latino-deluxe/SPQR-Team-2019/spqr_portfolio/pics/Cattura.PNG

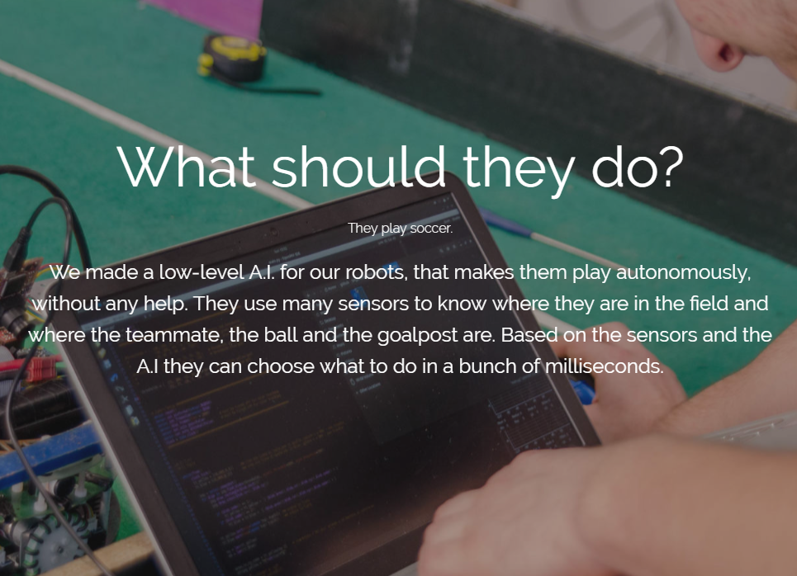
spqr_portfolio/pics/Cattura.PNG
