latino-deluxe/SPQR-Team-2019/spqr_portfolio/pics/DSC_0512_v1 (1).JPG

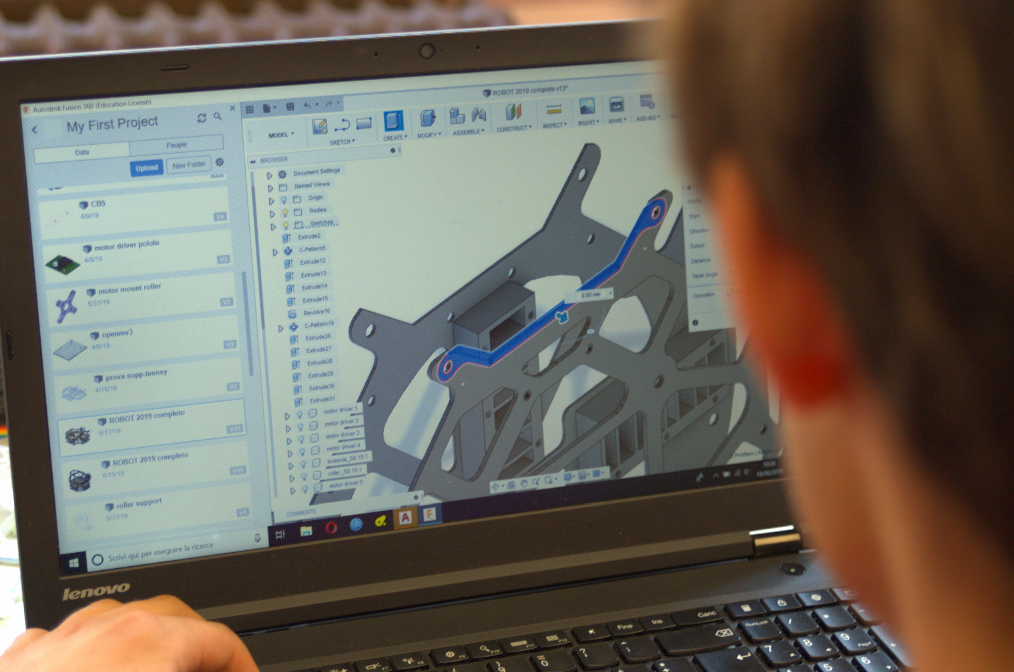
spqr_portfolio/pics/DSC_0512_v1 (1).JPG
