latino-deluxe/SPQR-Team-2019/README.md

# SPQR-Team-2019
Repo privata con il codice aggiornato dell'anno 2018-2019
