latino-deluxe/SPQR-Team-2019/damnpecette/pecette.odt

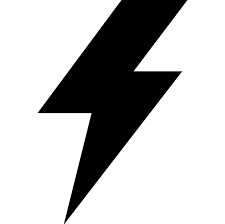
[picture p10: figure]

FURIO

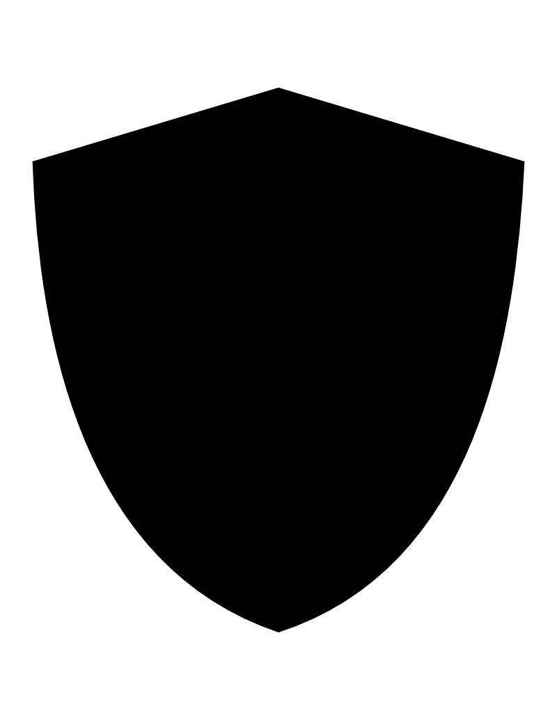
[picture p11: figure]

CORNELIA
