latino-deluxe/SPQR-Team-2019/bible/old_bible/robots.docx

SALVADOR

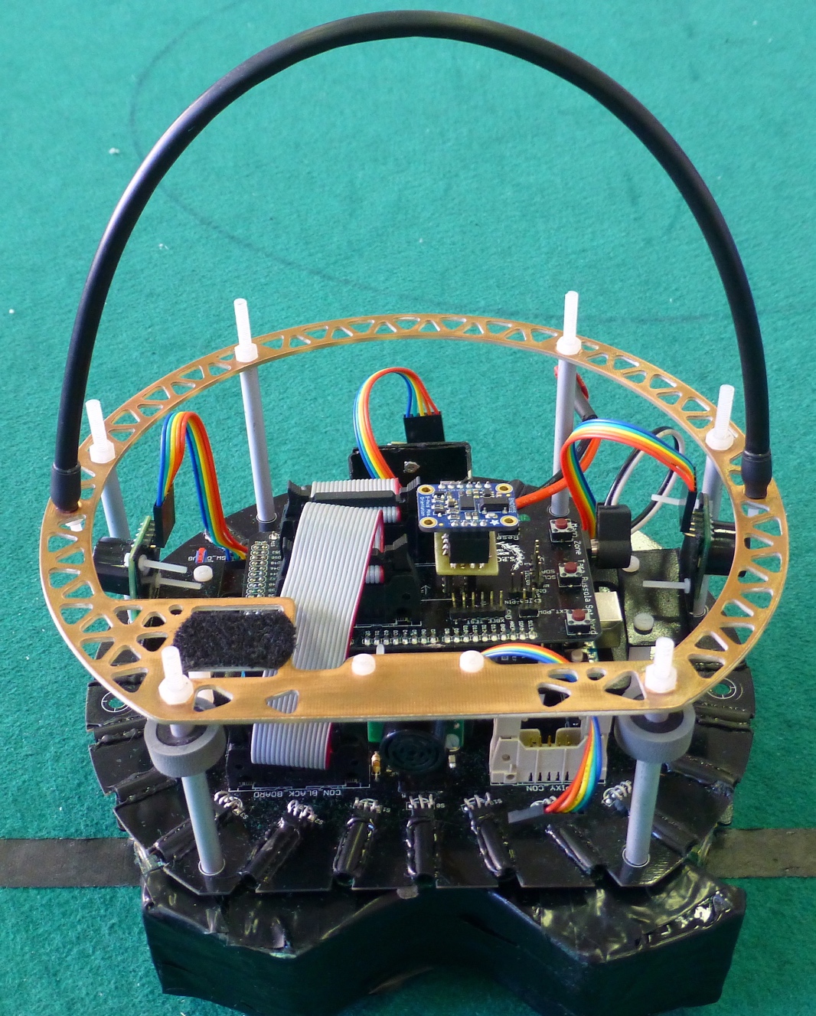
[picture p12: figure]

- Age: just born
- Role: goal keeper
- Electronics: New boards, IMU, line sensors
- Mechanics: New CAD design, handle and columns
- Software: New strategy

MANFREUS

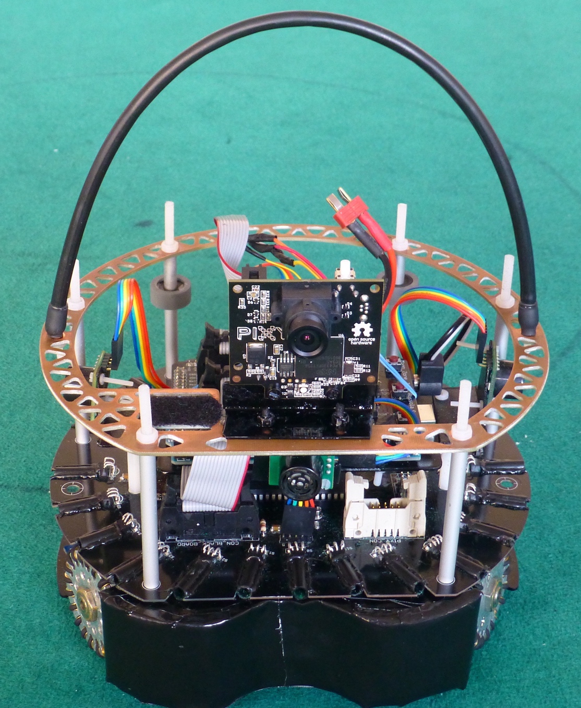
[picture p13: figure]

- Age: just born
- Role: goalie
- Electronics: New boards, IMU, line sensors, Pixy
- Mechanics: New CAD design, handle and columns
- Software: New strategy
