latino-deluxe/SPQR-Team-2019/bible/old_bible/schedaPalla.docx

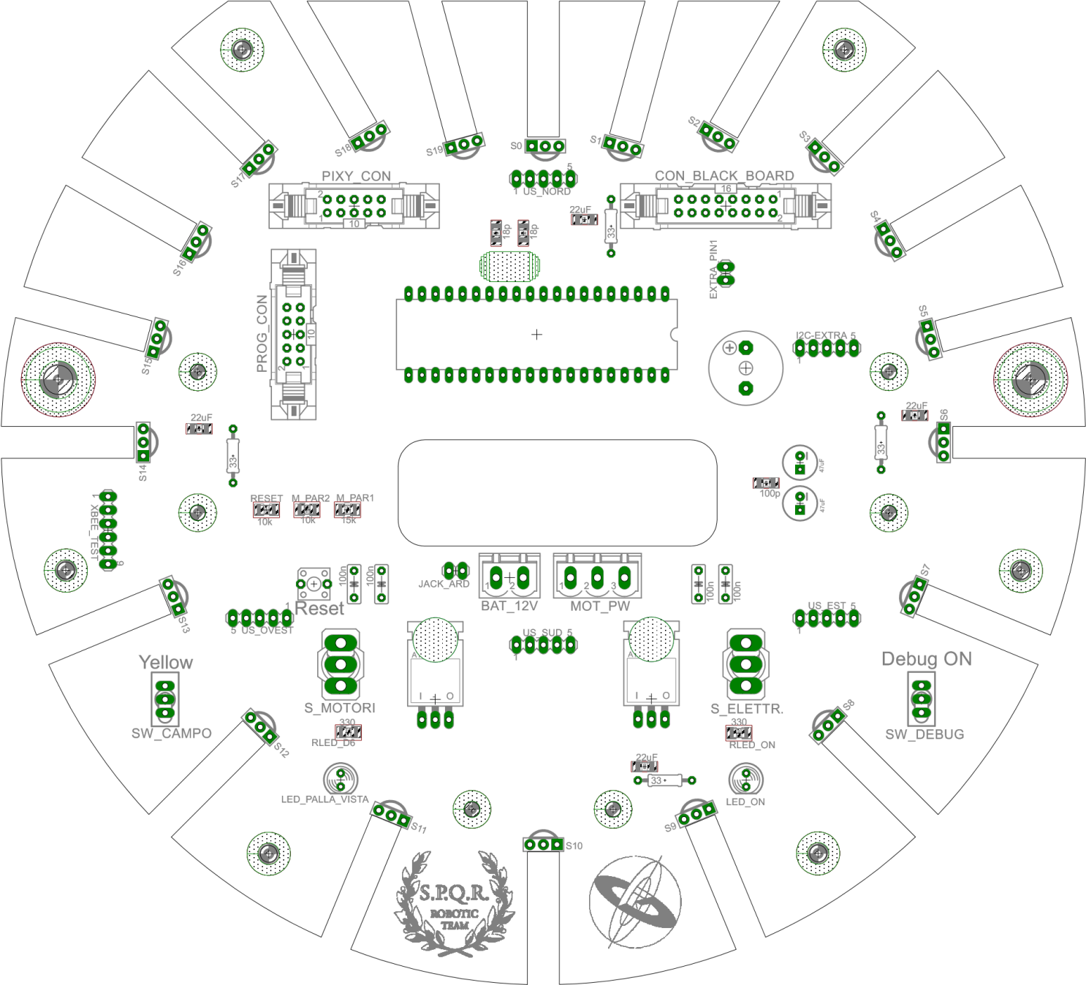
[picture p14: figure]
