latino-deluxe/SPQR-Team-2019/bible/frontpage/frontpage.png

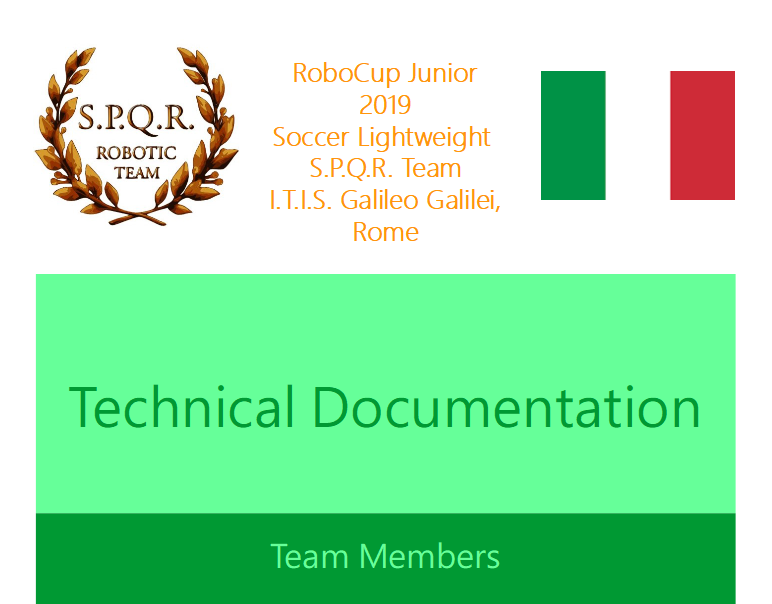
bible/frontpage/frontpage.png
