latino-deluxe/SPQR-Team-2019/bible/hardware/BLOCKDIAGRAMV1.png

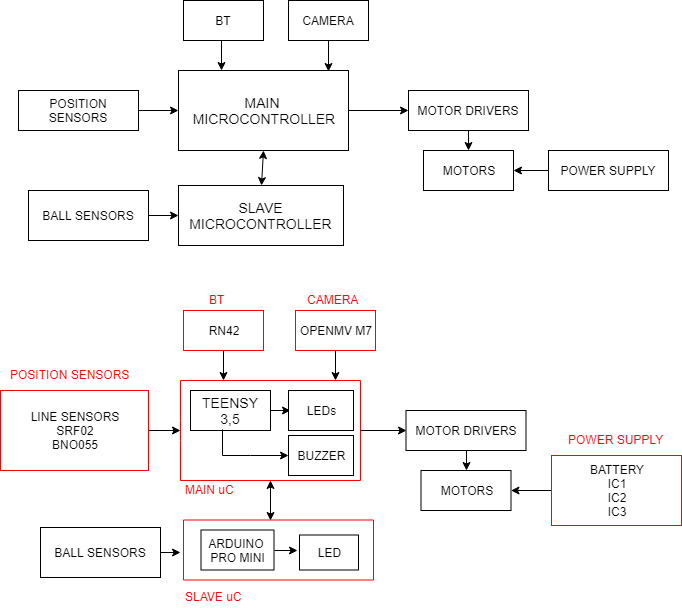
bible/hardware/BLOCKDIAGRAMV1.png
