latino-deluxe/SPQR-Team-2019/bible/hardware/connectors/signcon.png

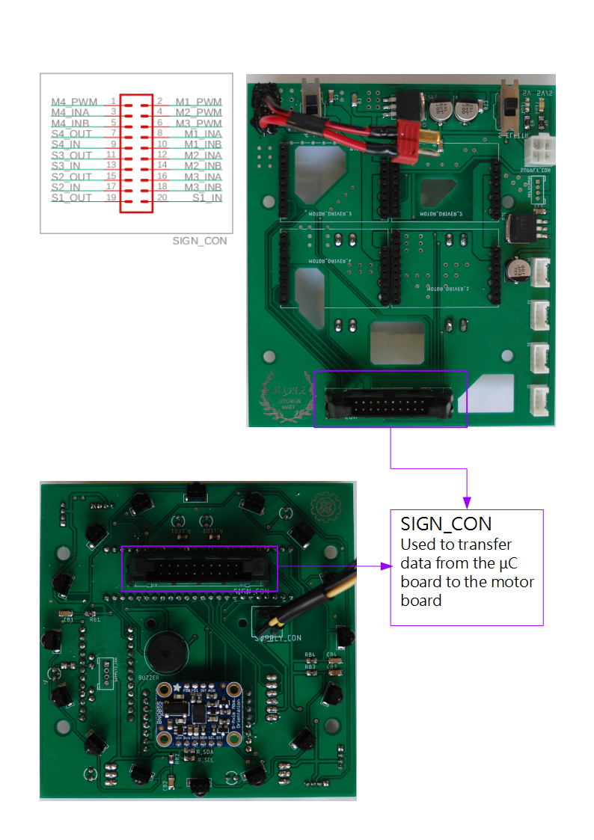
bible/hardware/connectors/signcon.png
