latino-deluxe/SPQR-Team-2019/bible/hardware/connectors/supply2.png

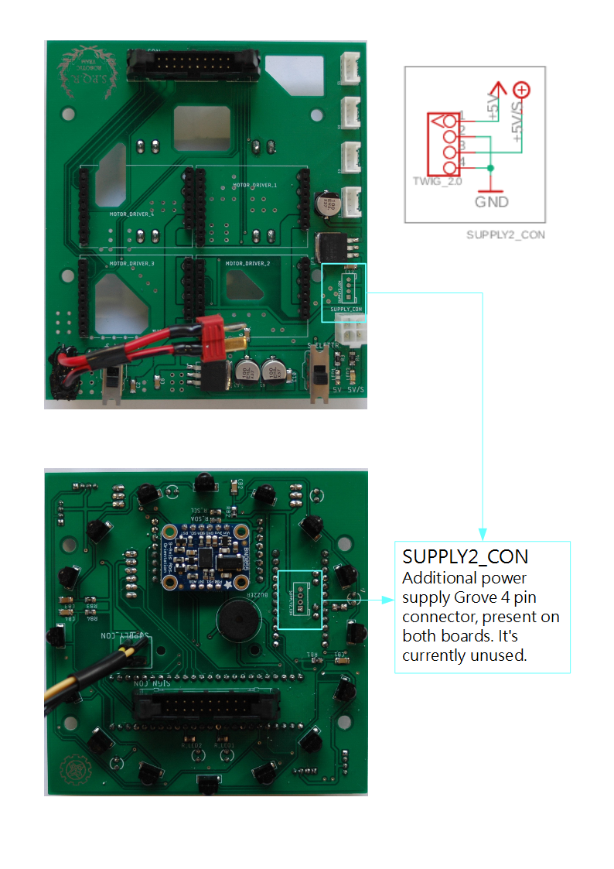
bible/hardware/connectors/supply2.png
