latino-deluxe/SPQR-Team-2019/bible/hardware/connectors/supply.png

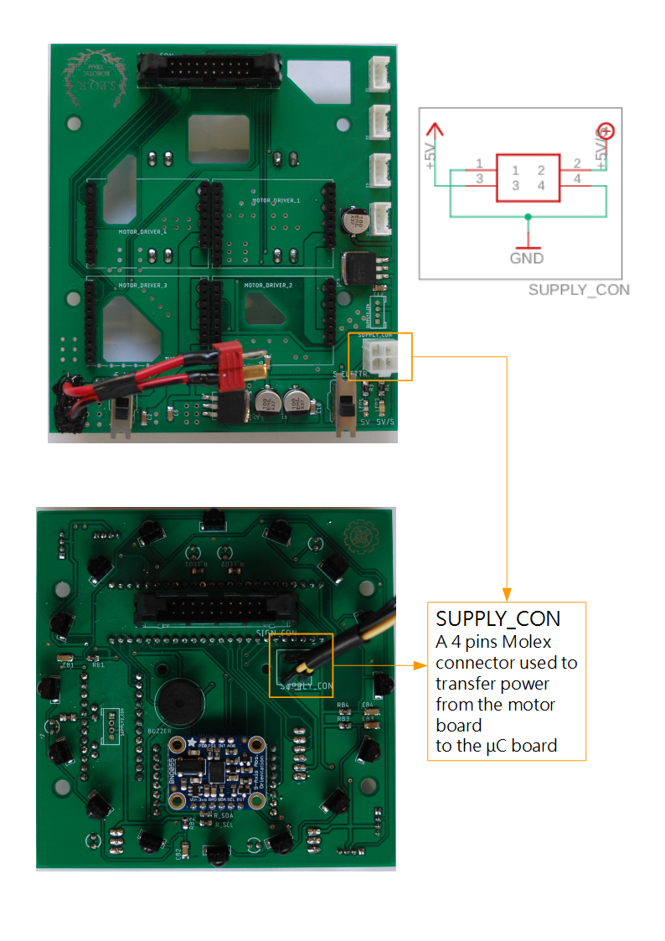
bible/hardware/connectors/supply.png
