latino-deluxe/SPQR-Team-2019/bible/hardware/linesensors/DSC_0531_v1.jpg

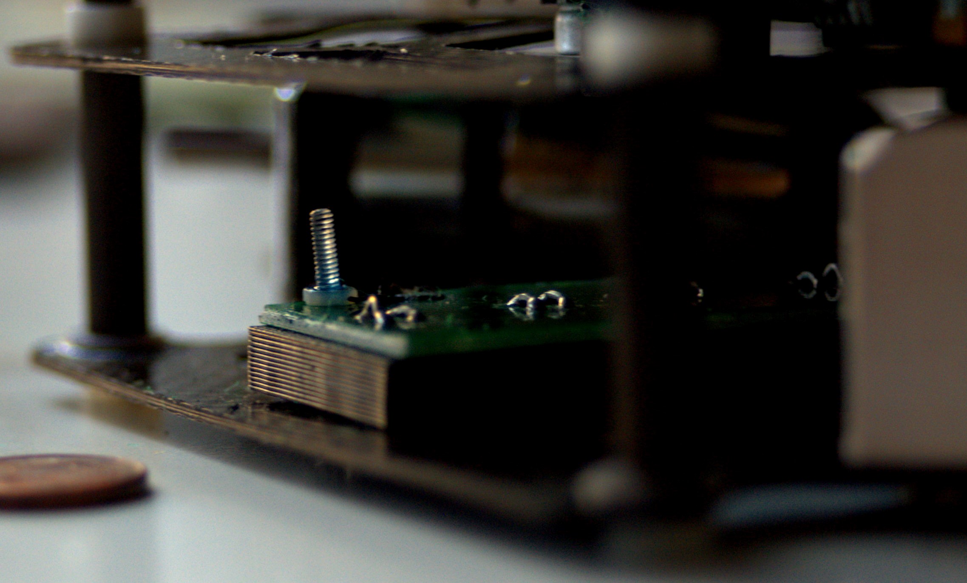
bible/hardware/linesensors/DSC_0531_v1.jpg
