latino-deluxe/SPQR-Team-2019/bible/hardware/linesensors/DSC_0546.JPG

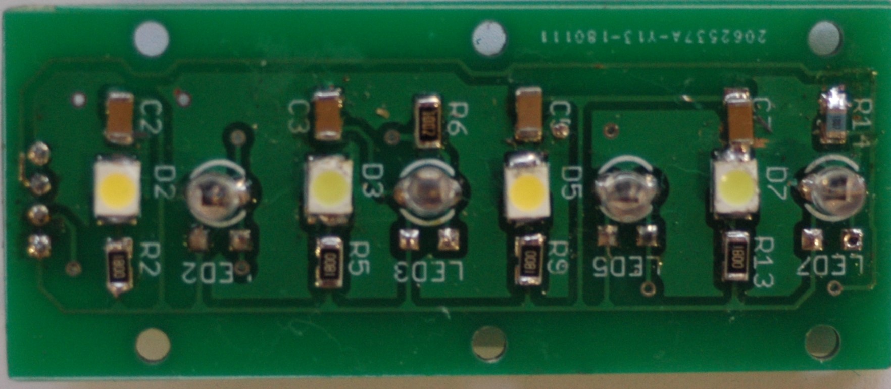
bible/hardware/linesensors/DSC_0546.JPG
