latino-deluxe/SPQR-Team-2019/bible/hardware/linesensors/DSC_0547.JPG

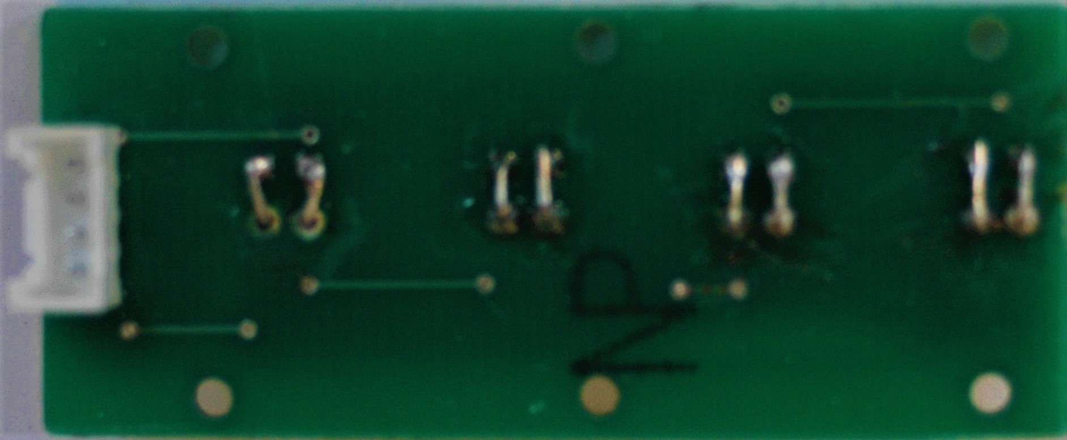
bible/hardware/linesensors/DSC_0547.JPG
