latino-deluxe/SPQR-Team-2019/bible/hardware/linesensors/Line sensors bottom.png

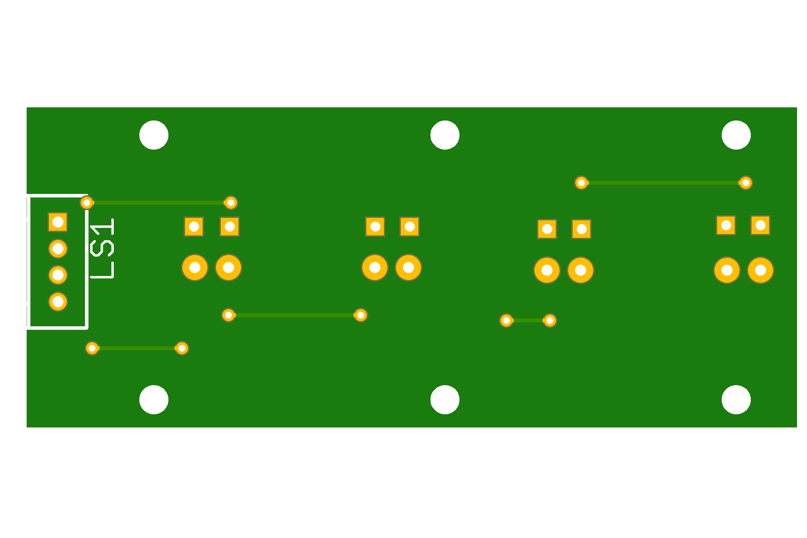
bible/hardware/linesensors/Line sensors bottom.png
