latino-deluxe/SPQR-Team-2019/bible/hardware/linesensors/Line sensors bottomsh.png

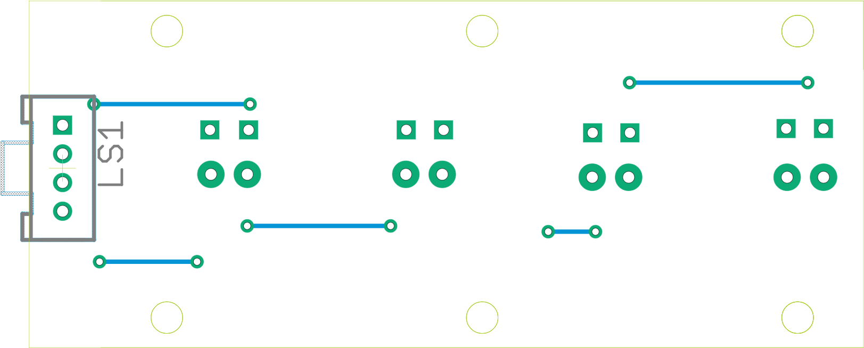
bible/hardware/linesensors/Line sensors bottomsh.png
