latino-deluxe/SPQR-Team-2019/bible/hardware/linesensors/Line sensors top.png

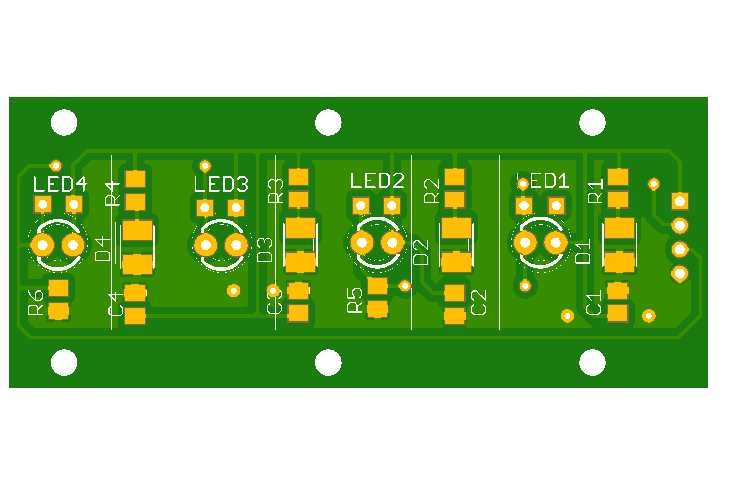
bible/hardware/linesensors/Line sensors top.png
