latino-deluxe/SPQR-Team-2019/bible/hardware/linesensors/Line sensors topsh.png

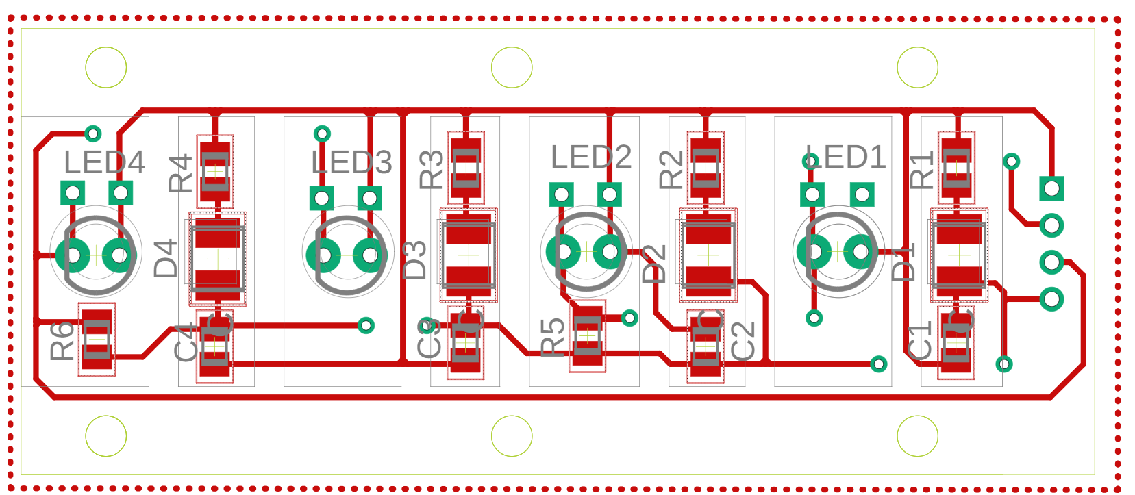
bible/hardware/linesensors/Line sensors topsh.png
