latino-deluxe/SPQR-Team-2019/bible/hardware/linesensors/Line-sensorsbot.png

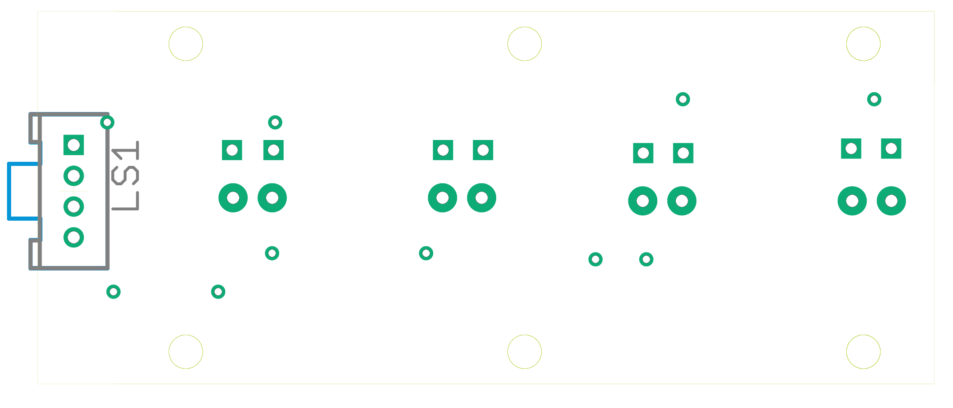
bible/hardware/linesensors/Line-sensorsbot.png
