latino-deluxe/SPQR-Team-2019/bible/hardware/linesensors/Line-sensorstop.png

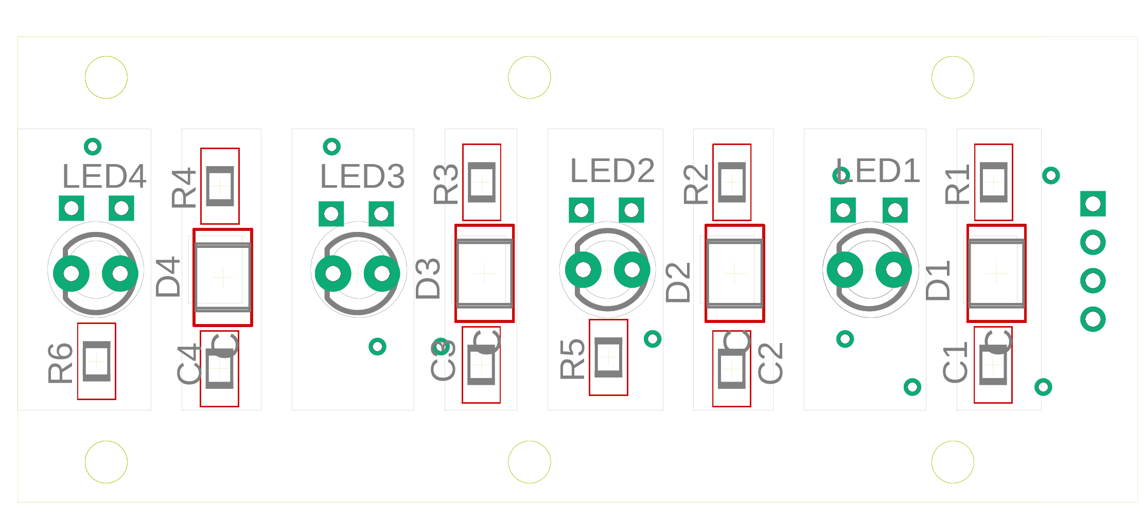
bible/hardware/linesensors/Line-sensorstop.png
