latino-deluxe/SPQR-Team-2019/bible/hardware/linesensors/linesch.png

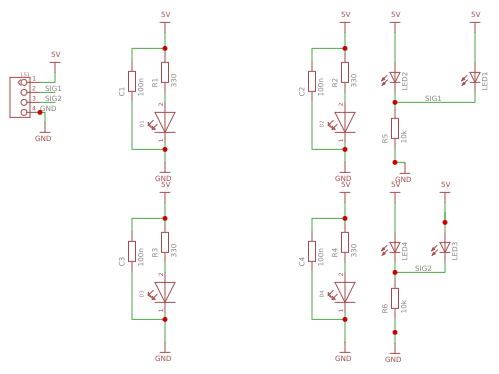
bible/hardware/linesensors/linesch.png
