latino-deluxe/SPQR-Team-2019/bible/hardware/linesensors/uawduwqgqwfe.png

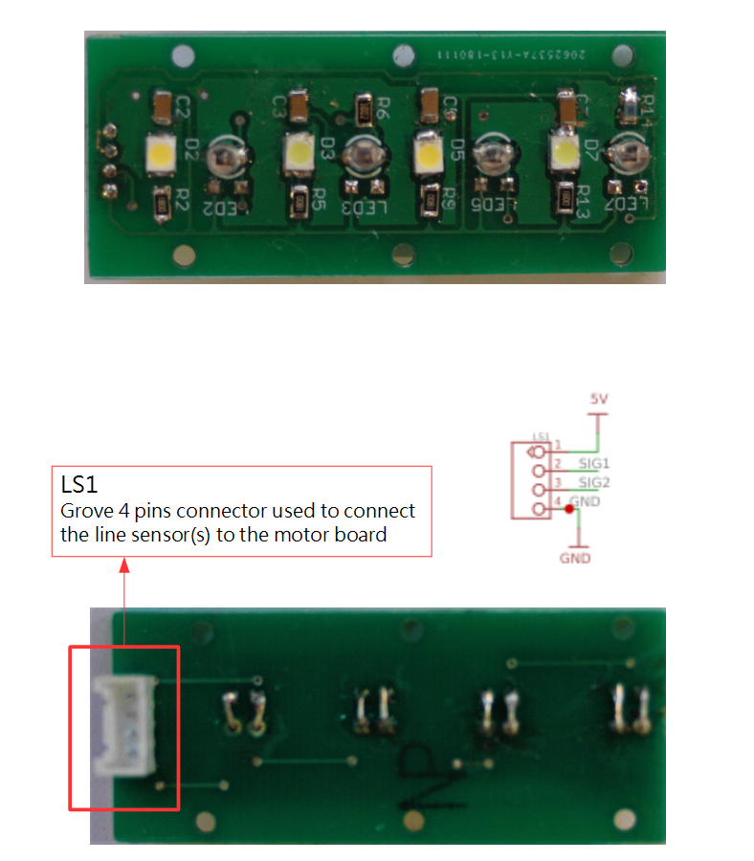
bible/hardware/linesensors/uawduwqgqwfe.png
