latino-deluxe/SPQR-Team-2019/bible/hardware/motor board/DSC_0500.JPG

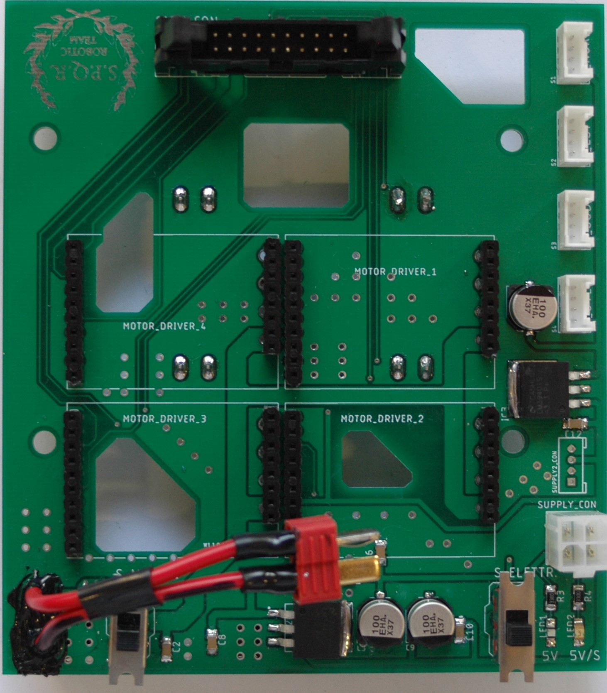
bible/hardware/motor board/DSC_0500.JPG
