latino-deluxe/SPQR-Team-2019/bible/hardware/motor board/DSC_0503.JPG

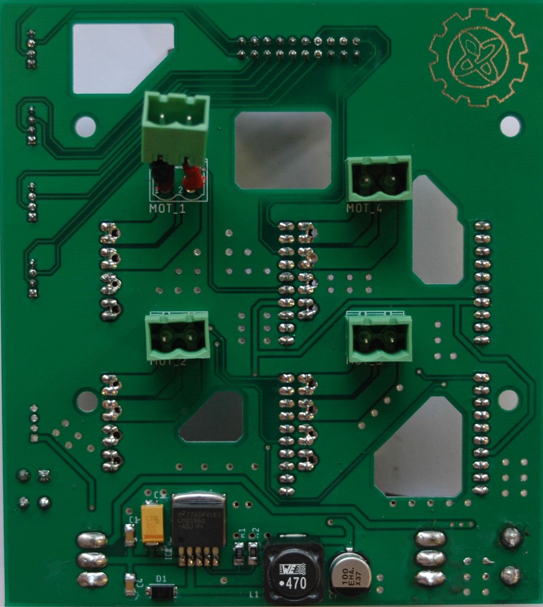
bible/hardware/motor board/DSC_0503.JPG
