latino-deluxe/SPQR-Team-2019/bible/hardware/motor board/ic1.png

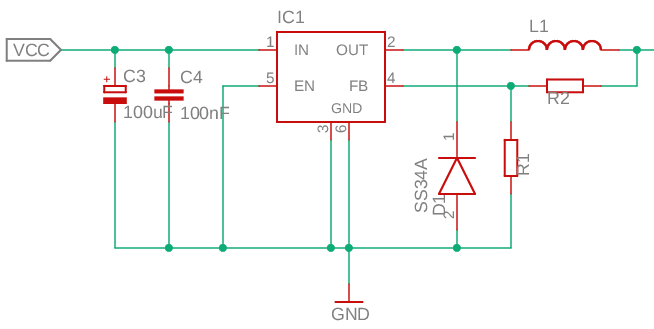
bible/hardware/motor board/ic1.png
