latino-deluxe/SPQR-Team-2019/bible/hardware/motor board/ic2.png

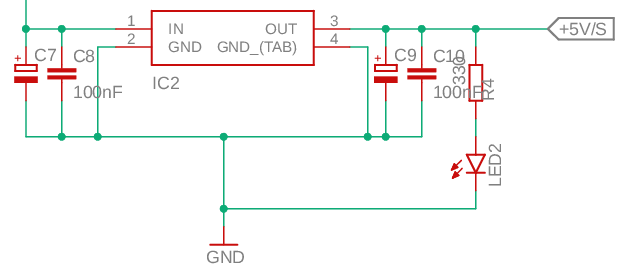
bible/hardware/motor board/ic2.png
