latino-deluxe/SPQR-Team-2019/bible/hardware/motor board/ic3sch.png

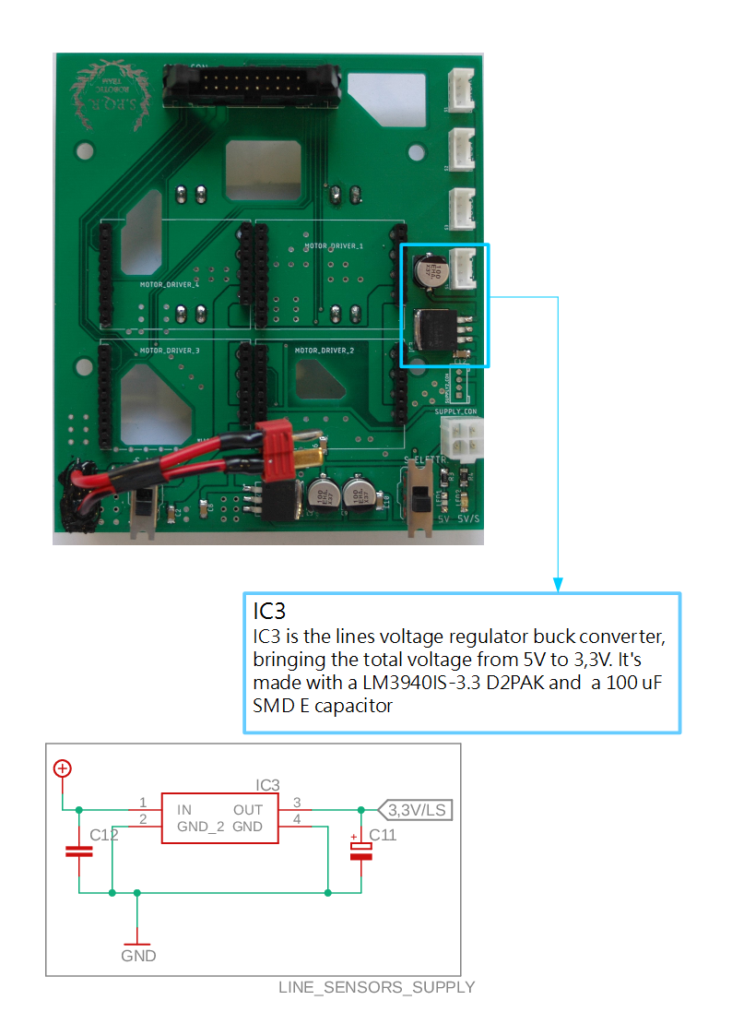
bible/hardware/motor board/ic3sch.png
