latino-deluxe/SPQR-Team-2019/bible/hardware/motor board/lines.png

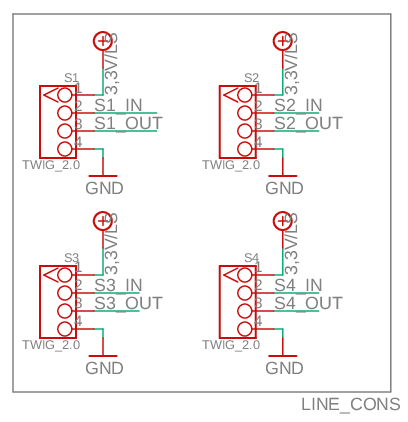
bible/hardware/motor board/lines.png
