latino-deluxe/SPQR-Team-2019/bible/hardware/motor board/mainsupply.png

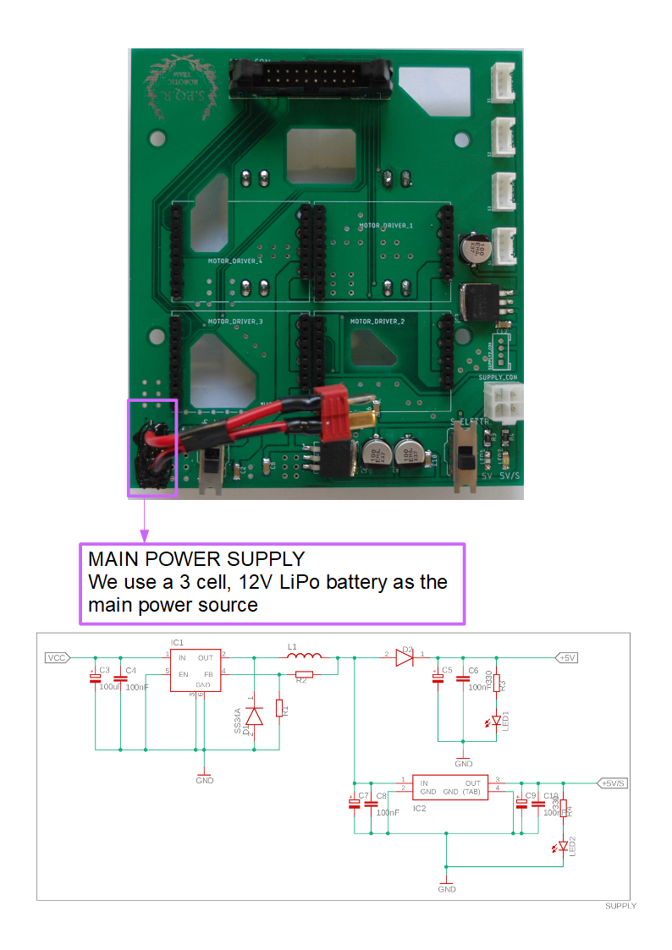
bible/hardware/motor board/mainsupply.png
