latino-deluxe/SPQR-Team-2019/bible/hardware/motor board/mainswitch.png

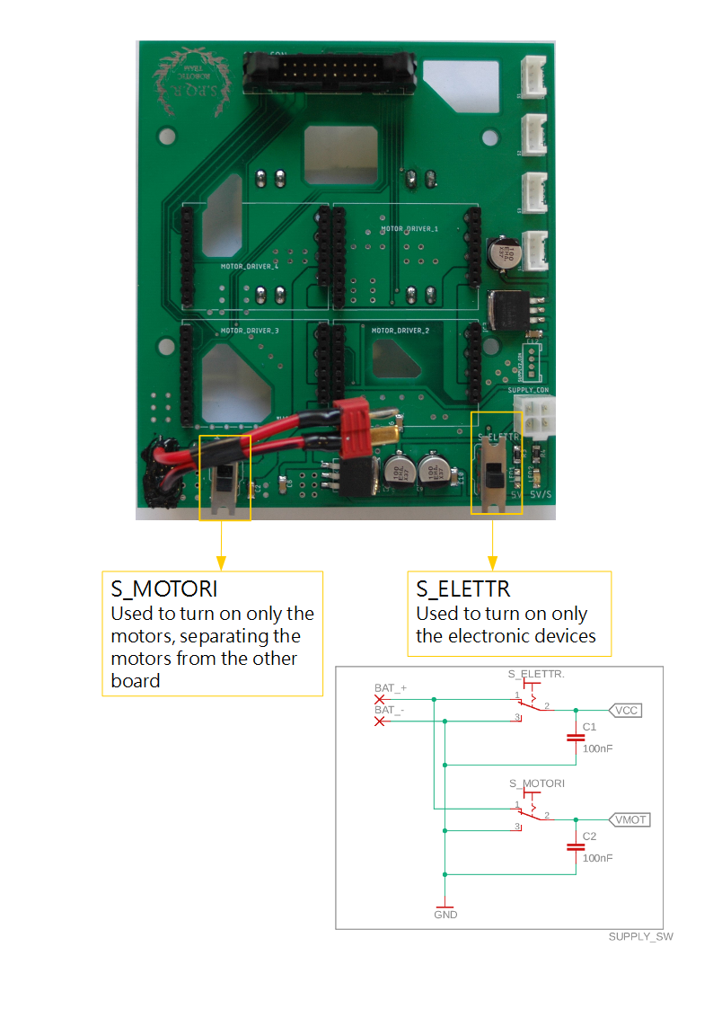
bible/hardware/motor board/mainswitch.png
