latino-deluxe/SPQR-Team-2019/bible/hardware/motor board/mot cons.png

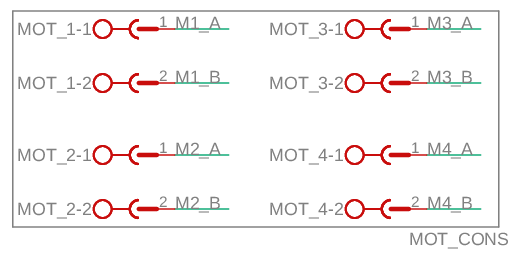
bible/hardware/motor board/mot cons.png
