latino-deluxe/SPQR-Team-2019/bible/hardware/motor board/motcon.png

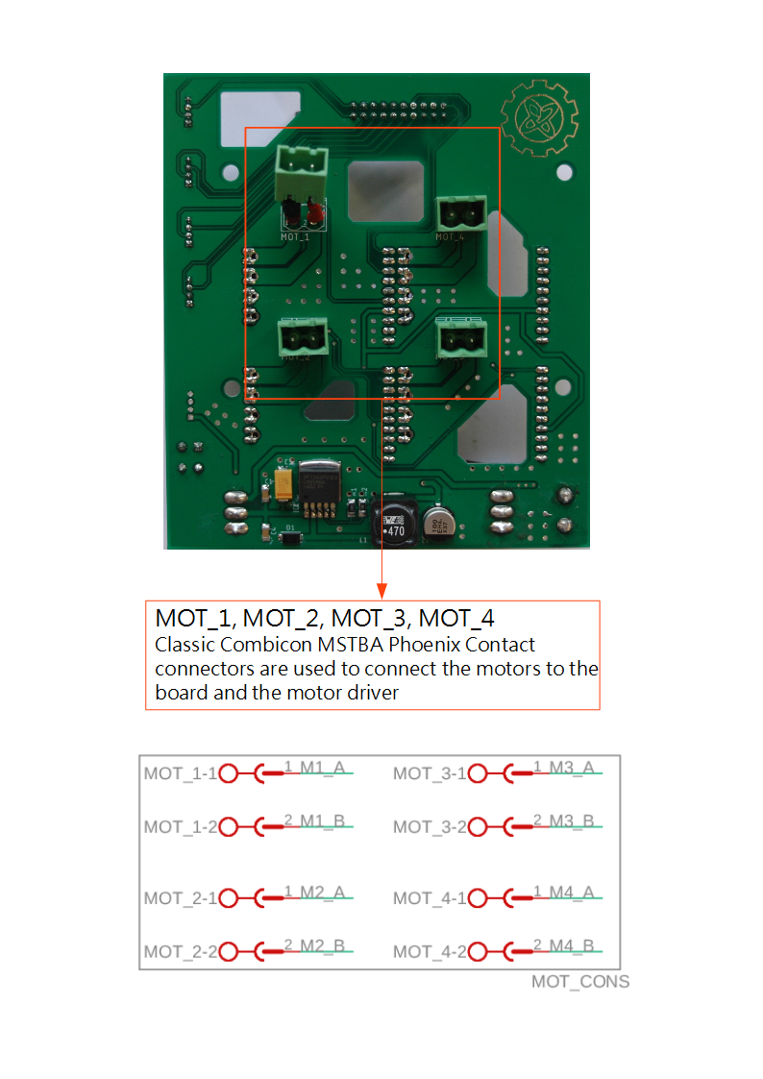
bible/hardware/motor board/motcon.png
