latino-deluxe/SPQR-Team-2019/bible/hardware/motor board/Motor board bottom.png

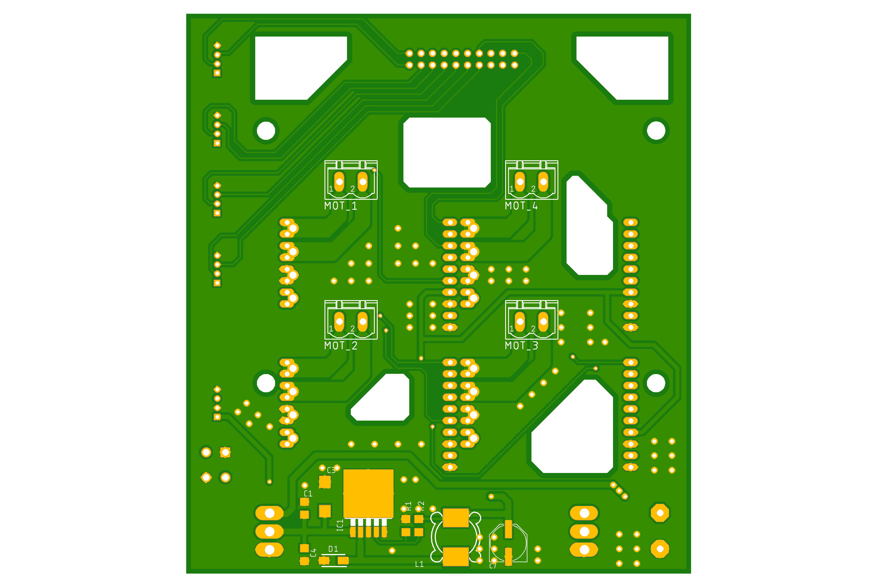
bible/hardware/motor board/Motor board bottom.png
