latino-deluxe/SPQR-Team-2019/bible/hardware/motor board/Motor board bottomsh.png

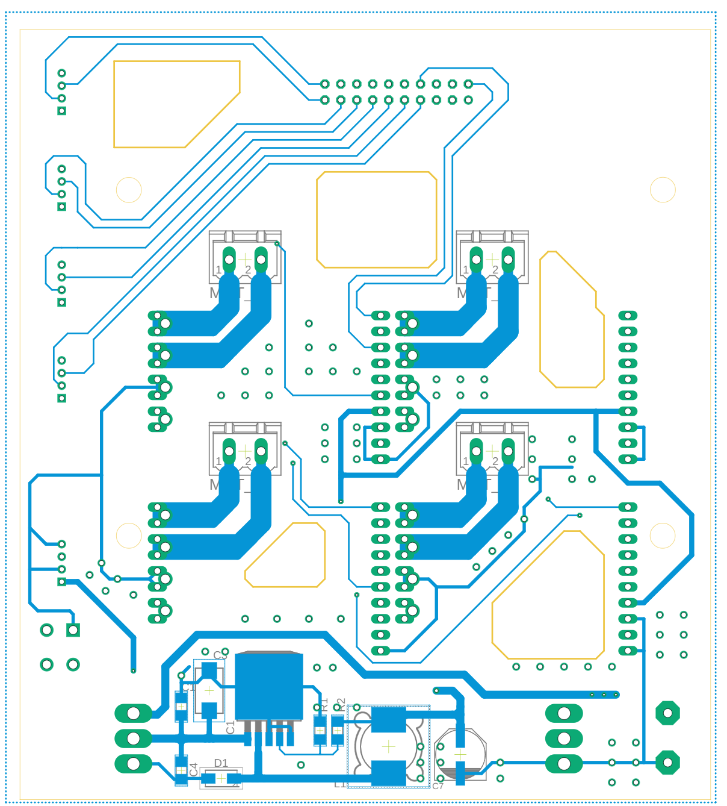
bible/hardware/motor board/Motor board bottomsh.png
