latino-deluxe/SPQR-Team-2019/bible/hardware/motor board/Motor board top.png

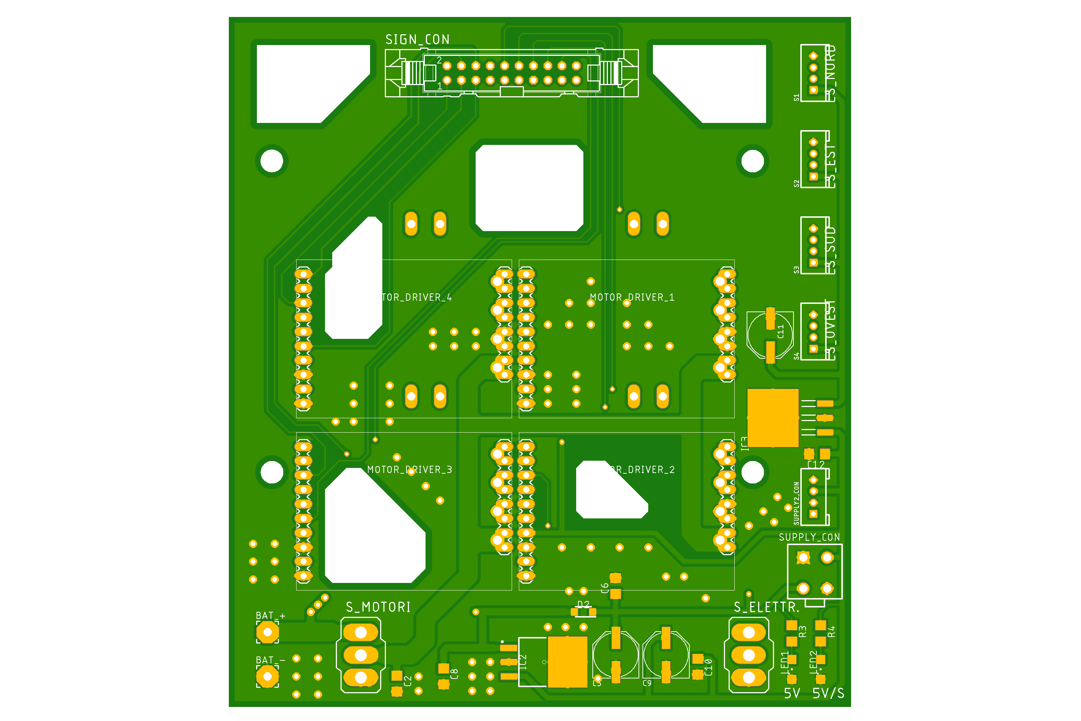
bible/hardware/motor board/Motor board top.png
