latino-deluxe/SPQR-Team-2019/bible/hardware/motor board/Motor board topsh.png

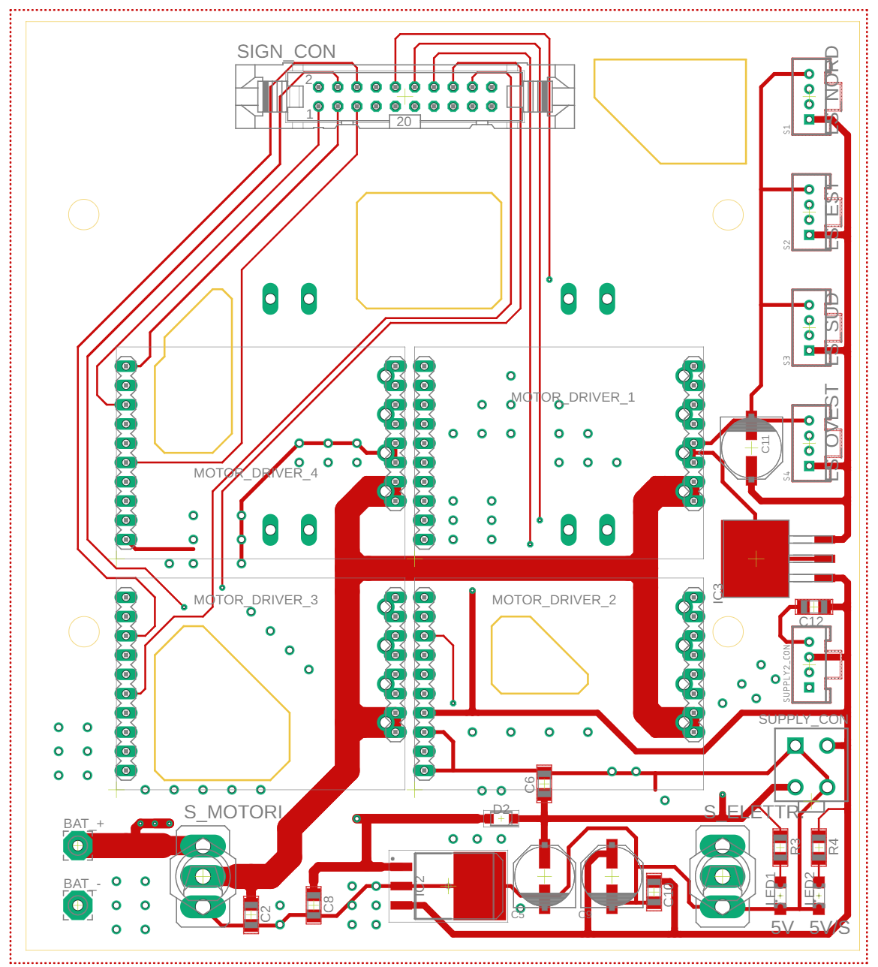
bible/hardware/motor board/Motor board topsh.png
