latino-deluxe/SPQR-Team-2019/bible/hardware/motor board/Motor-boardlayout2.png

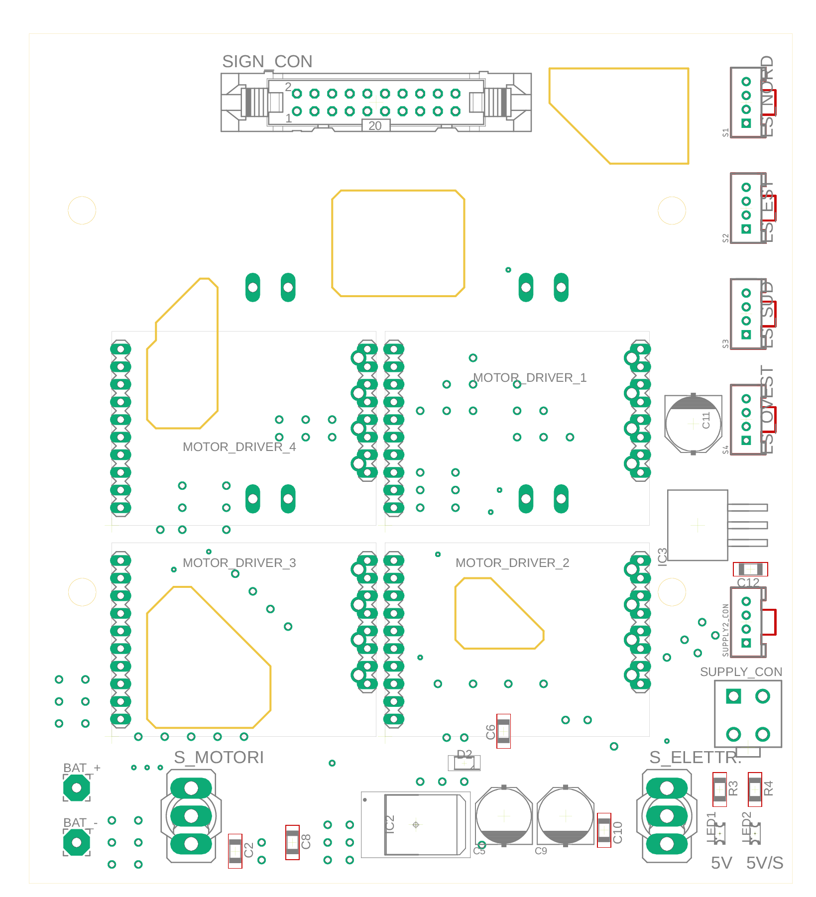
bible/hardware/motor board/Motor-boardlayout2.png
