latino-deluxe/SPQR-Team-2019/bible/hardware/motor board/Motor-boardlayout.png

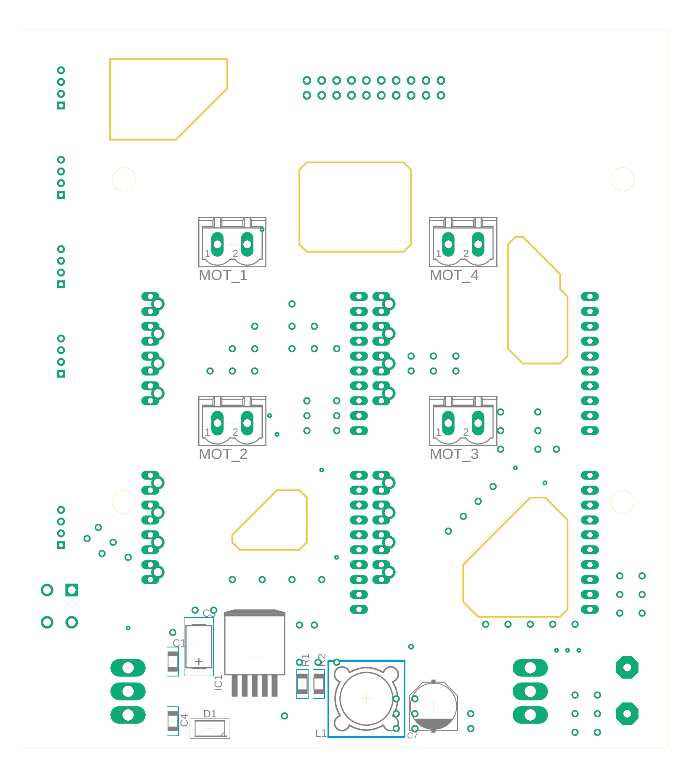
bible/hardware/motor board/Motor-boardlayout.png
