latino-deluxe/SPQR-Team-2019/bible/hardware/motor board/Motordrivers.png

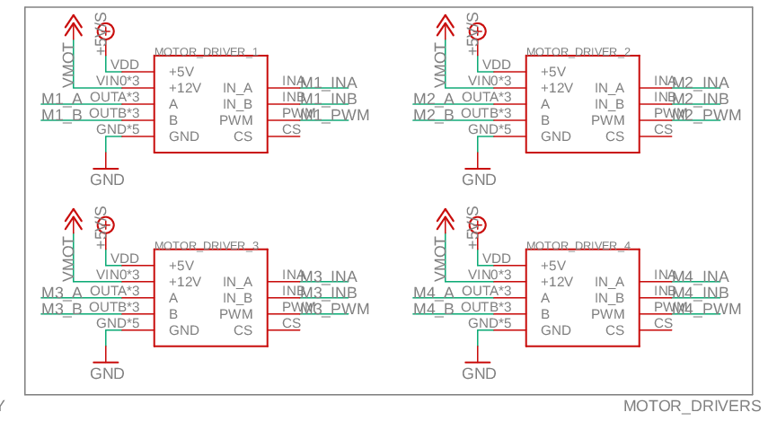
bible/hardware/motor board/Motordrivers.png
