latino-deluxe/SPQR-Team-2019/bible/hardware/motor board/supply.png

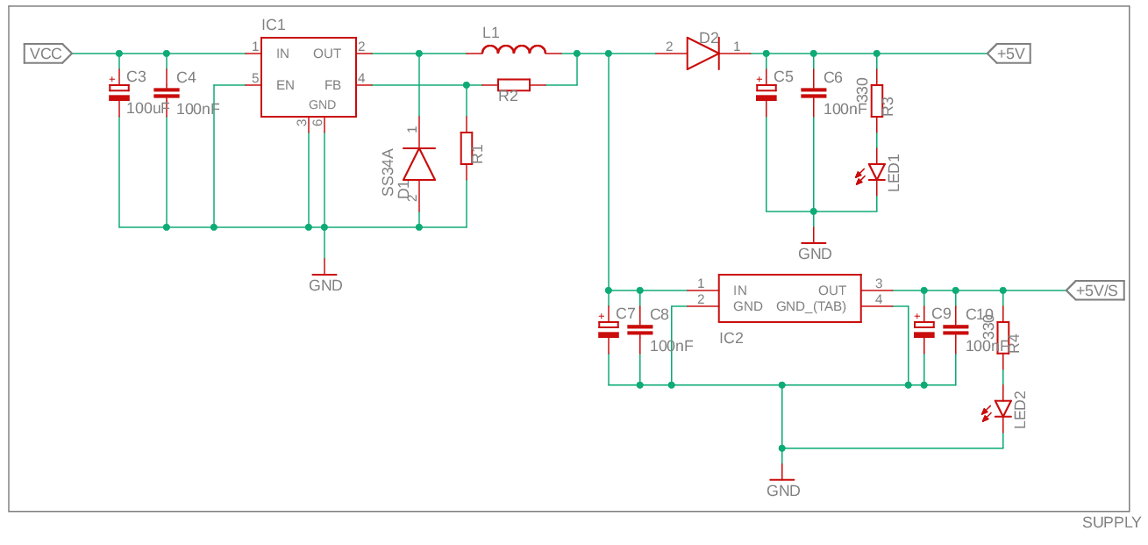
bible/hardware/motor board/supply.png
