latino-deluxe/SPQR-Team-2019/bible/hardware/motor board/supply_com.png

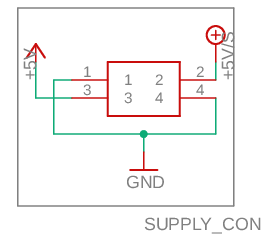
bible/hardware/motor board/supply_com.png
