latino-deluxe/SPQR-Team-2019/bible/hardware/motor board/switch.png

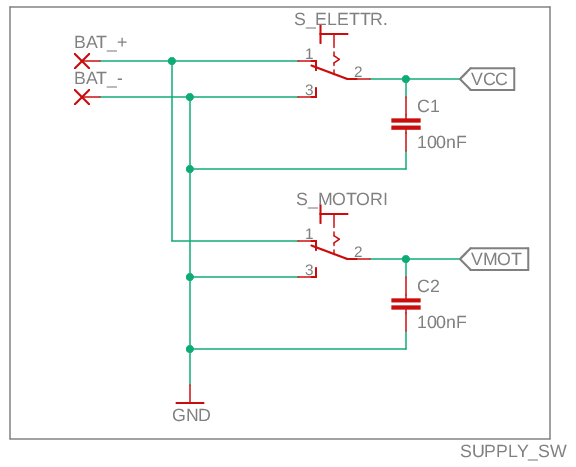
bible/hardware/motor board/switch.png
