latino-deluxe/SPQR-Team-2019/bible/hardware/uc board/ball_sensos.png

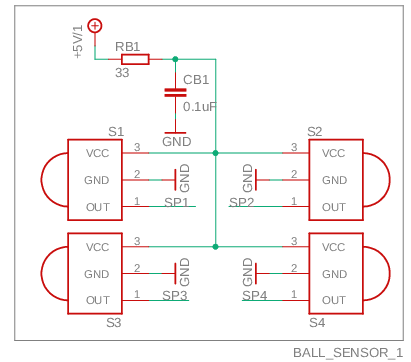
bible/hardware/uc board/ball_sensos.png
