latino-deluxe/SPQR-Team-2019/bible/hardware/uc board/bt (2).png

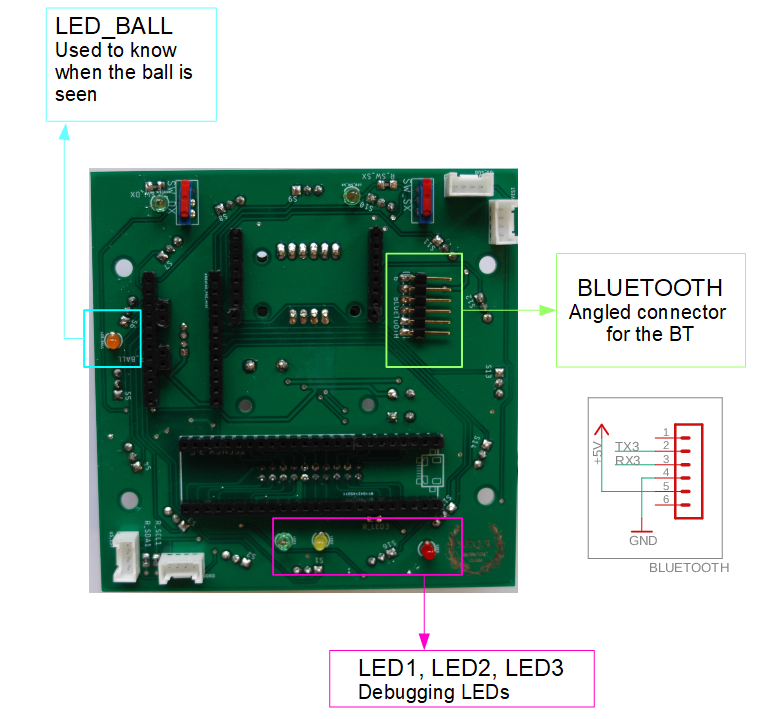
bible/hardware/uc board/bt (2).png
