latino-deluxe/SPQR-Team-2019/bible/hardware/uc board/bt.png

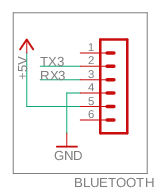
bible/hardware/uc board/bt.png
