latino-deluxe/SPQR-Team-2019/bible/hardware/uc board/buzzer.png

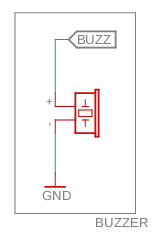
bible/hardware/uc board/buzzer.png
