latino-deluxe/SPQR-Team-2019/bible/hardware/uc board/DRAFT2.png

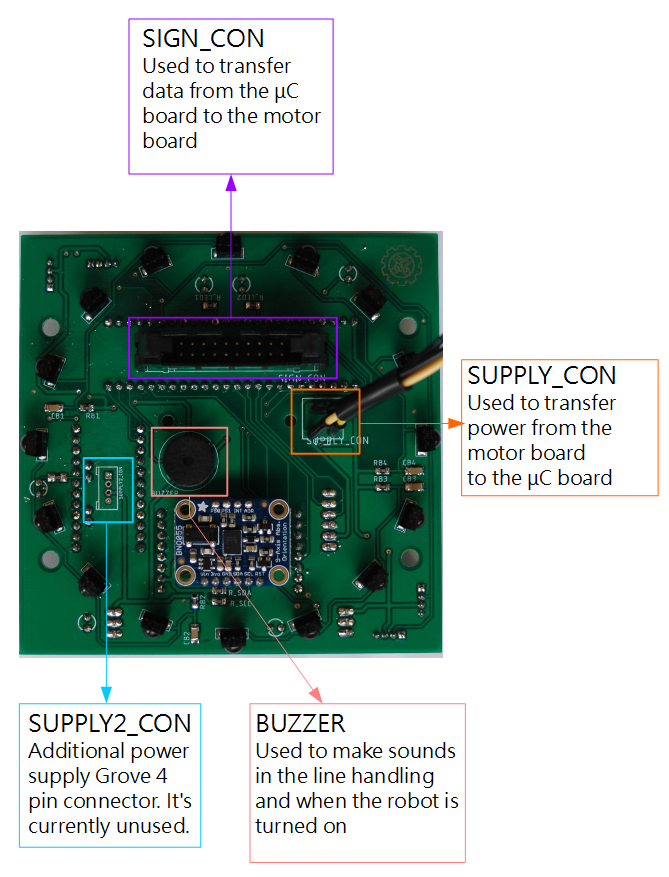
bible/hardware/uc board/DRAFT2.png
