latino-deluxe/SPQR-Team-2019/bible/hardware/uc board/DRAFT.png

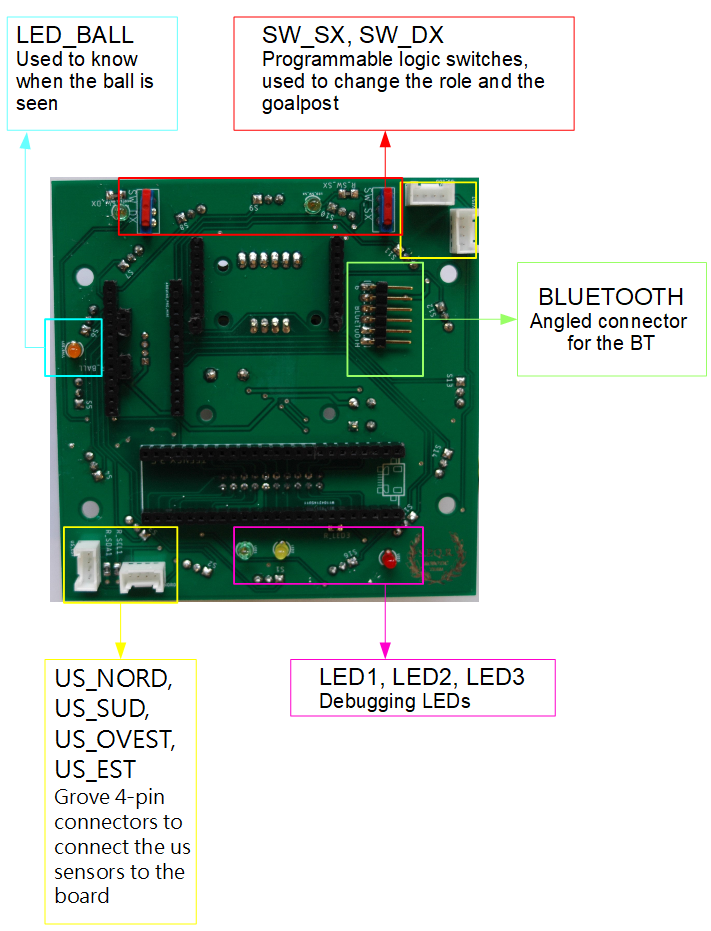
bible/hardware/uc board/DRAFT.png
