latino-deluxe/SPQR-Team-2019/bible/hardware/uc board/DSC_0505.JPG

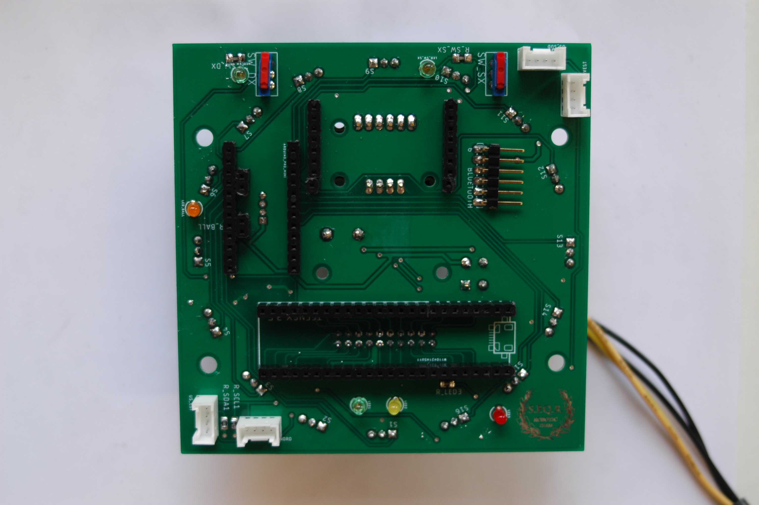
bible/hardware/uc board/DSC_0505.JPG
