latino-deluxe/SPQR-Team-2019/bible/hardware/uc board/DSC_0506.JPG

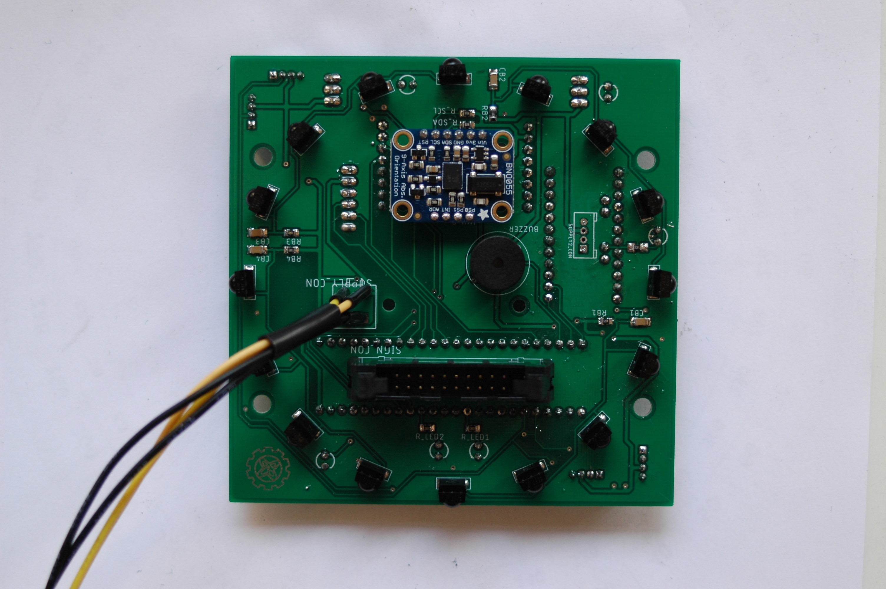
bible/hardware/uc board/DSC_0506.JPG
