latino-deluxe/SPQR-Team-2019/bible/hardware/uc board/DSC_05065.jpg

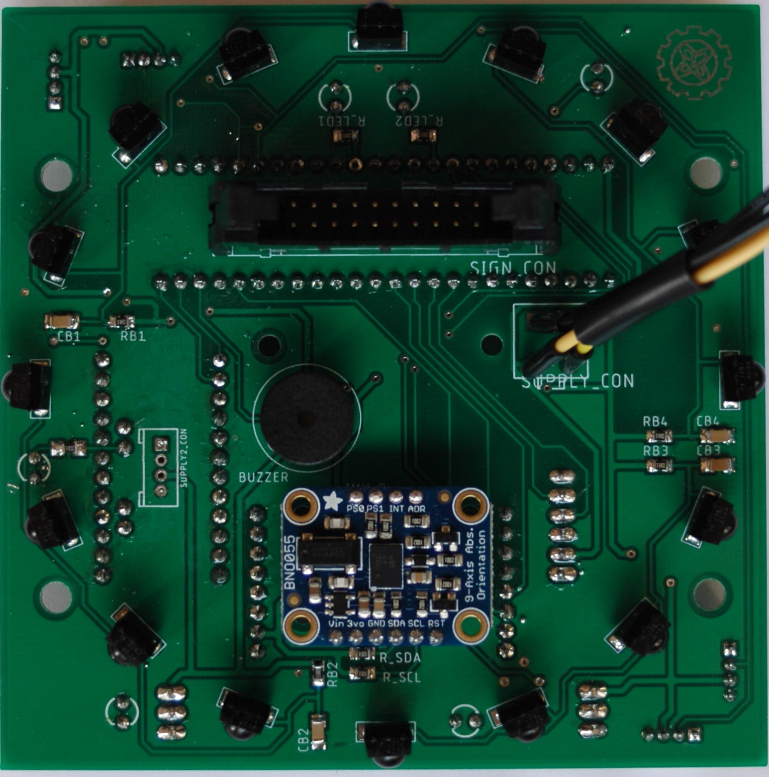
bible/hardware/uc board/DSC_05065.jpg
