latino-deluxe/SPQR-Team-2019/bible/hardware/uc board/sign_con.png

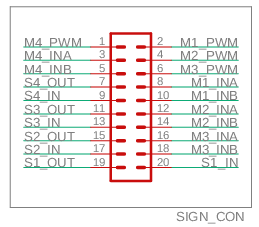
bible/hardware/uc board/sign_con.png
