latino-deluxe/SPQR-Team-2019/bible/hardware/uc board/supply2_con.png

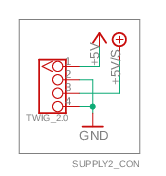
bible/hardware/uc board/supply2_con.png
