latino-deluxe/SPQR-Team-2019/bible/hardware/uc board/switch (2).png

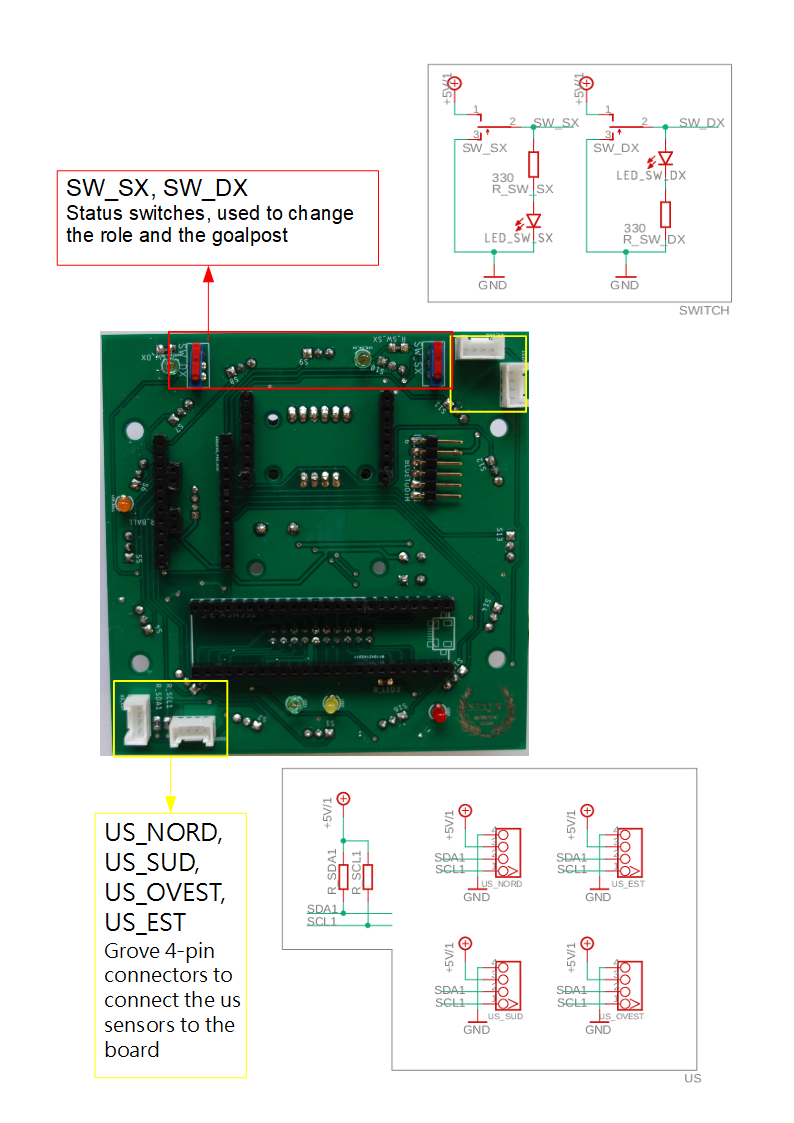
bible/hardware/uc board/switch (2).png
