latino-deluxe/SPQR-Team-2019/bible/hardware/uc board/switch.png

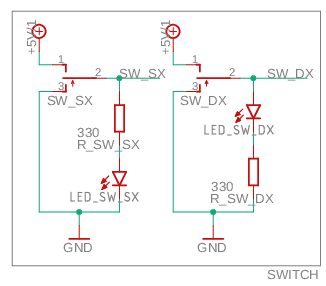
bible/hardware/uc board/switch.png
