latino-deluxe/SPQR-Team-2019/bible/hardware/uc board/uC board bottom.png

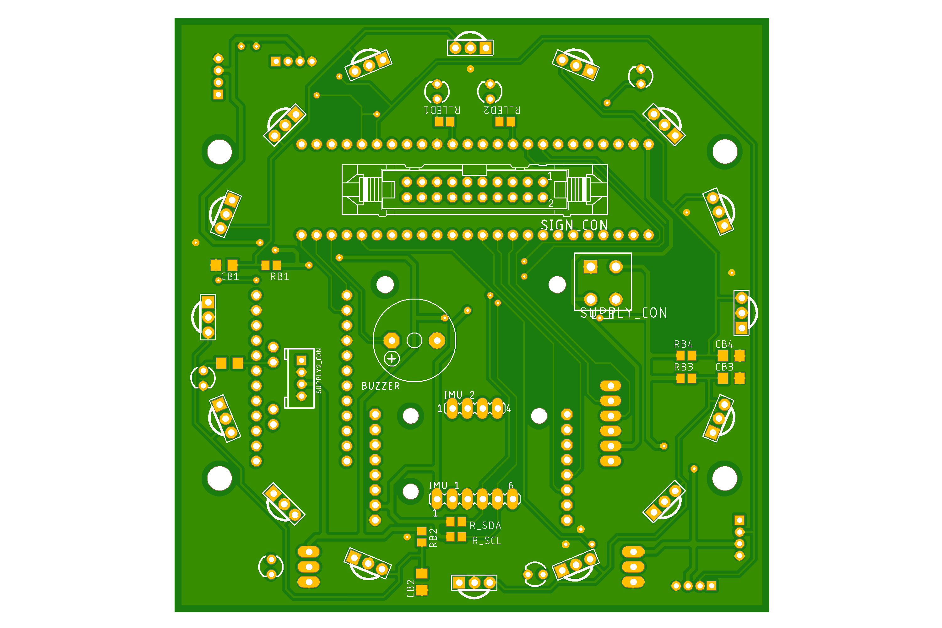
bible/hardware/uc board/uC board bottom.png
