latino-deluxe/SPQR-Team-2019/bible/hardware/uc board/uC board top.png

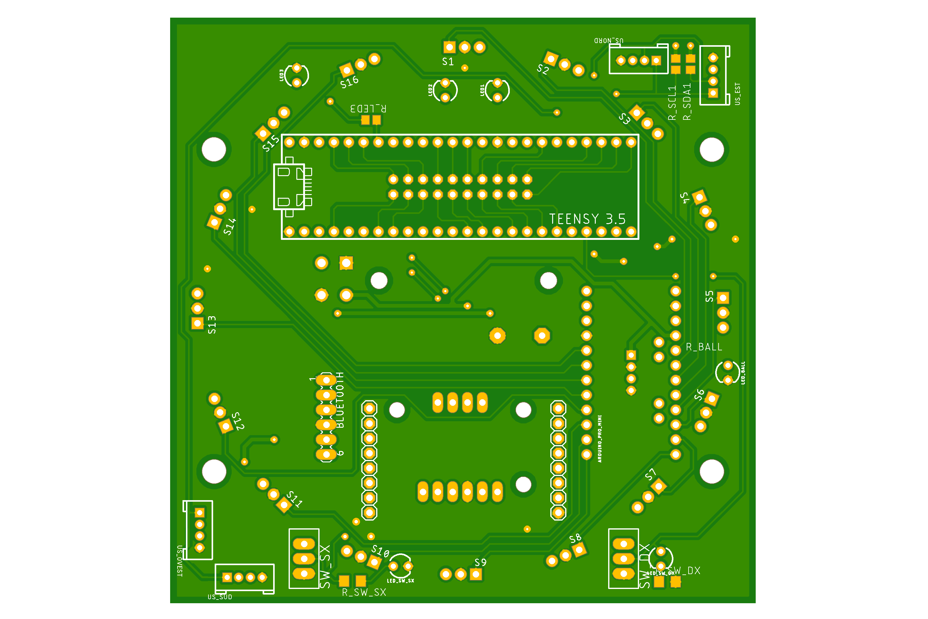
bible/hardware/uc board/uC board top.png
