latino-deluxe/SPQR-Team-2019/bible/hardware/uc board/uC board topsh.png

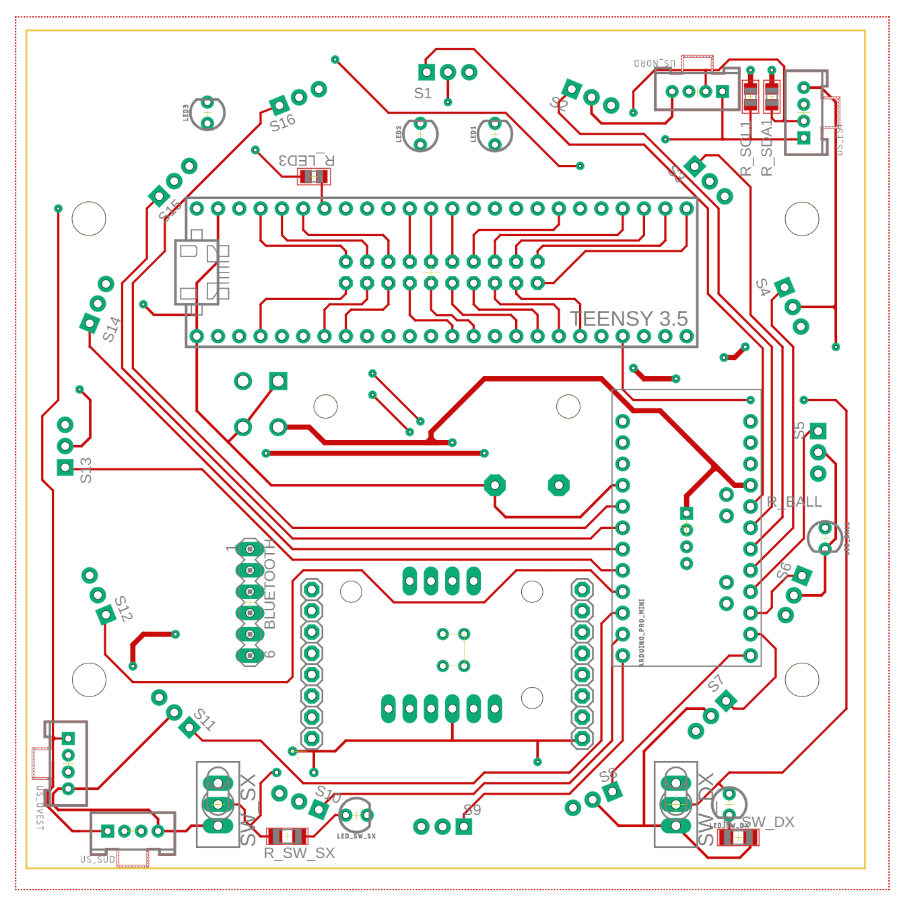
bible/hardware/uc board/uC board topsh.png
