latino-deluxe/SPQR-Team-2019/bible/hardware/uc board/uC-board.png

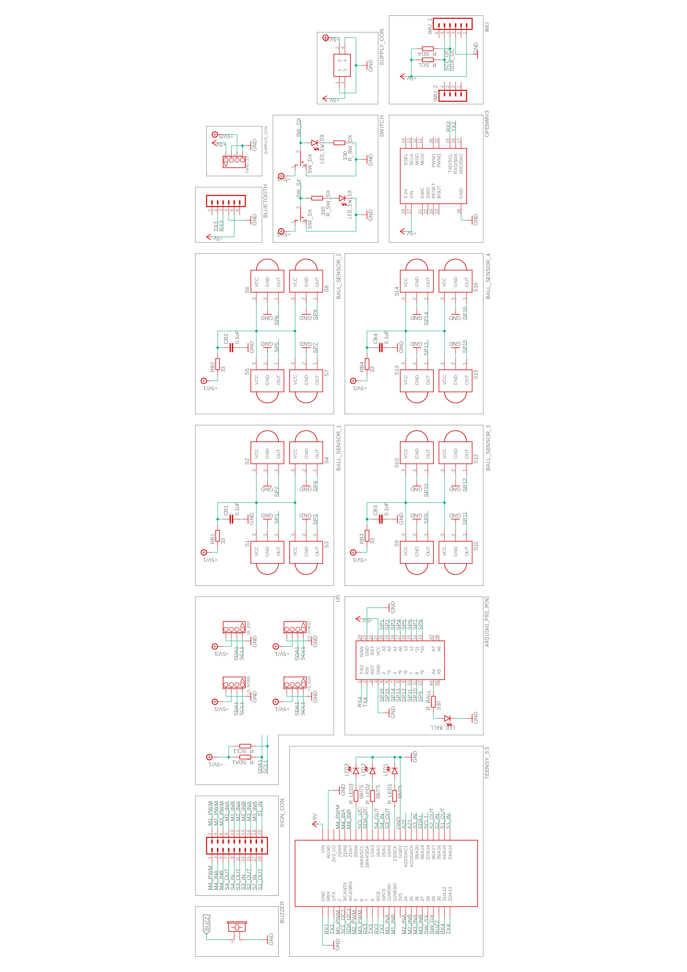
bible/hardware/uc board/uC-board.png
