latino-deluxe/SPQR-Team-2019/bible/hardware/uc board/uC-boardlayoutbot.png

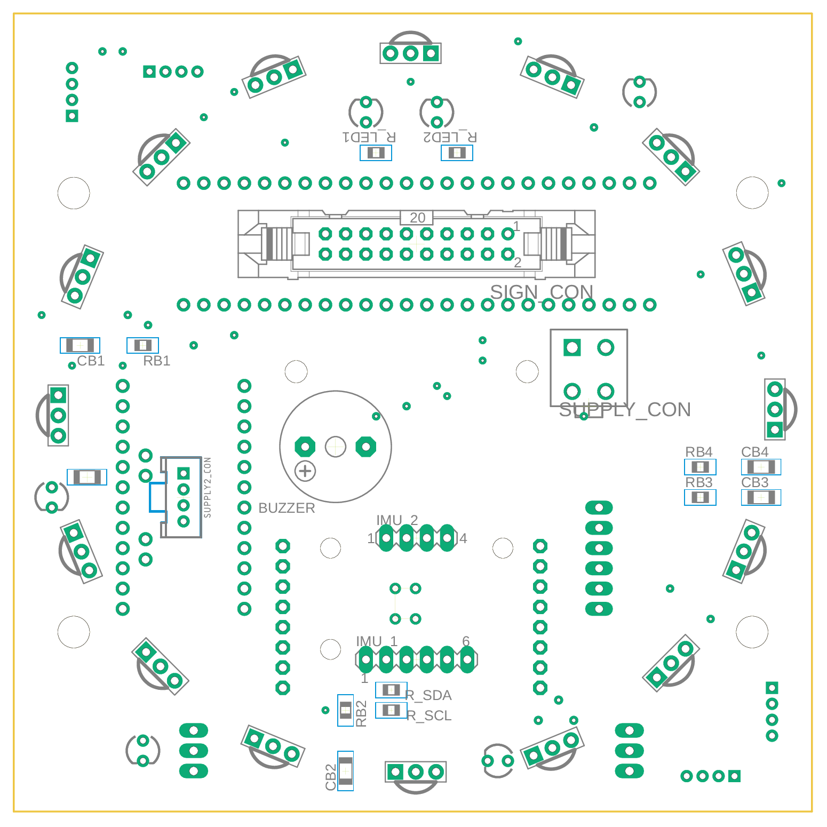
bible/hardware/uc board/uC-boardlayoutbot.png
