latino-deluxe/SPQR-Team-2019/bible/hardware/uc board/uC-boardlayouttop.png

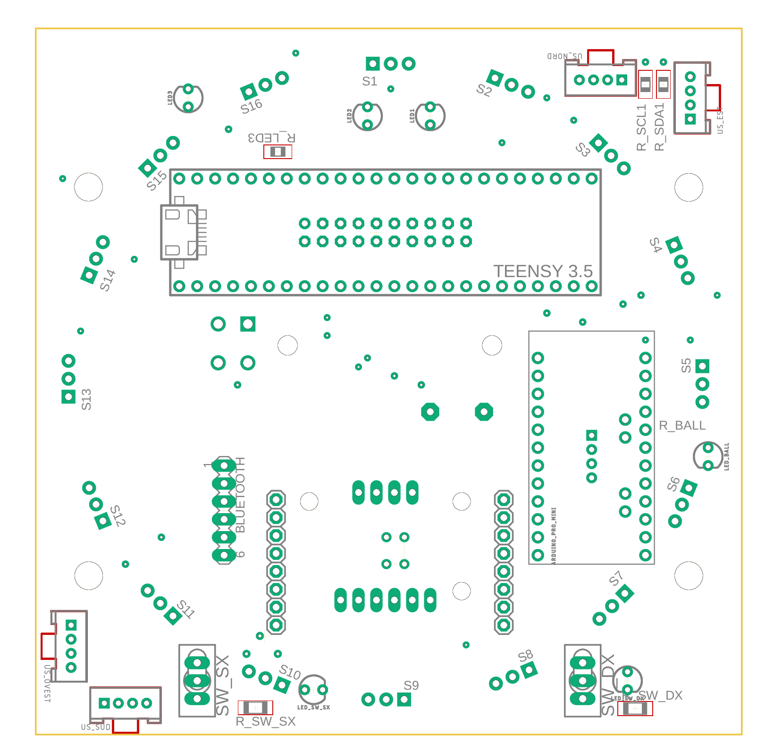
bible/hardware/uc board/uC-boardlayouttop.png
