latino-deluxe/SPQR-Team-2019/bible/hardware/uc board/uC-boardsch_1.png

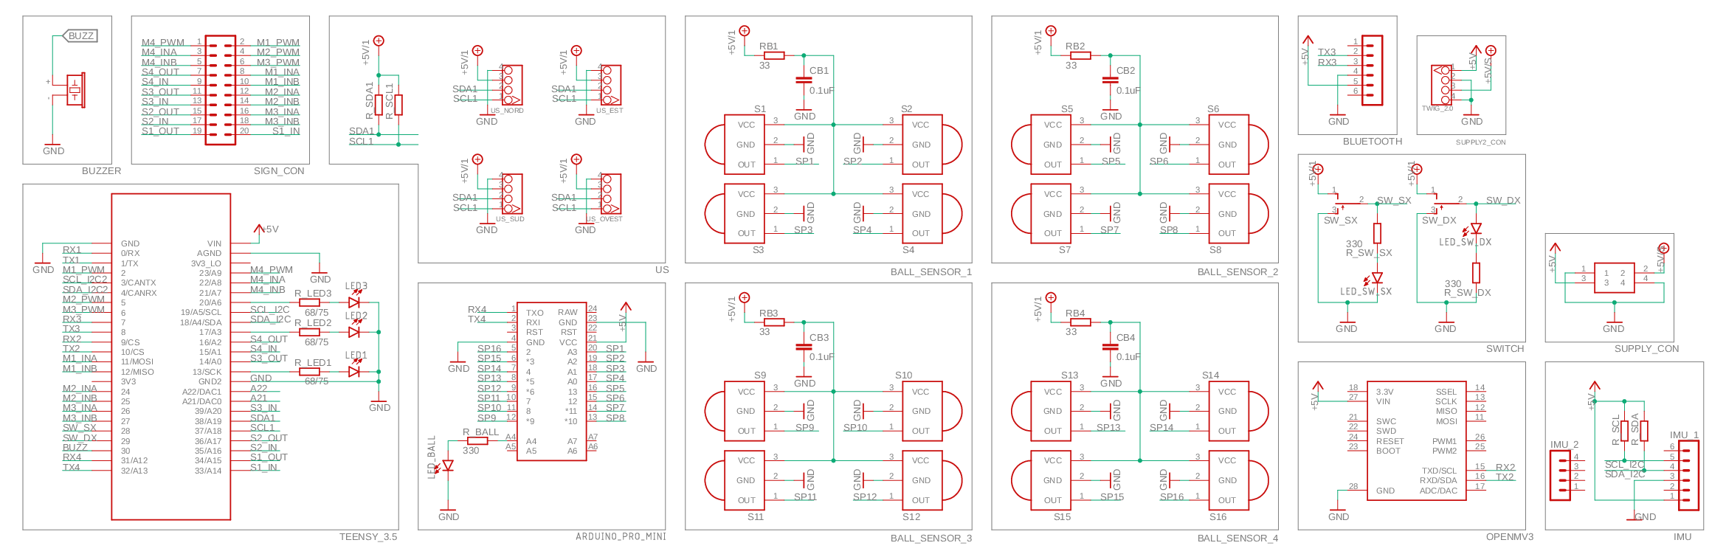
bible/hardware/uc board/uC-boardsch_1.png
