latino-deluxe/SPQR-Team-2019/bible/hardware/uc board/us.png

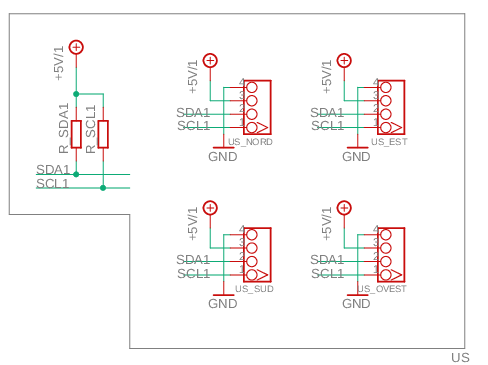
bible/hardware/uc board/us.png
