latino-deluxe/SPQR-Team-2019/bible/pics/arduino_1.jpg

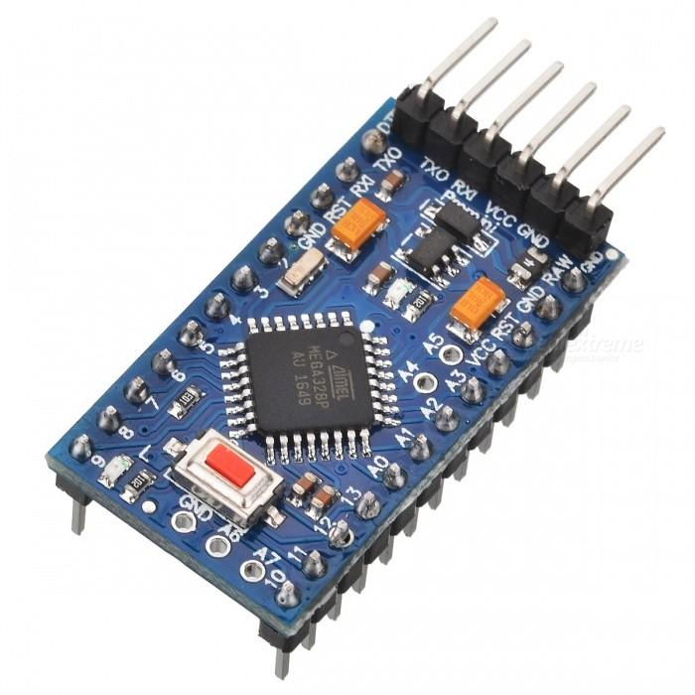
bible/pics/arduino_1.jpg
