latino-deluxe/SPQR-Team-2019/bible/pics/ball_1.PNG

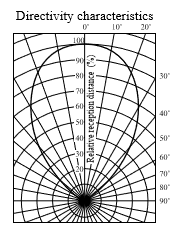
bible/pics/ball_1.PNG
