latino-deluxe/SPQR-Team-2019/bible/pics/ball_sens.jpg

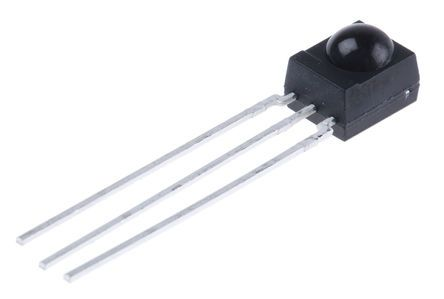
bible/pics/ball_sens.jpg
