latino-deluxe/SPQR-Team-2019/bible/pics/bno055_1.jpg

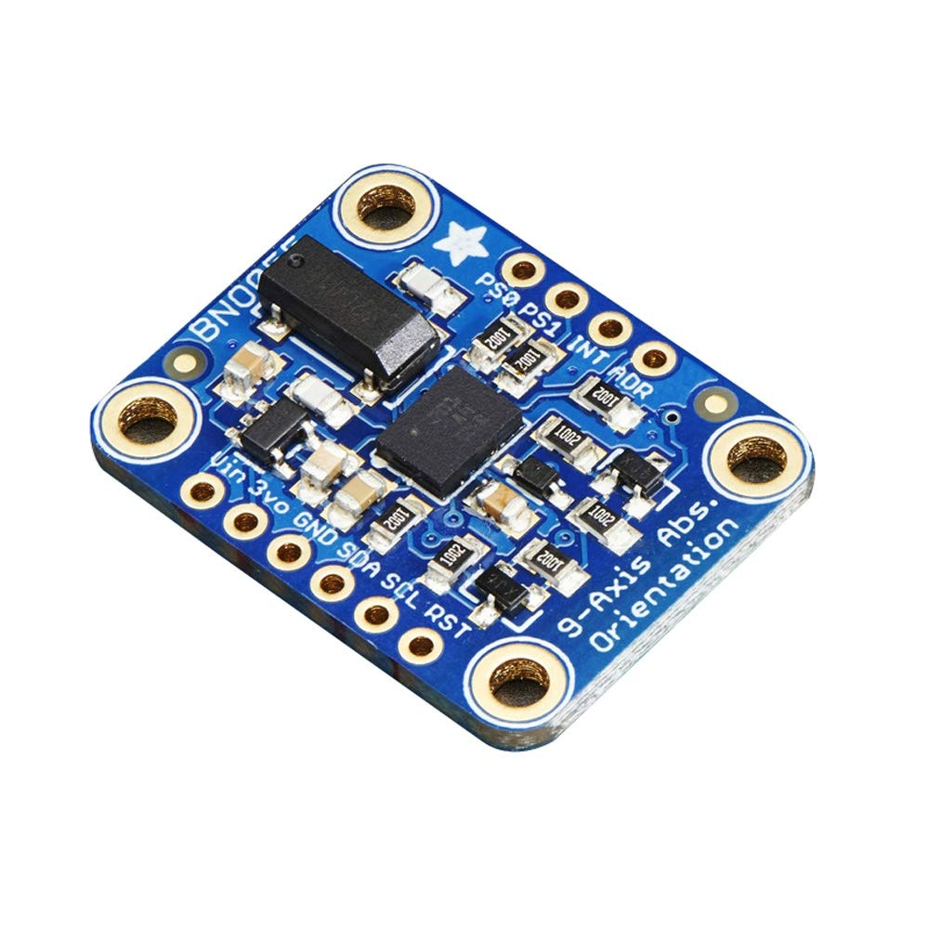
bible/pics/bno055_1.jpg
