latino-deluxe/SPQR-Team-2019/bible/pics/bt_1.jpg

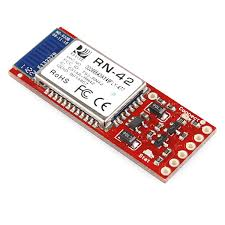
bible/pics/bt_1.jpg
