latino-deluxe/SPQR-Team-2019/bible/pics/cornelia2.JPG

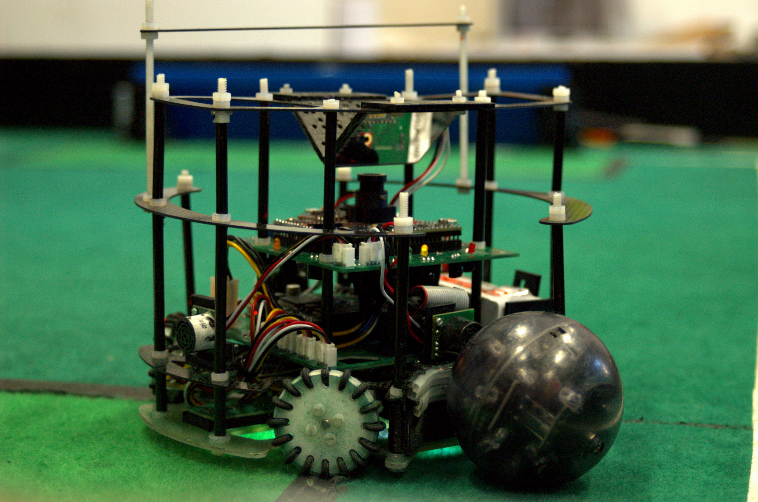
bible/pics/cornelia2.JPG
