latino-deluxe/SPQR-Team-2019/bible/pics/cornelia.jpg

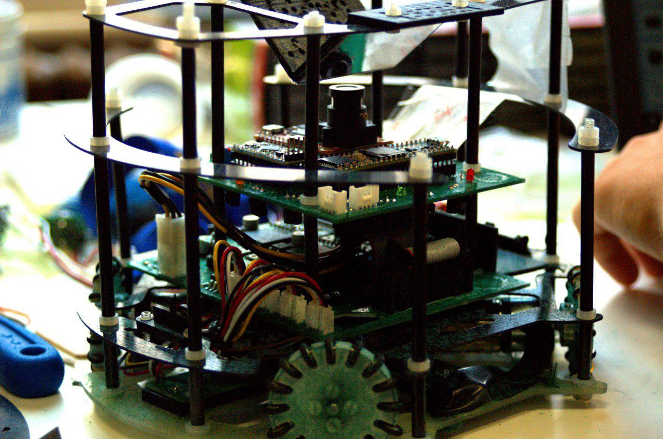
bible/pics/cornelia.jpg
