latino-deluxe/SPQR-Team-2019/bible/pics/DSC_0561_v1.JPG

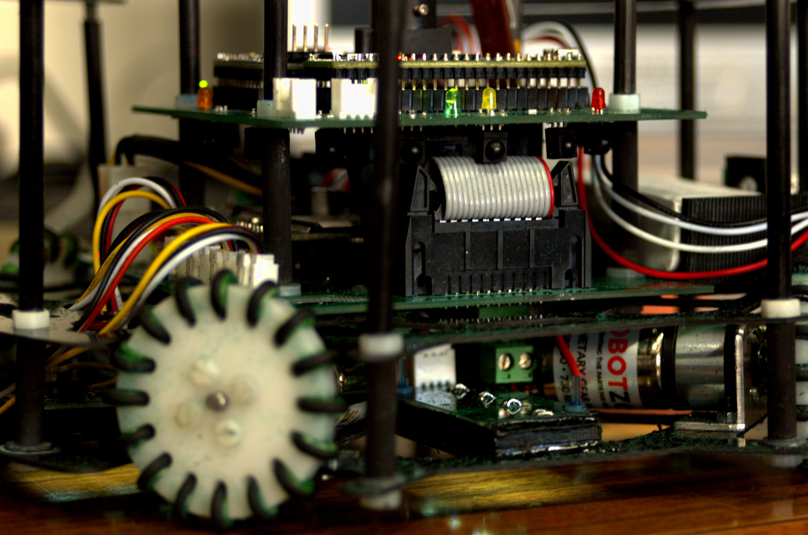
bible/pics/DSC_0561_v1.JPG
