latino-deluxe/SPQR-Team-2019/bible/pics/holonomic.jpg

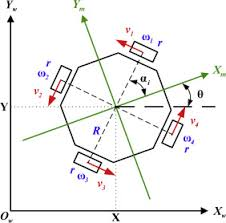
bible/pics/holonomic.jpg
