latino-deluxe/SPQR-Team-2019/bible/pics/md_3.PNG

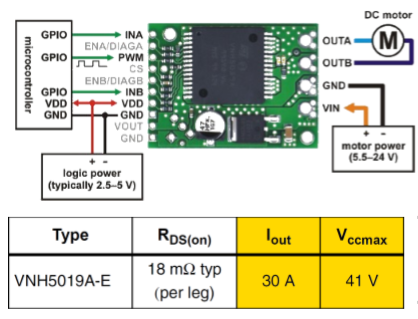
bible/pics/md_3.PNG
