latino-deluxe/SPQR-Team-2019/bible/pics/motor_table.PNG

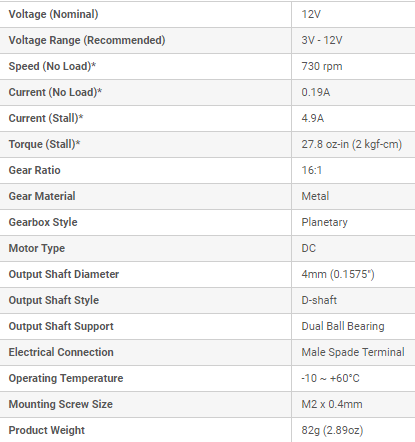
bible/pics/motor_table.PNG
