latino-deluxe/SPQR-Team-2019/bible/pics/motordrivers_1.jpg

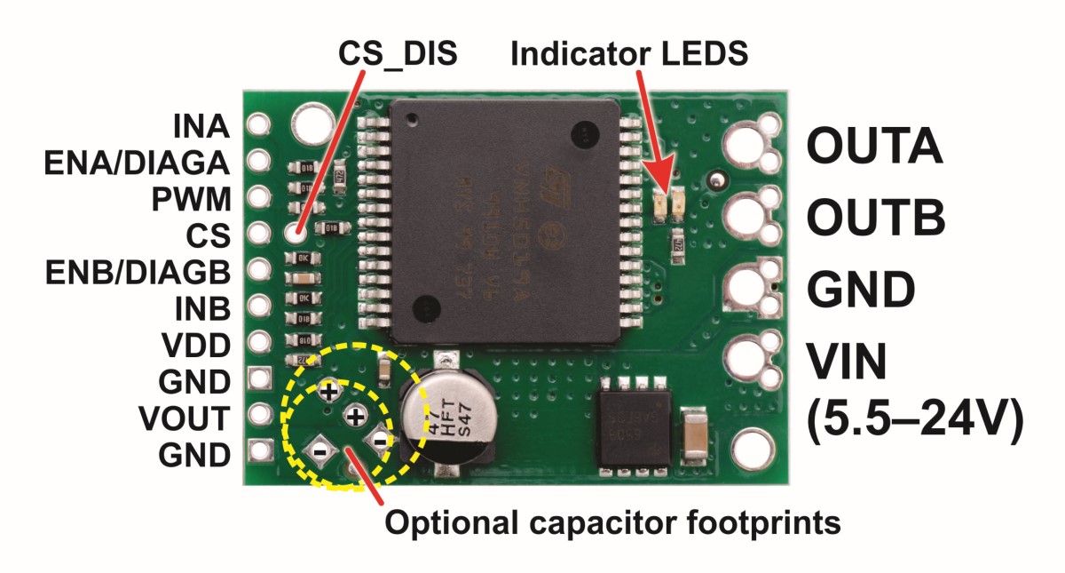
bible/pics/motordrivers_1.jpg
