latino-deluxe/SPQR-Team-2019/bible/pics/motordrivers_2.jpg

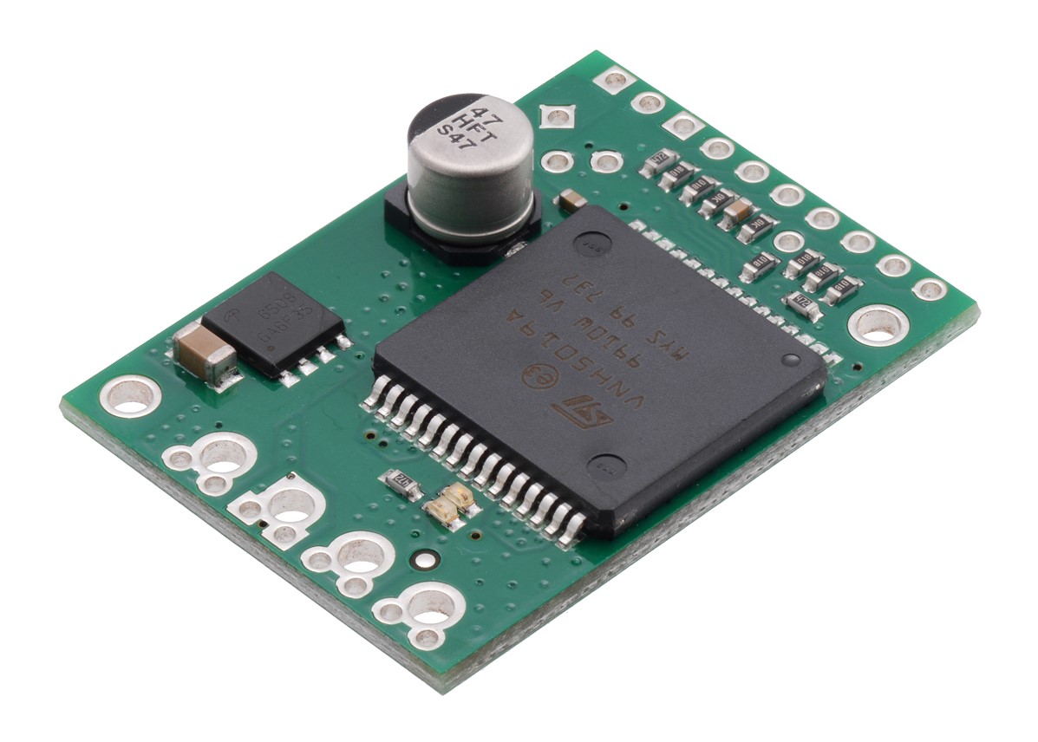
bible/pics/motordrivers_2.jpg
