latino-deluxe/SPQR-Team-2019/bible/pics/motordrivers_diagram.PNG

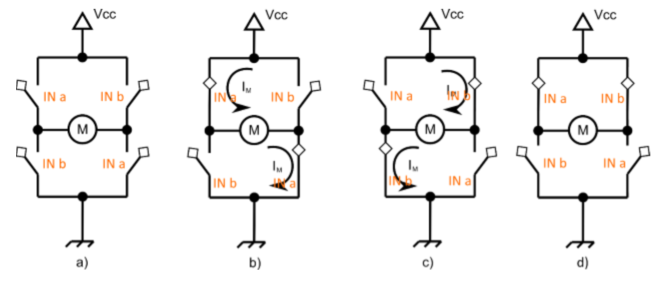
bible/pics/motordrivers_diagram.PNG
