latino-deluxe/SPQR-Team-2019/bible/pics/motordrivers_table.PNG

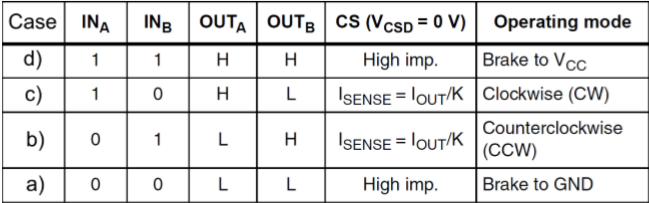
bible/pics/motordrivers_table.PNG
