latino-deluxe/SPQR-Team-2019/bible/pics/omniwheels_1.jpg

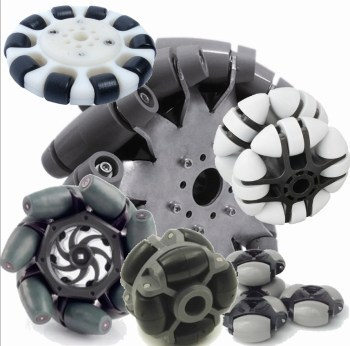
bible/pics/omniwheels_1.jpg
