latino-deluxe/SPQR-Team-2019/bible/pics/openmv_1.jpg

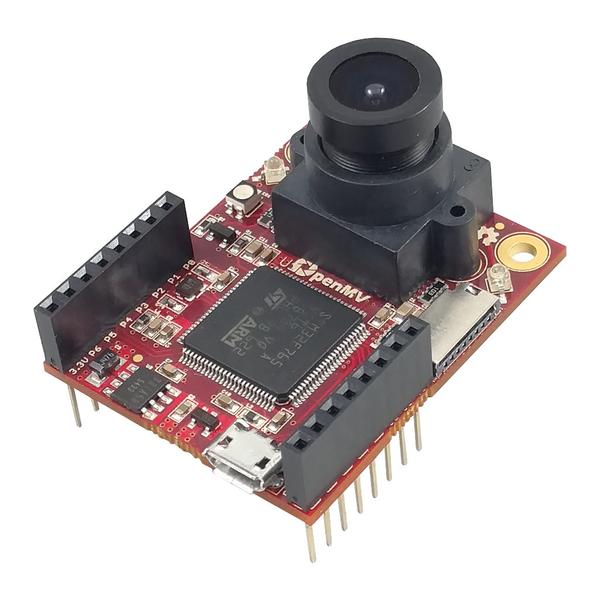
bible/pics/openmv_1.jpg
