latino-deluxe/SPQR-Team-2019/bible/pics/openmv_pinout.png

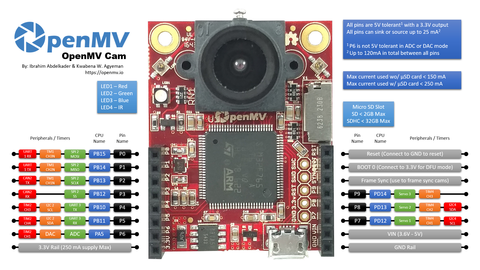
bible/pics/openmv_pinout.png
