latino-deluxe/SPQR-Team-2019/bible/pics/robot.JPG

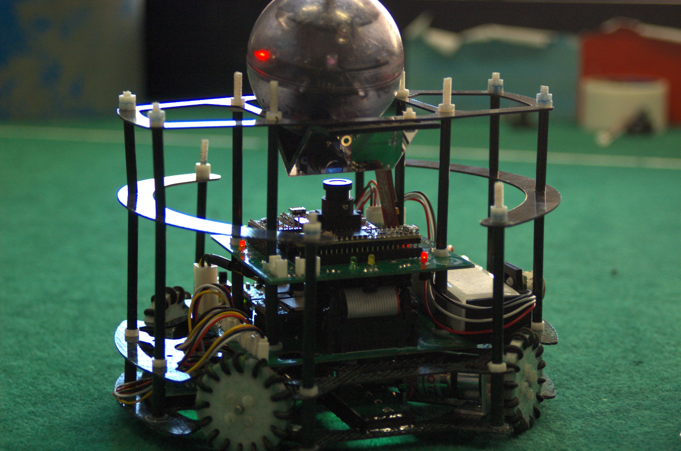
bible/pics/robot.JPG
