latino-deluxe/SPQR-Team-2019/bible/pics/robotica_galiel.JPG

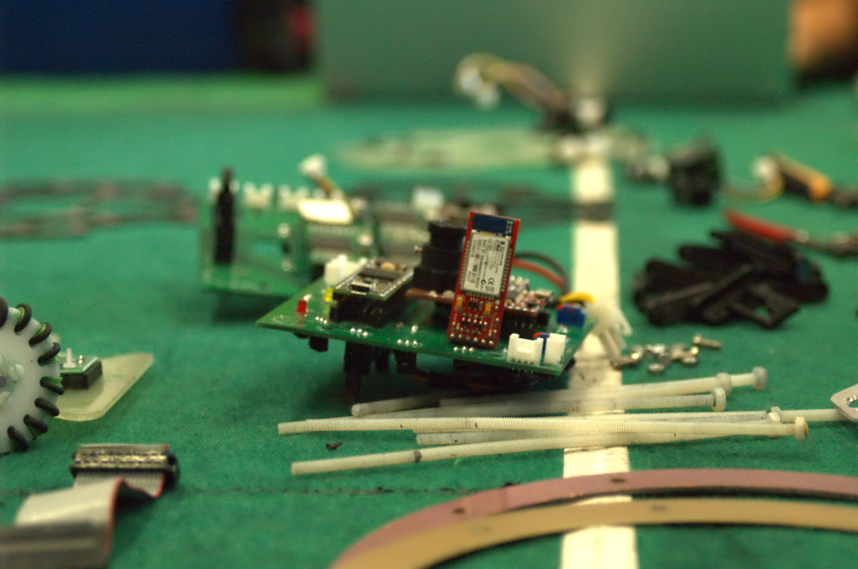
bible/pics/robotica_galiel.JPG
