latino-deluxe/SPQR-Team-2019/bible/pics/semimotors_1.jpg

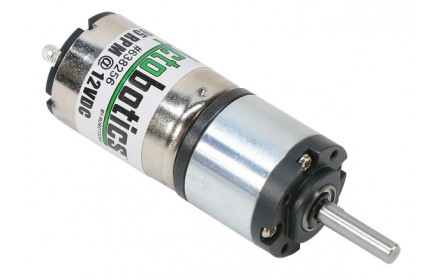
bible/pics/semimotors_1.jpg
