latino-deluxe/SPQR-Team-2019/bible/pics/srf02.jpg

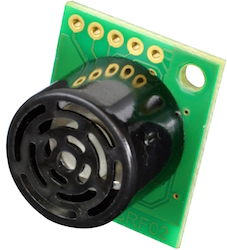
bible/pics/srf02.jpg
