latino-deluxe/SPQR-Team-2019/bible/pics/SRF02beam.jpg

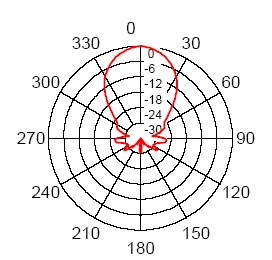
bible/pics/SRF02beam.jpg
