latino-deluxe/SPQR-Team-2019/bible/pics/sw.PNG

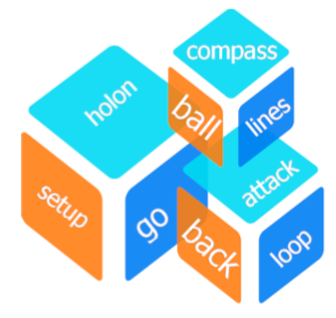
bible/pics/sw.PNG
