latino-deluxe/SPQR-Team-2019/bible/pics/teensy_1.jpg

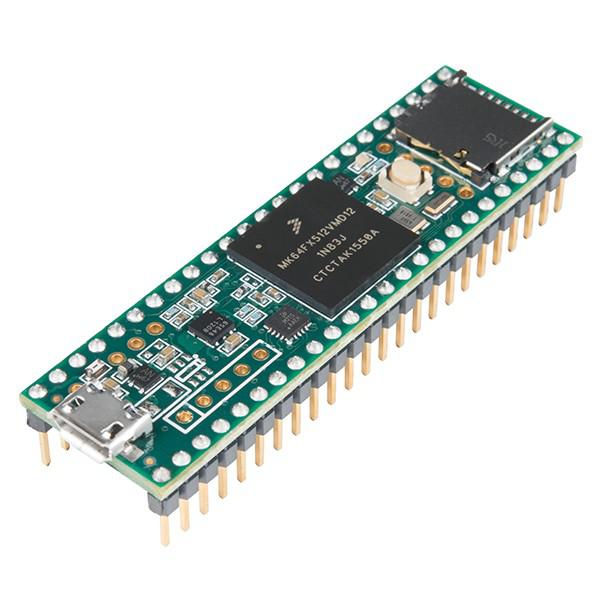
bible/pics/teensy_1.jpg
