latino-deluxe/SPQR-Team-2019/bible/pics/us_pinout.PNG

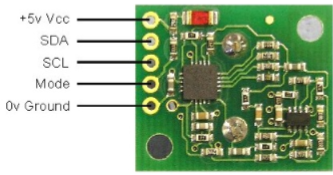
bible/pics/us_pinout.PNG
