latino-deluxe/SPQR-Team-2019/bible/software/ball-_1_.png

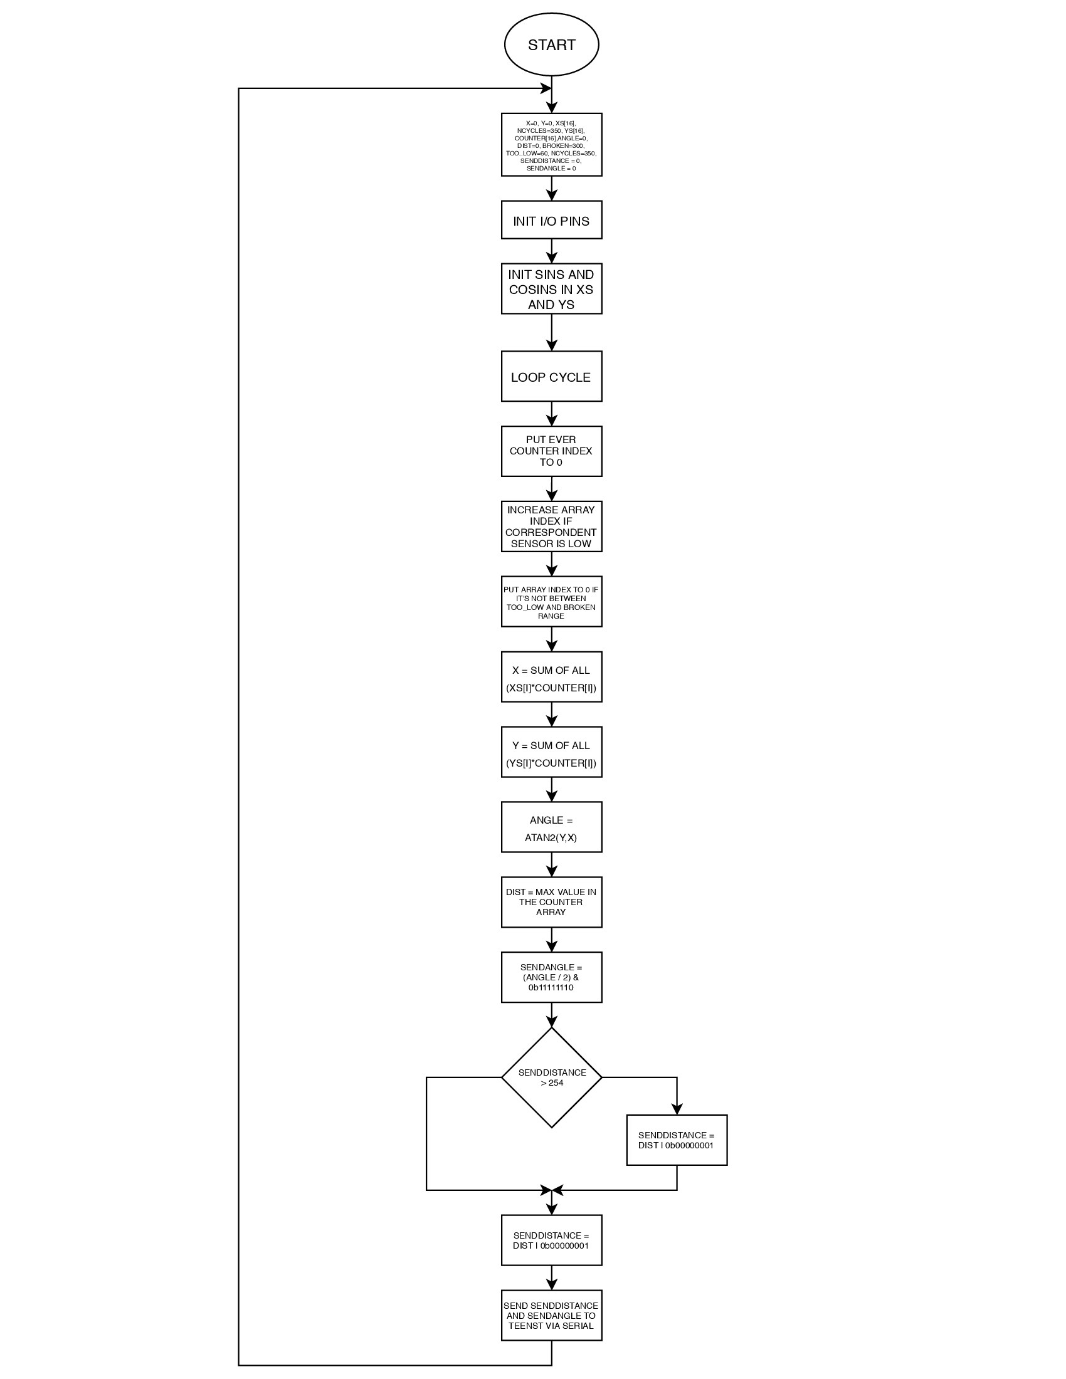
bible/software/ball-_1_.png
