latino-deluxe/SPQR-Team-2019/bible/software/flowchart_main.jpg

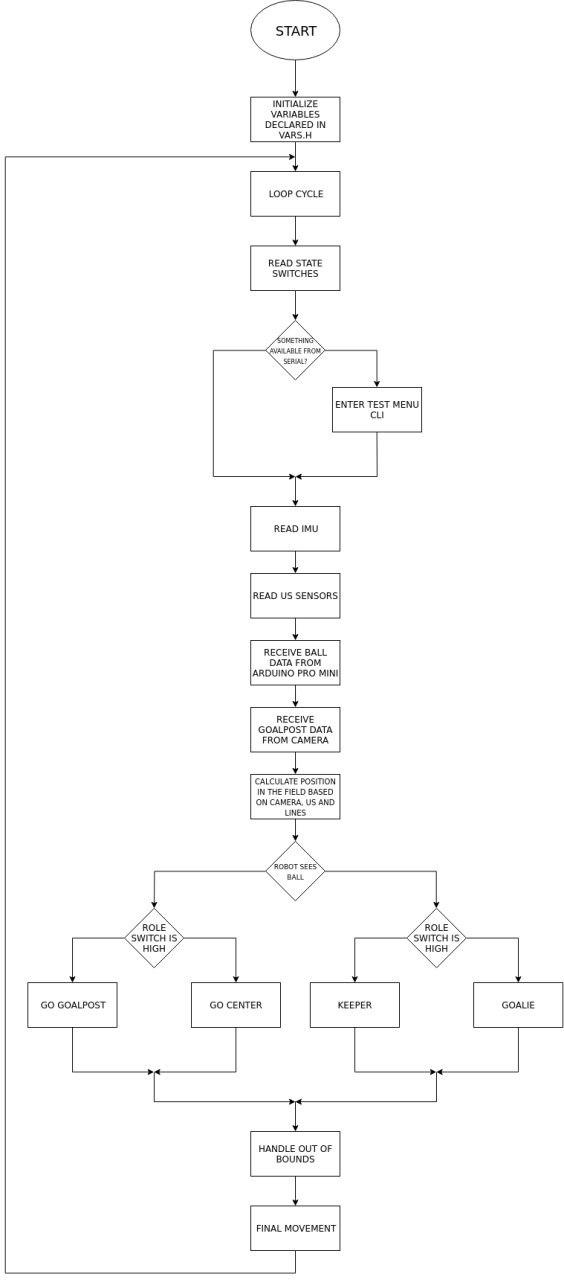
bible/software/flowchart_main.jpg
