latino-deluxe/SPQR-Team-2019/bible/software/linesensor.png

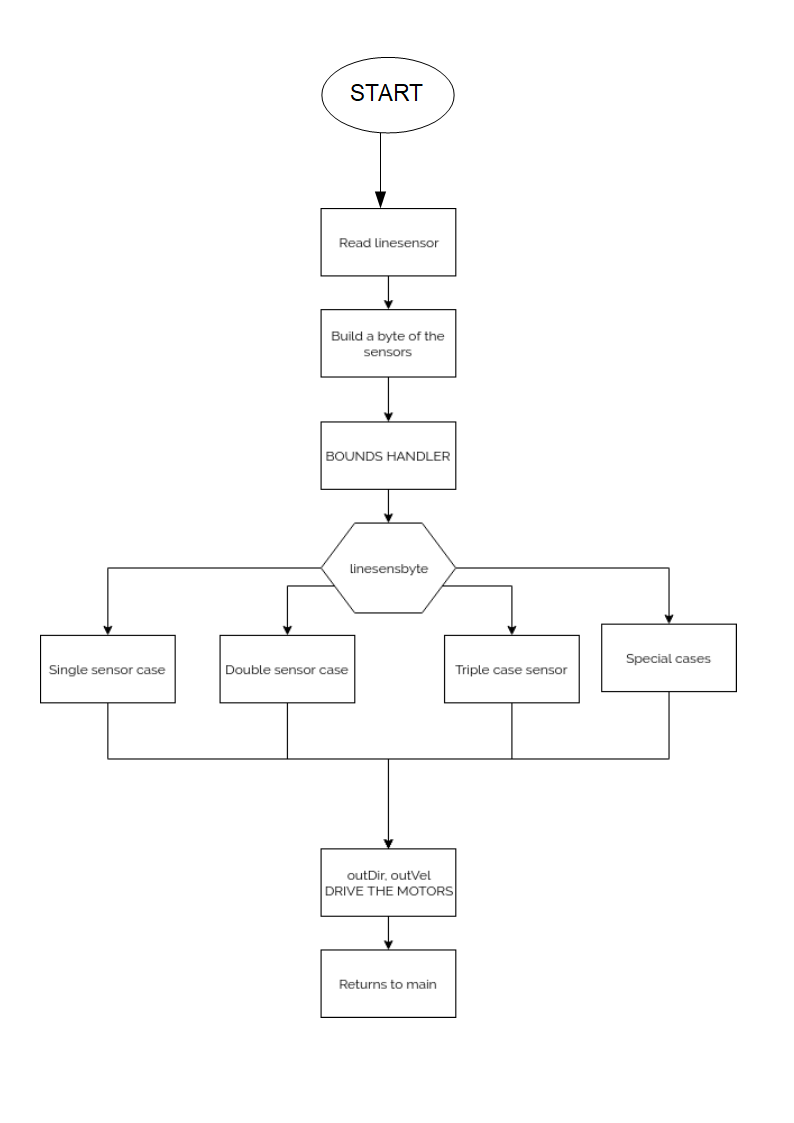
bible/software/linesensor.png
