latino-deluxe/SPQR-Team-2019/bible/software/robot_vision.jpg

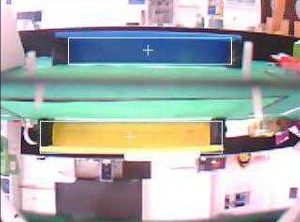
bible/software/robot_vision.jpg
