latino-deluxe/SPQR-Team-2019/bible/software/Untitled-Diagram.png/19e1bb3a53d4468afb33c84774b903d3-1.png

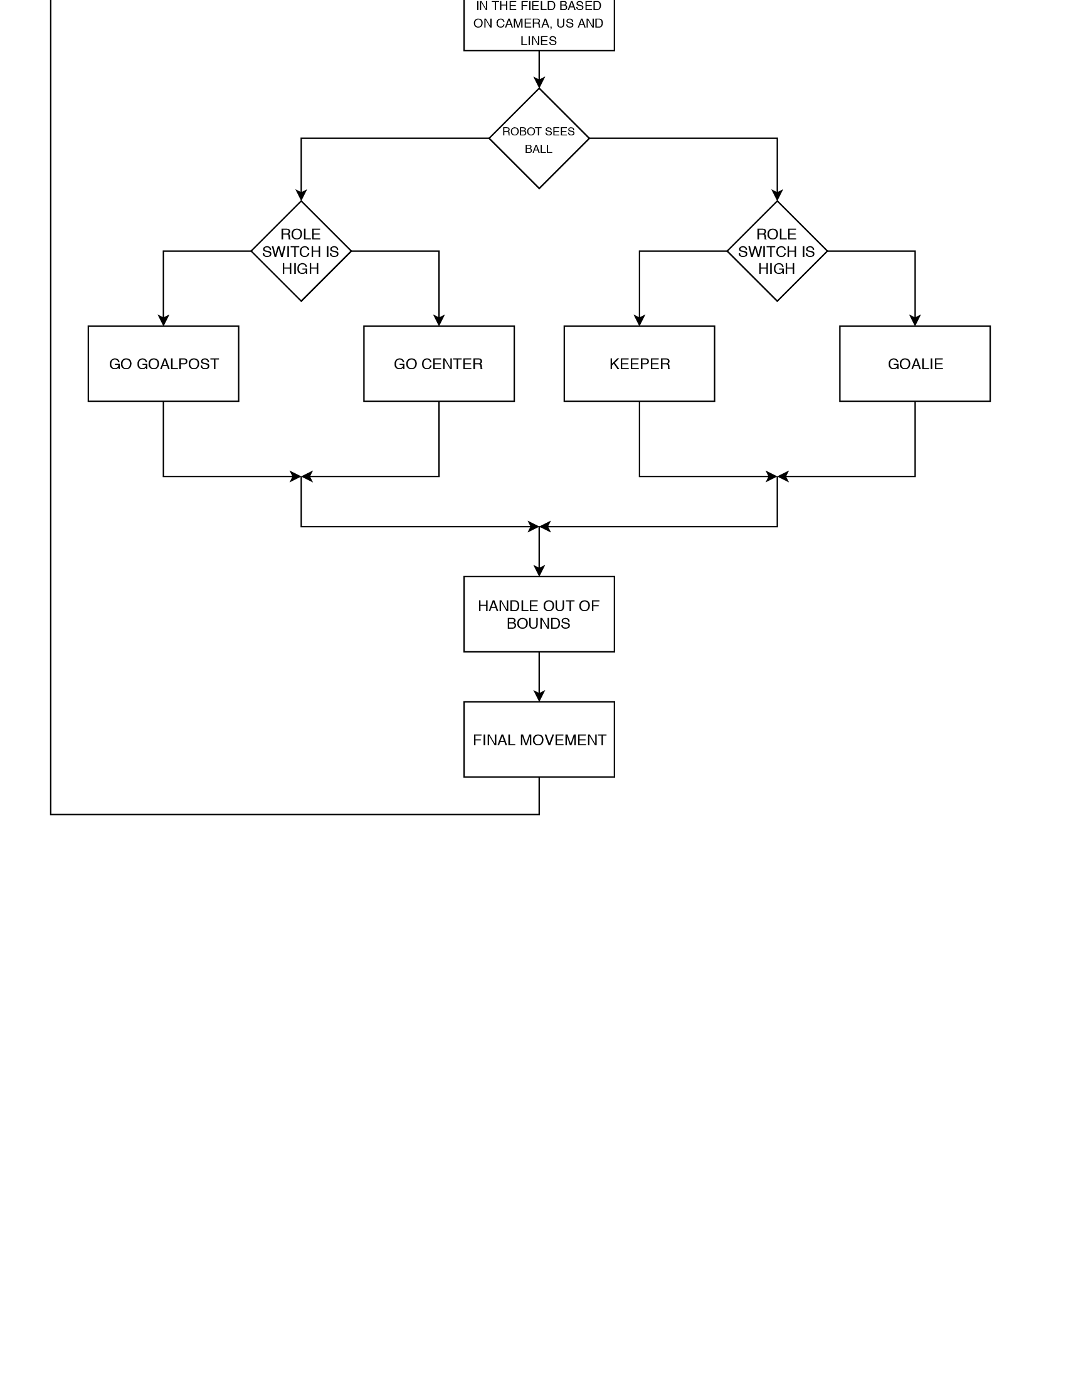
bible/software/Untitled-Diagram.png/19e1bb3a53d4468afb33c84774b903d3-1.png
