latino-deluxe/SPQR-Team-2019/damnpecette/images.png

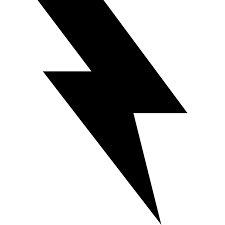
damnpecette/images.png
