latino-deluxe/SPQR-Team-2019/damnpecette/imgbin-lightning-drawing-lightning-QdSnjKarUyuvpJ7EA0te3TSAd.jpg

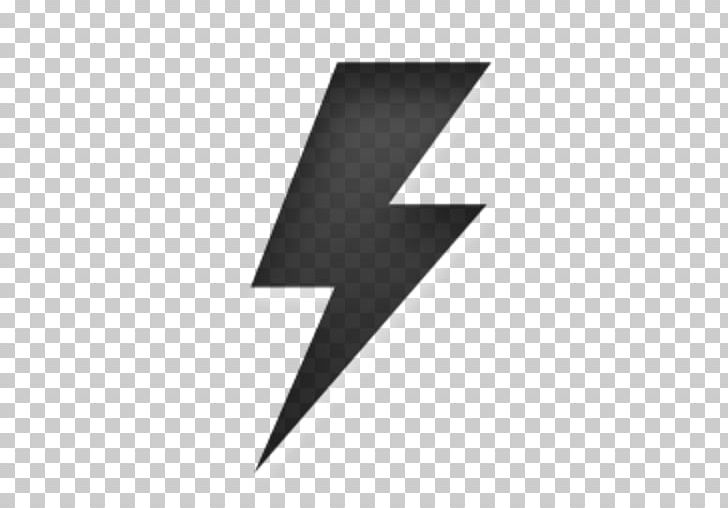
damnpecette/imgbin-lightning-drawing-lightning-QdSnjKarUyuvpJ7EA0te3TSAd.jpg
