latino-deluxe/SPQR-Team-2019/damnpecette/lightning-bolt-drawing-14.png

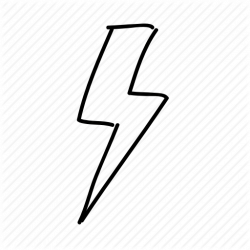
damnpecette/lightning-bolt-drawing-14.png
