latino-deluxe/SPQR-Team-2019/Eagle/Sidney 2019 boards/PNGs/Line sensors drills.png

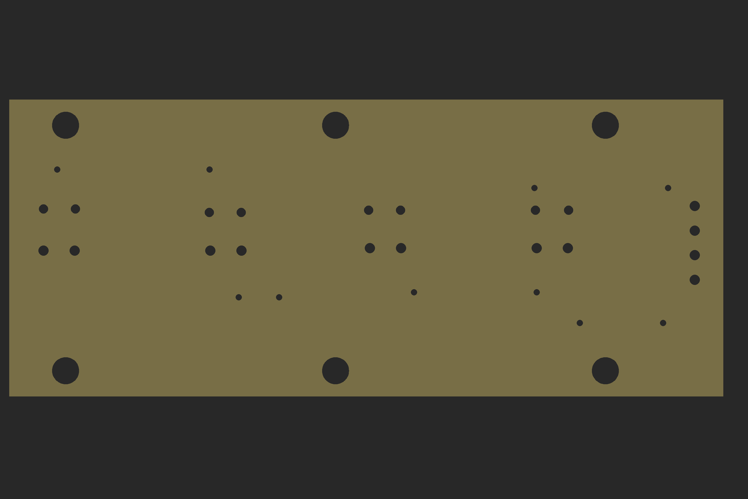
Eagle/Sidney 2019 boards/PNGs/Line sensors drills.png
