latino-deluxe/SPQR-Team-2019/Eagle/Sidney 2019 boards/PNGs/Motor board drills.png

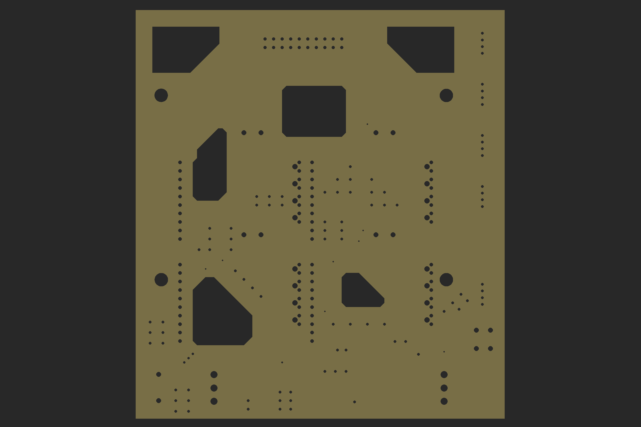
Eagle/Sidney 2019 boards/PNGs/Motor board drills.png
