latino-deluxe/SPQR-Team-2019/Eagle/Sidney 2019 boards/PNGs/uC board drills.png

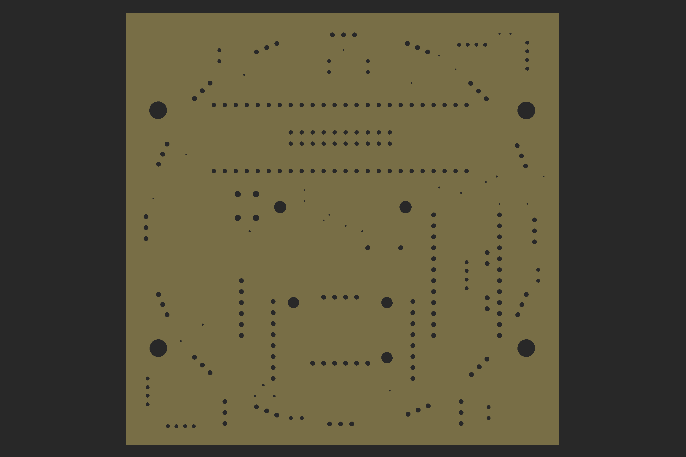
Eagle/Sidney 2019 boards/PNGs/uC board drills.png
