latino-deluxe/SPQR-Team-2019/Poster/Images/Eagle.png

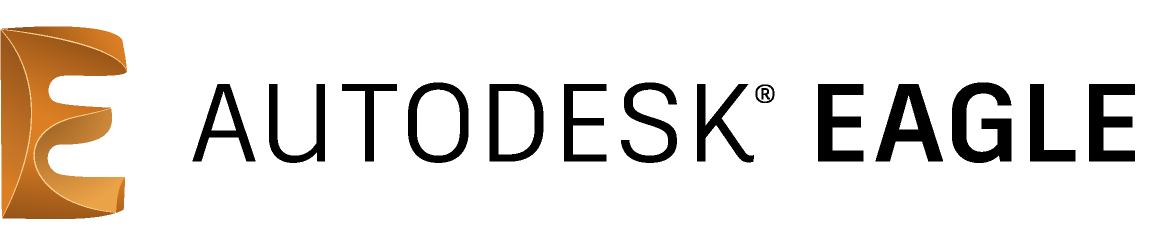
Poster/Images/Eagle.png
