latino-deluxe/SPQR-Team-2019/Poster/Images/Eagle.webp

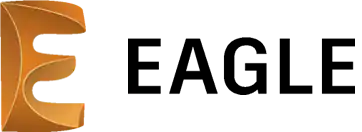
Poster/Images/Eagle.webp
