latino-deluxe/SPQR-Team-2019/Poster/Images/Esploso robot 2.PNG

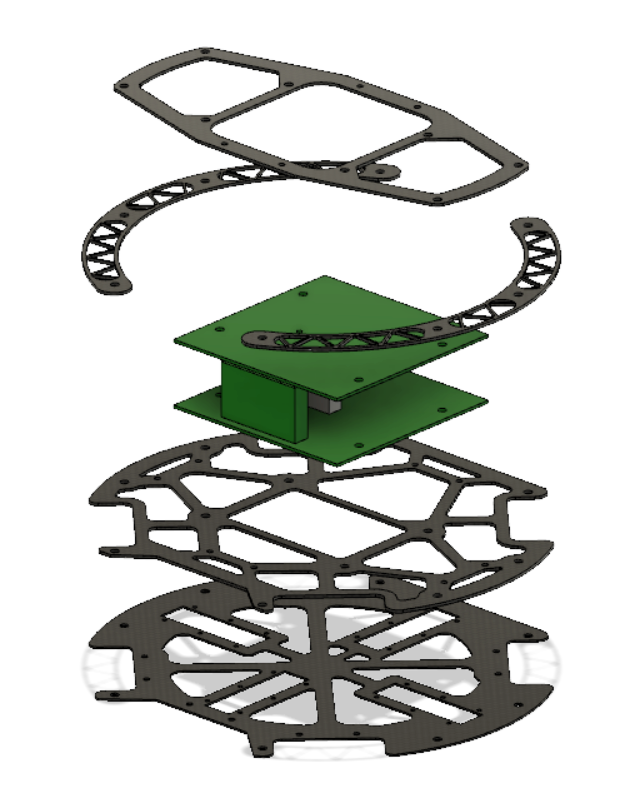
Poster/Images/Esploso robot 2.PNG
