latino-deluxe/SPQR-Team-2019/Poster/Images/Foto Achille.jpg

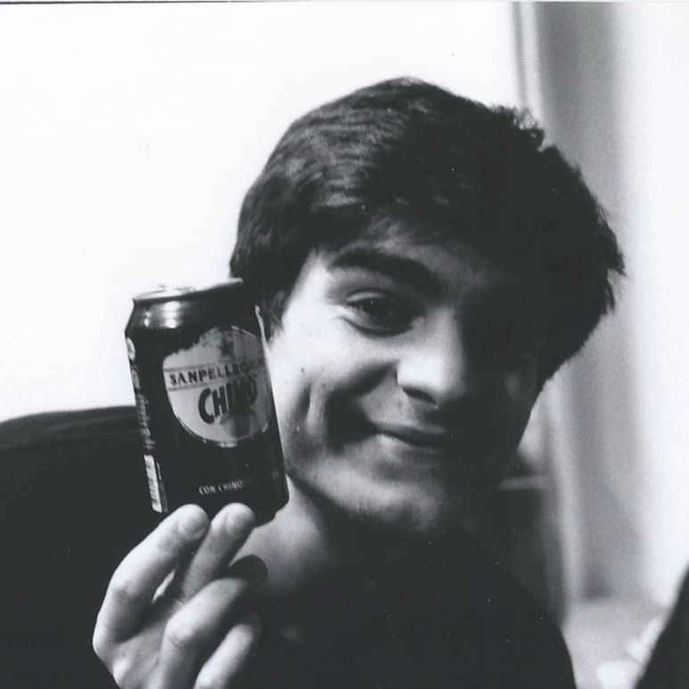
Poster/Images/Foto Achille.jpg
