latino-deluxe/SPQR-Team-2019/Poster/Images/Foto Dario.jpg

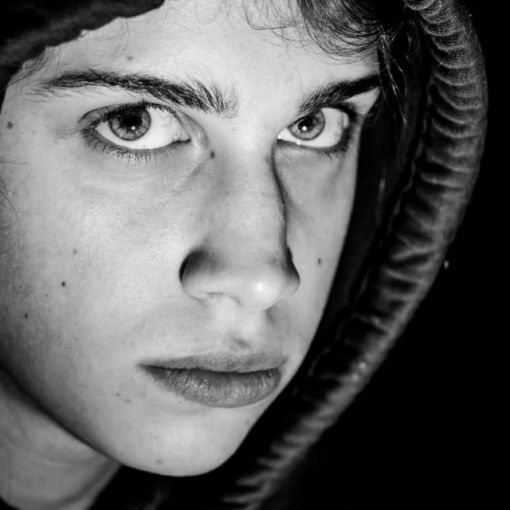
Poster/Images/Foto Dario.jpg
