latino-deluxe/SPQR-Team-2019/Poster/Images/Foto Emaletta.jpg

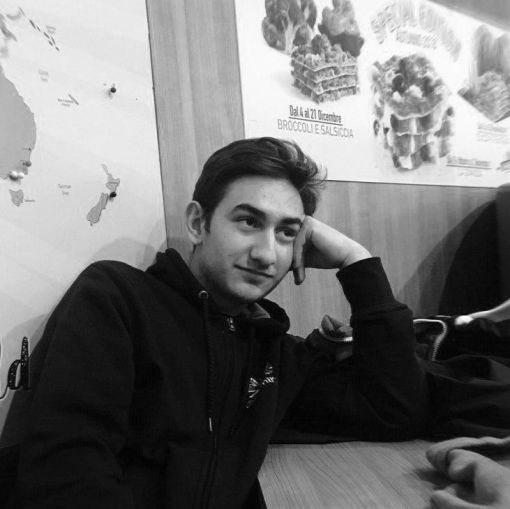
Poster/Images/Foto Emaletta.jpg
