latino-deluxe/SPQR-Team-2019/Poster/Images/Foto Ematino.jpg

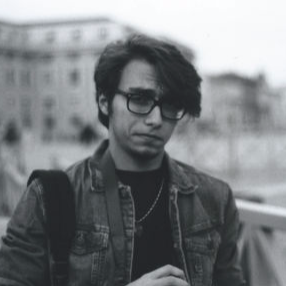
Poster/Images/Foto Ematino.jpg
