latino-deluxe/SPQR-Team-2019/Poster/Images/Foto robots.JPG

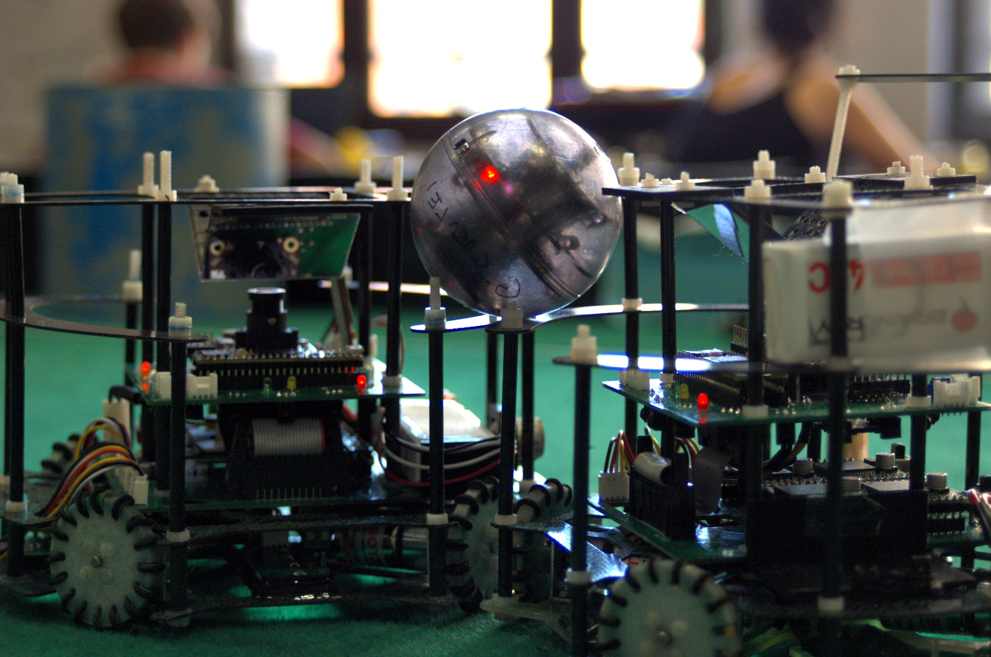
Poster/Images/Foto robots.JPG
