latino-deluxe/SPQR-Team-2019/Poster/Images/Line sensor.jpg

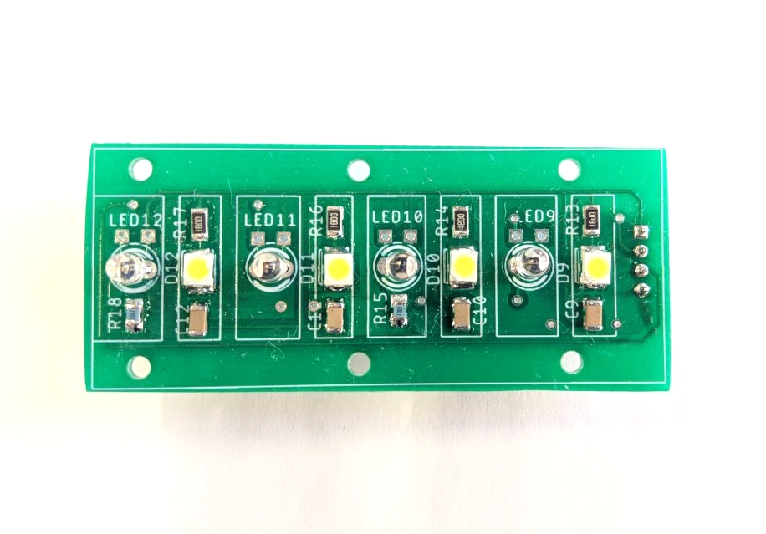
Poster/Images/Line sensor.jpg
