latino-deluxe/SPQR-Team-2019/Poster/Images/Specchio.jpg

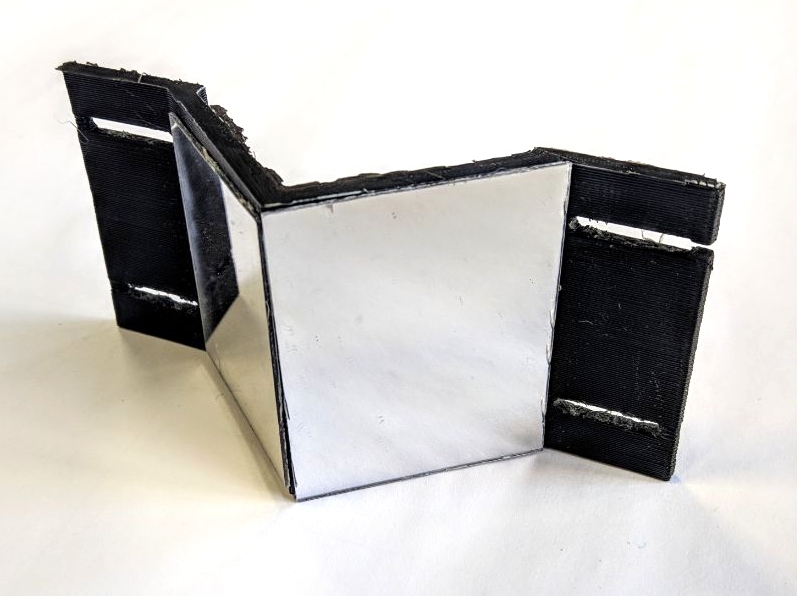
Poster/Images/Specchio.jpg
