latino-deluxe/SPQR-Team-2019/Poster/Images/Teensy.jpg

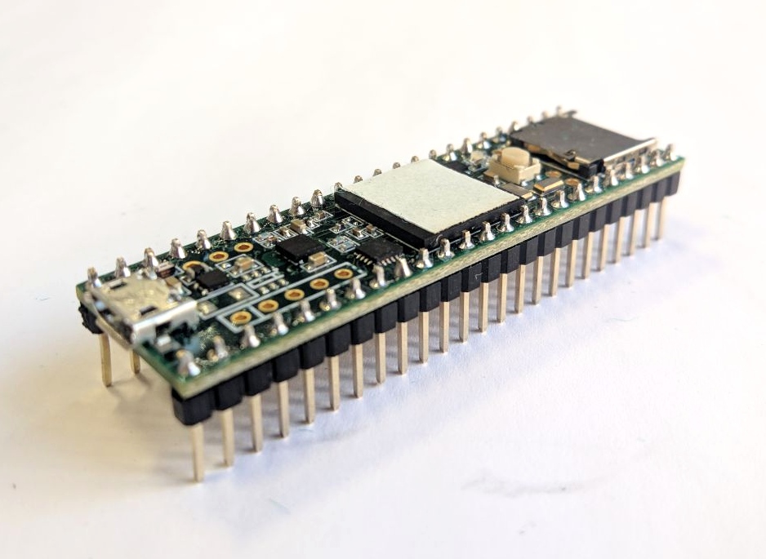
Poster/Images/Teensy.jpg
