latino-deluxe/SPQR-Team-2019/spqr_portfolio/pics/DSC_0689.JPG

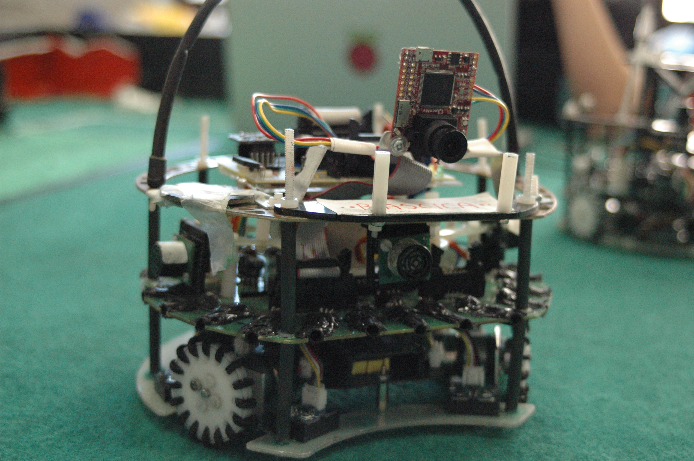
spqr_portfolio/pics/DSC_0689.JPG
