latino-deluxe/SPQR-Team-2019/Eagle/Sidney 2019 boards/DXFs/Motor board.dxf

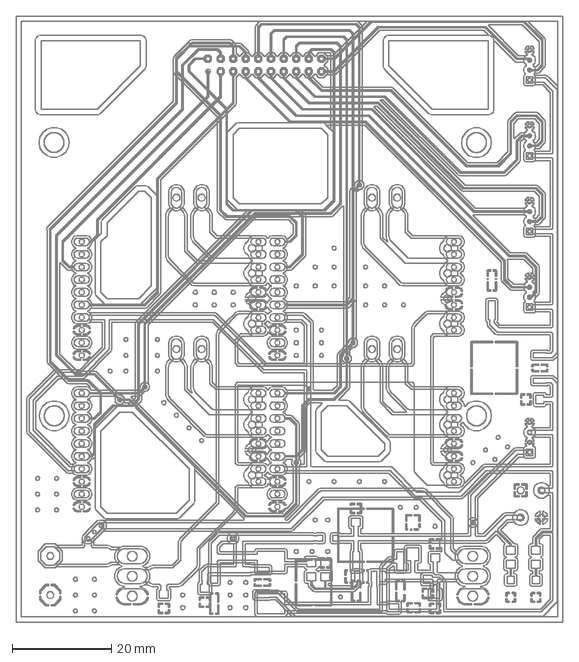
[picture p133: CAD file, 2019-05-24]
Eagle/Sidney 2019 boards/DXFs/Motor board.dxf
110.0 x 122.0 mm
