latino-deluxe/SPQR-Team-2019/Eagle/Sidney 2019 boards/DXFs/Line sensors.dxf

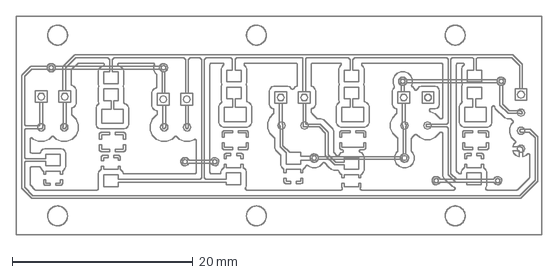
[picture p134: CAD file, 2019-05-23]
Eagle/Sidney 2019 boards/DXFs/Line sensors.dxf
58.2 x 24.2 mm
