latino-deluxe/SPQR-Team-2019/Eagle/Sidney 2019 boards/DXFs/uC board.dxf

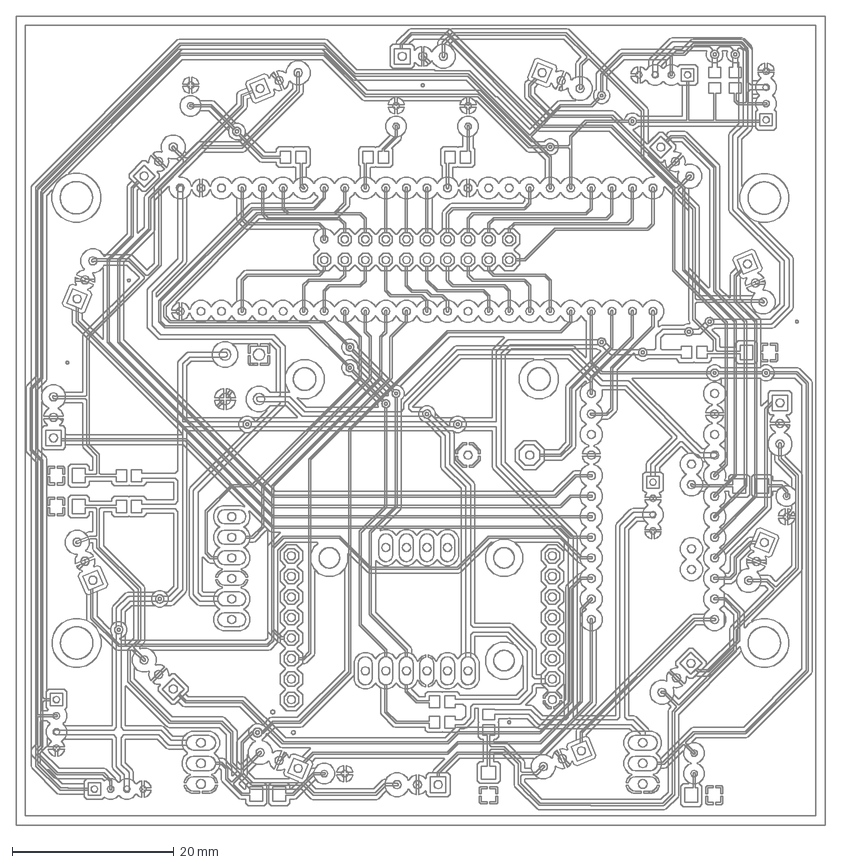
[picture p135: CAD file, 2019-05-23]
Eagle/Sidney 2019 boards/DXFs/uC board.dxf
100.0 x 100.0 mm
