latino-deluxe/SPQR-Team-2019/(list of files, cad)

Other CAD files:
Fusion/ROBOT 2019 finale.f3d
Fusion/ROBOT 2019 completo v1.f3d
