latino-deluxe/SPQR-Team-2019/bible/hardware/linesensors/Line sensorsbot.pdf

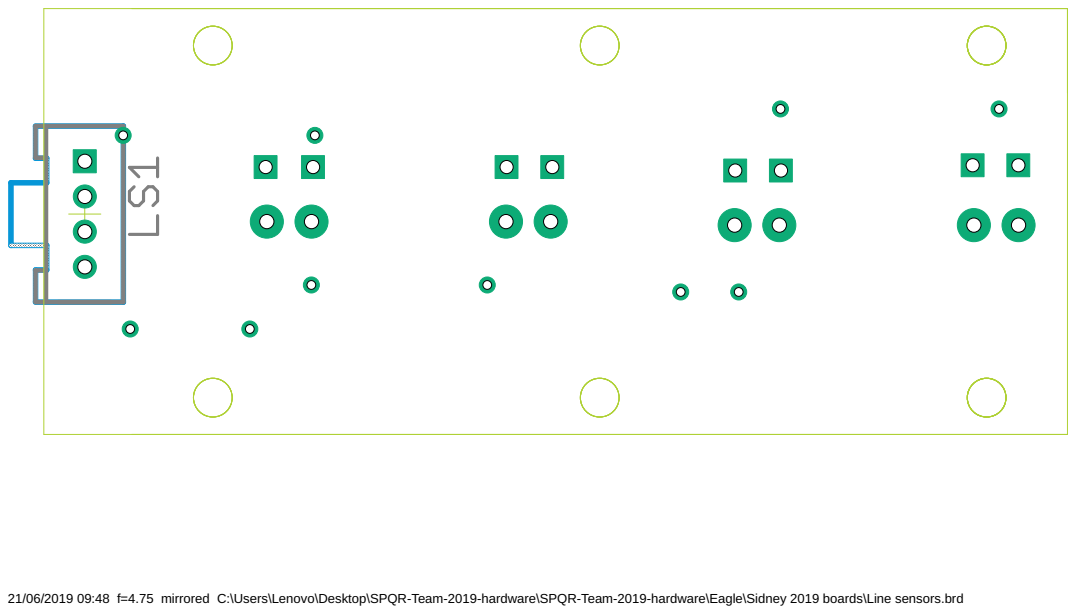
[picture p136: page 1]

21/06/2019 09:48 f=4.75 mirrored C:\Users\Lenovo\Desktop\SPQR-Team-2019-hardware\SPQR-Team-2019-hardware\Eagle\Sidney 2019 boards\Line sensors.brd
