latino-deluxe/SPQR-Team-2019/bible/hardware/linesensors/Line sensorstop.pdf

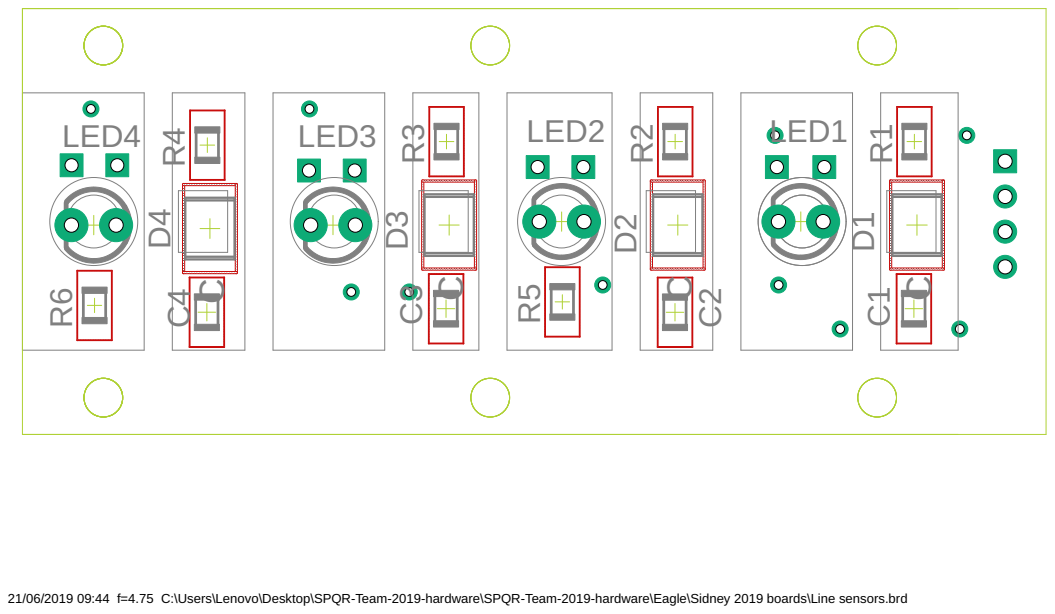
[picture p137: page 1]

21/06/2019 09:44 f=4.75 C:\Users\Lenovo\Desktop\SPQR-Team-2019-hardware\SPQR-Team-2019-hardware\Eagle\Sidney 2019 boards\Line sensors.brd
