latino-deluxe/SPQR-Team-2019/bible/hardware/motor board/Motor board.pdf

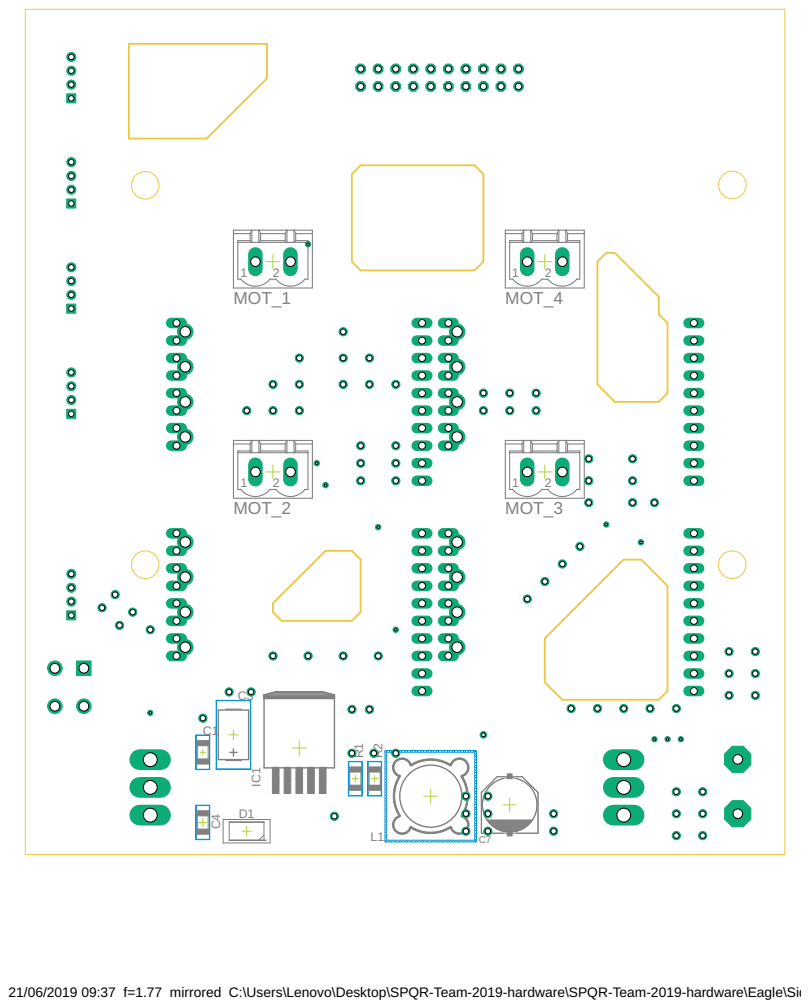
[picture p138: page 1]

21/06/2019 09:37 f=1.77 mirrored C:\Users\Lenovo\Desktop\SPQR-Team-2019-hardware\SPQR-Team-2019-hardware\Eagle\Sidney 2019 boards\Motor board.brd
