latino-deluxe/SPQR-Team-2019/bible/hardware/motor board/Motor boardlayouttop.pdf

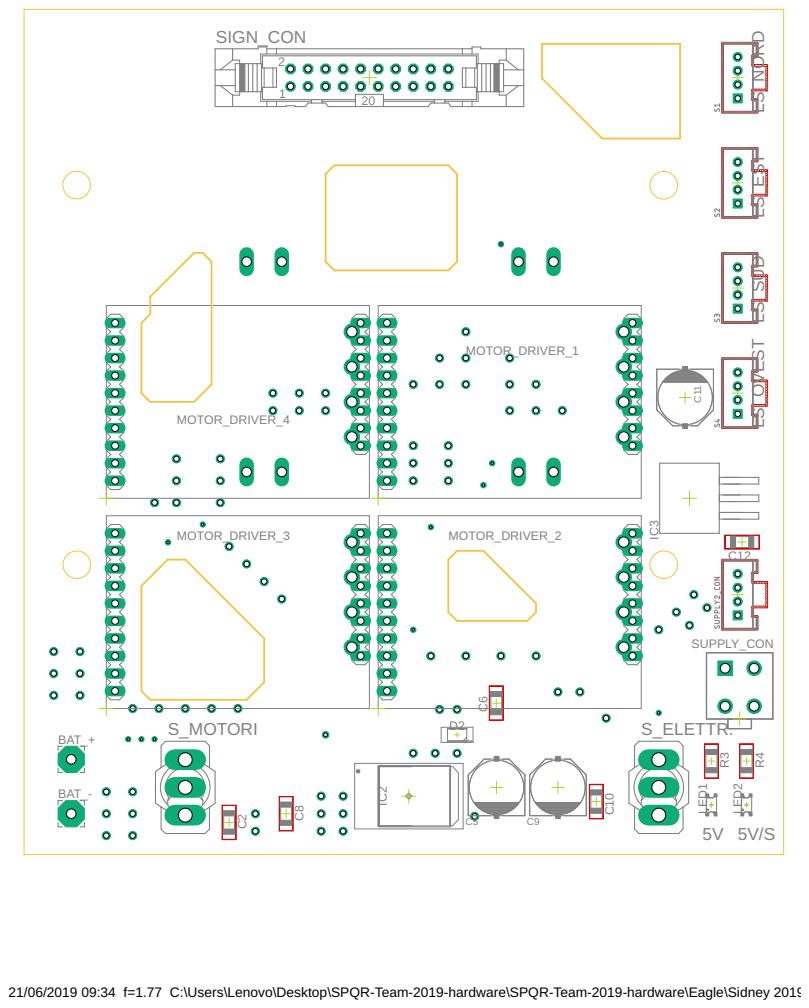
[picture p139: page 1]

21/06/2019 09:34 f=1.77 C:\Users\Lenovo\Desktop\SPQR-Team-2019-hardware\SPQR-Team-2019-hardware\Eagle\Sidney 2019 boards\Motor board.brd
