latino-deluxe/SPQR-Team-2019/Eagle/Sidney 2019 boards/PDFs/Line sensors bottom.pdf

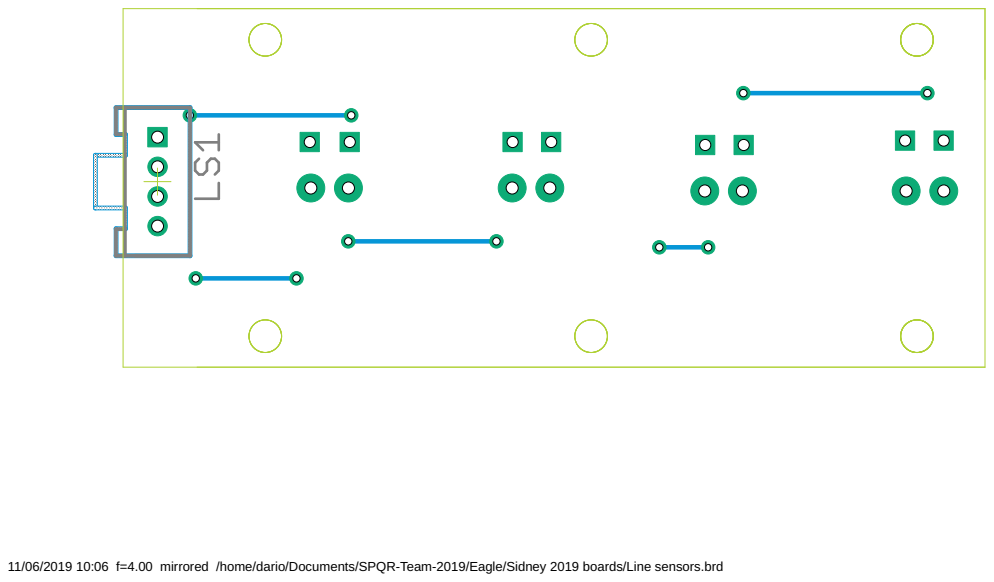
[picture p140: page 1]

11/06/2019 10:06 f=4.00 mirrored /home/dario/Documents/SPQR-Team-2019/Eagle/Sidney 2019 boards/Line sensors.brd
