latino-deluxe/SPQR-Team-2019/Eagle/Sidney 2019 boards/PDFs/Line sensors top.pdf

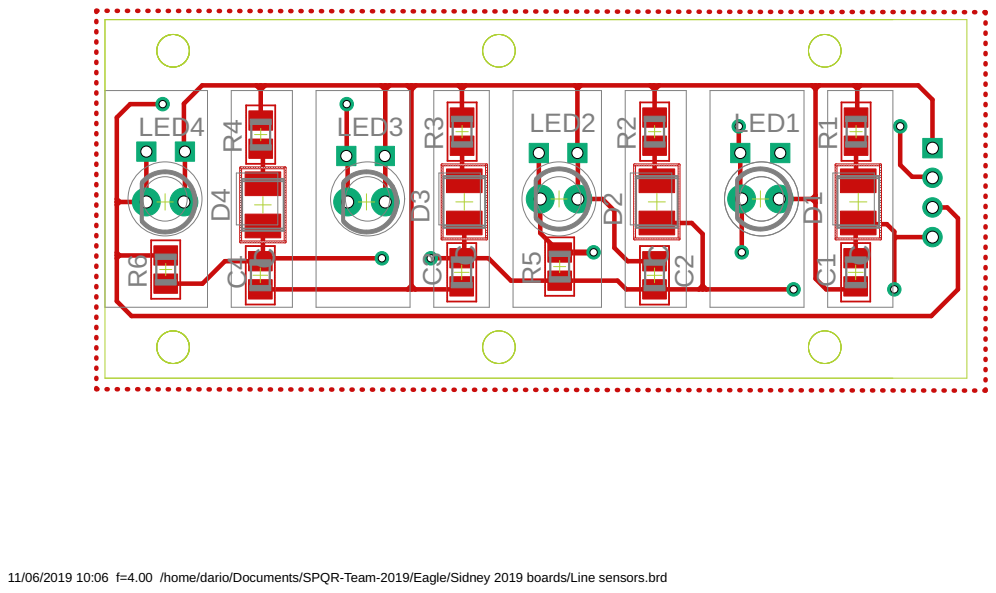
[picture p141: page 1]

11/06/2019 10:06 f=4.00 /home/dario/Documents/SPQR-Team-2019/Eagle/Sidney 2019 boards/Line sensors.brd
