latino-deluxe/SPQR-Team-2019/Eagle/Sidney 2019 boards/PDFs/Motor board top.pdf

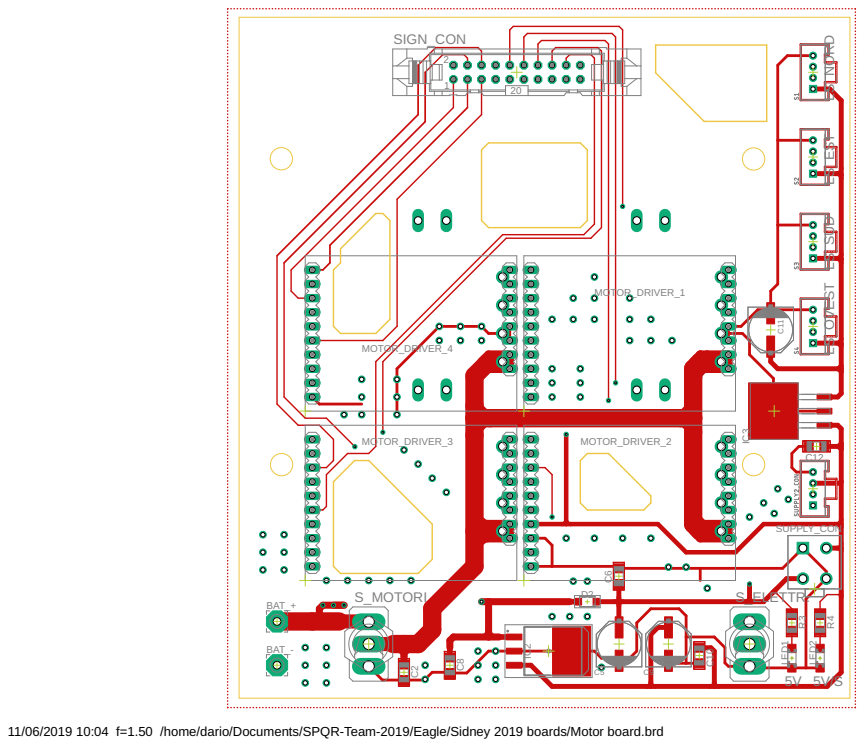
[picture p142: page 1]

11/06/2019 10:04 f=1.50 /home/dario/Documents/SPQR-Team-2019/Eagle/Sidney 2019 boards/Motor board.brd
