latino-deluxe/SPQR-Team-2019/Eagle/Sidney 2019 boards/PDFs/uC board top.pdf

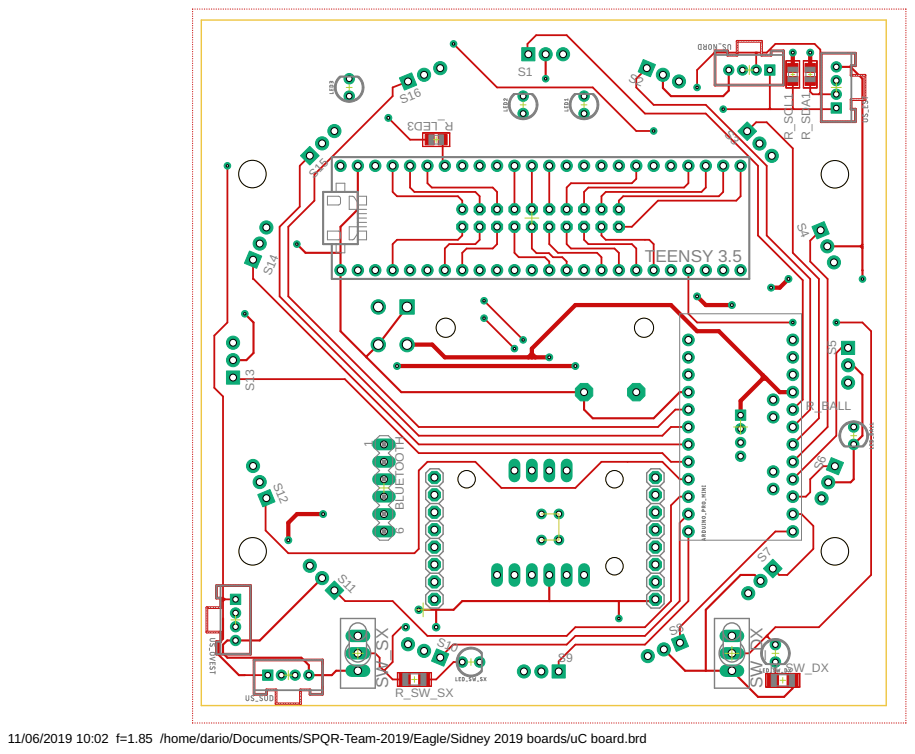
[picture p144: page 1]

11/06/2019 10:02 f=1.85 /home/dario/Documents/SPQR-Team-2019/Eagle/Sidney 2019 boards/uC board.brd
