latino-deluxe/SPQR-Team-2019/Eagle/Sidney 2019 boards/PDFs/Motor board bottom.pdf

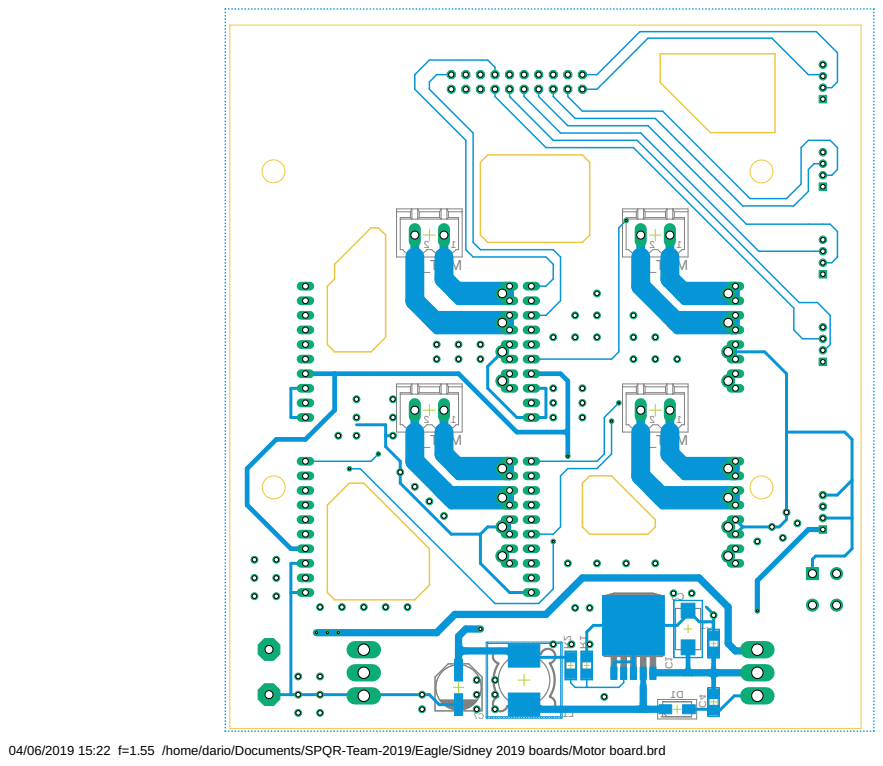
[picture p145: page 1]

04/06/2019 15:22 f=1.55 /home/dario/Documents/SPQR-Team-2019/Eagle/Sidney 2019 boards/Motor board.brd
