latino-deluxe/SPQR-Team-2019/Eagle/Sidney 2019 boards/PDFs/Motor board.pdf

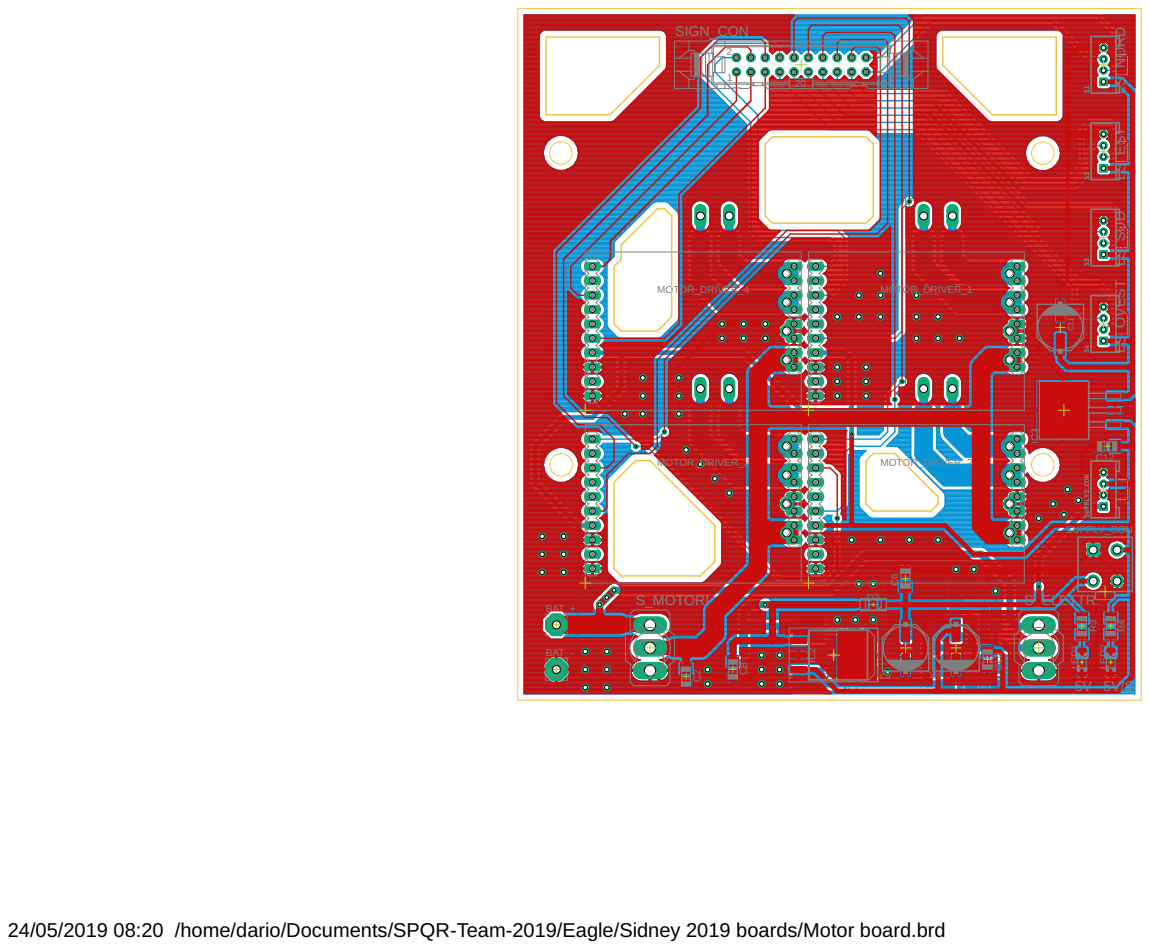
[picture p146: page 1]

24/05/2019 08:20 /home/dario/Documents/SPQR-Team-2019/Eagle/Sidney 2019 boards/Motor board.brd
