latino-deluxe/SPQR-Team-2019/Eagle/Sidney 2019 boards/PDFs/Line sensors.pdf

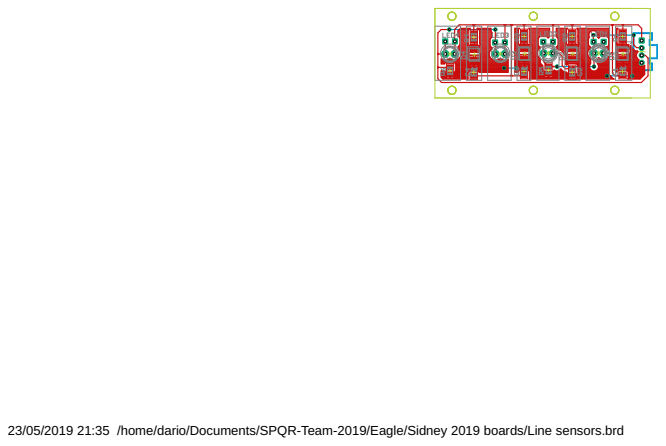
[picture p147: page 1]

23/05/2019 21:35 /home/dario/Documents/SPQR-Team-2019/Eagle/Sidney 2019 boards/Line sensors.brd
