latino-deluxe/SPQR-Team-2019/bible/hardware/uc board/uC board.pdf

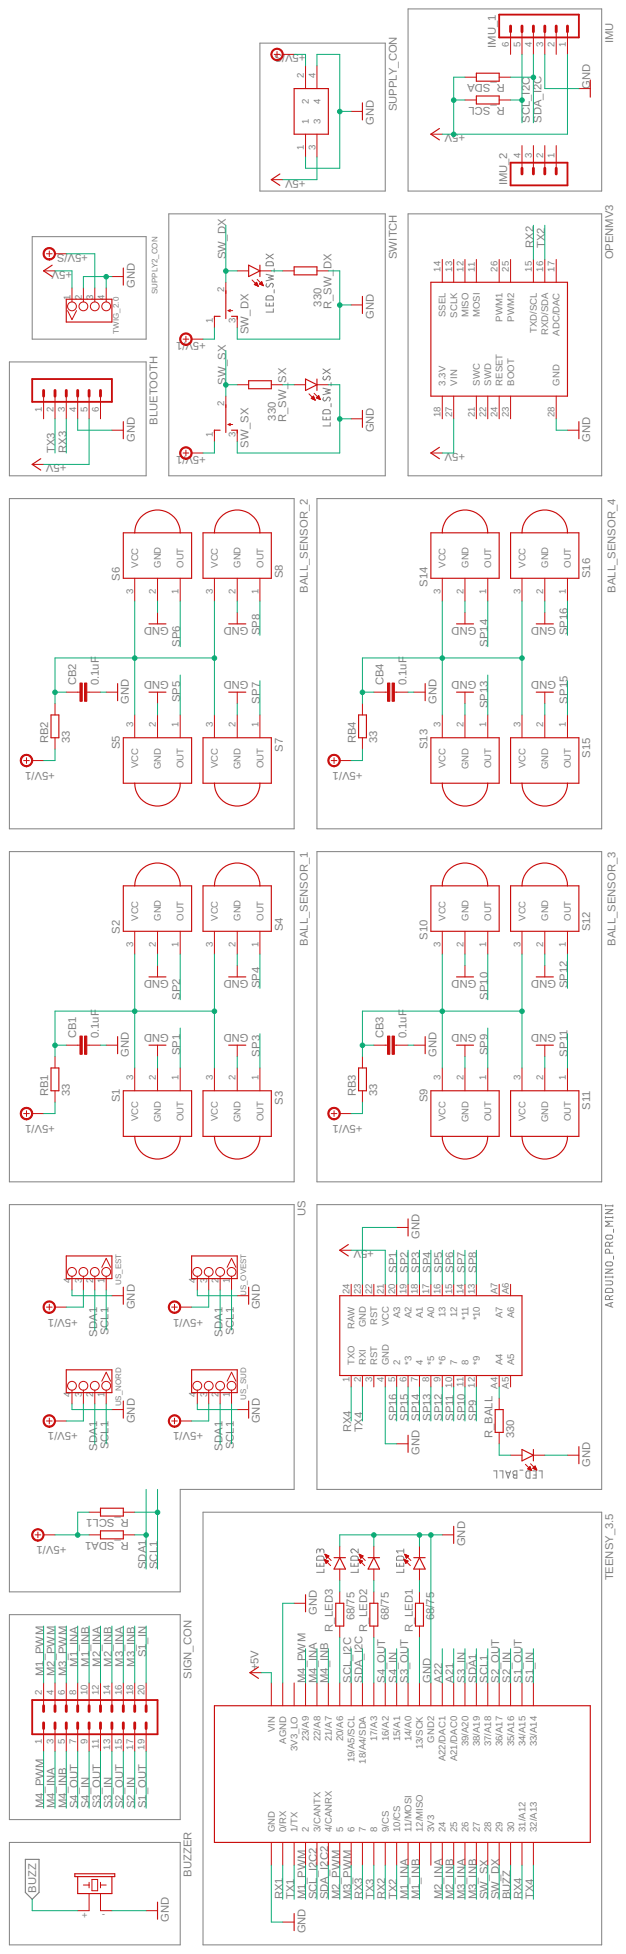
[picture p148: page 1]
