latino-deluxe/SPQR-Team-2019/bible/software/ball (1).pdf

# START

## INIT I/O PINS

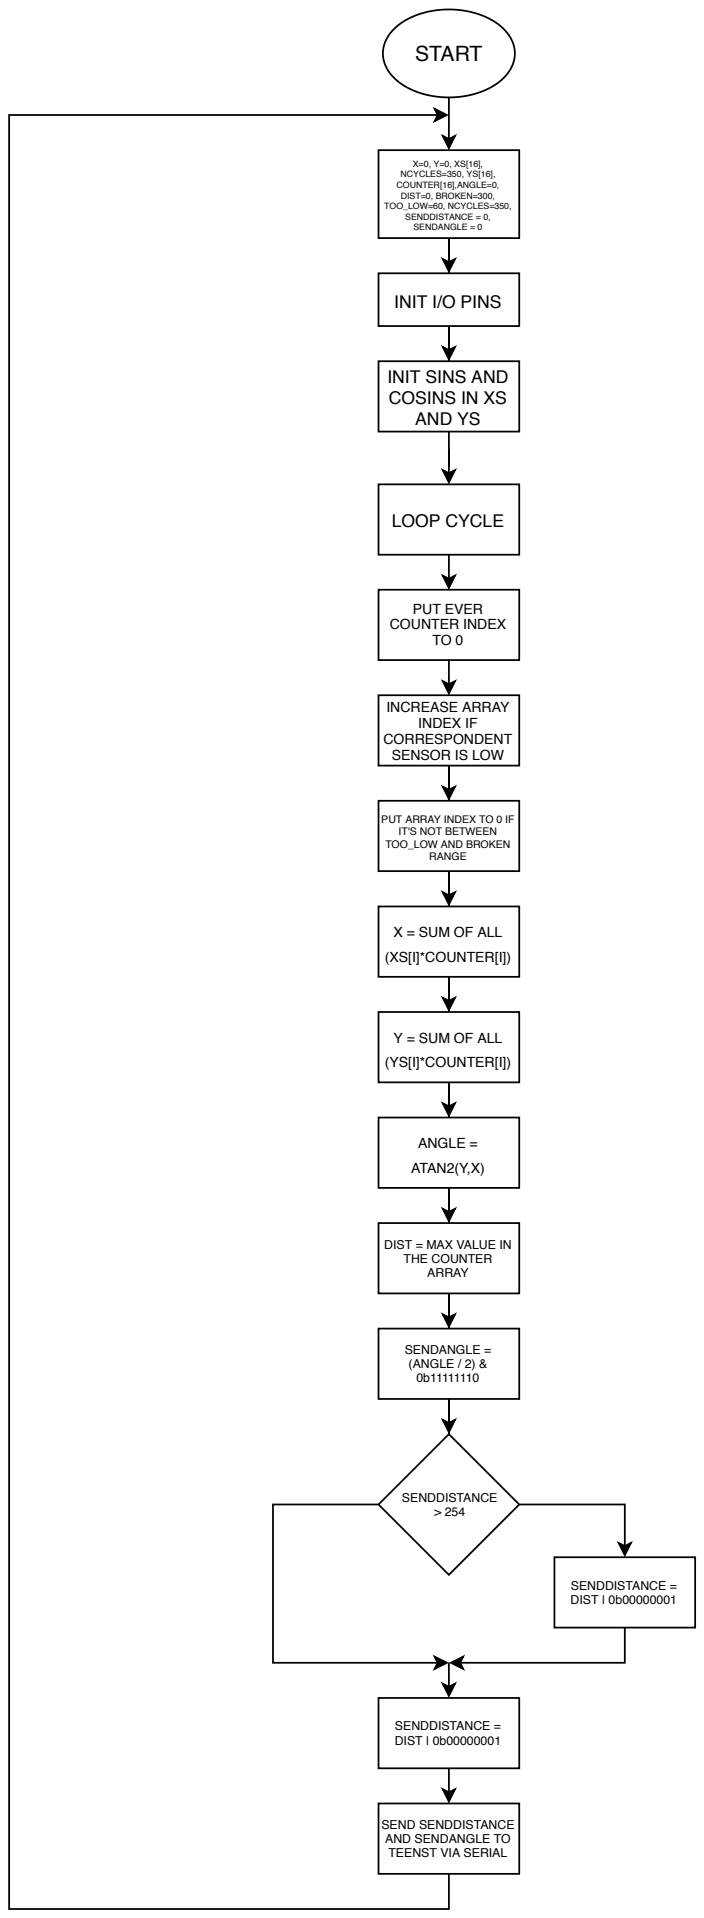
[picture p149: page 1]
X=0, Y=0, XS[16], NCYCLES=350, YS[16], COUNTER[16],ANGLE=0, DIST=0, BROKEN=300, TOO_LOW=60, NCYCLES=350, SENDDISTANCE = 0, SENDANGLE = 0; LOOP CYCLE; PUT EVER COUNTER INDEX TO 0; RANGE; ANGLE =; ATAN2(Y,X); SENDANGLE = (ANGLE / 2) & 0b11111110; SENDDISTANCE = DIST | 0b00000001; SENDDISTANCE > 254

INIT SINS AND
COSINS IN XS
AND YS

INCREASE ARRAY
INDEX IF
CORRESPONDENT
SENSOR IS LOW

PUT ARRAY INDEX TO 0 IF
IT'S NOT BETWEEN
TOO_LOW AND BROKEN

X = SUM OF ALL
(XS[I]*COUNTER[I])

Y = SUM OF ALL
(YS[I]*COUNTER[I])

DIST = MAX VALUE IN
THE COUNTER
ARRAY

SEND SENDDISTANCE
AND SENDANGLE TO
TEENST VIA SERIAL
