latino-deluxe/SPQR-Team-2019/Eagle/Sidney 2019 boards/Line sensors.brd

## EAGLE design Eagle/Sidney 2019 boards/Line sensors.brd (2019-06-11)

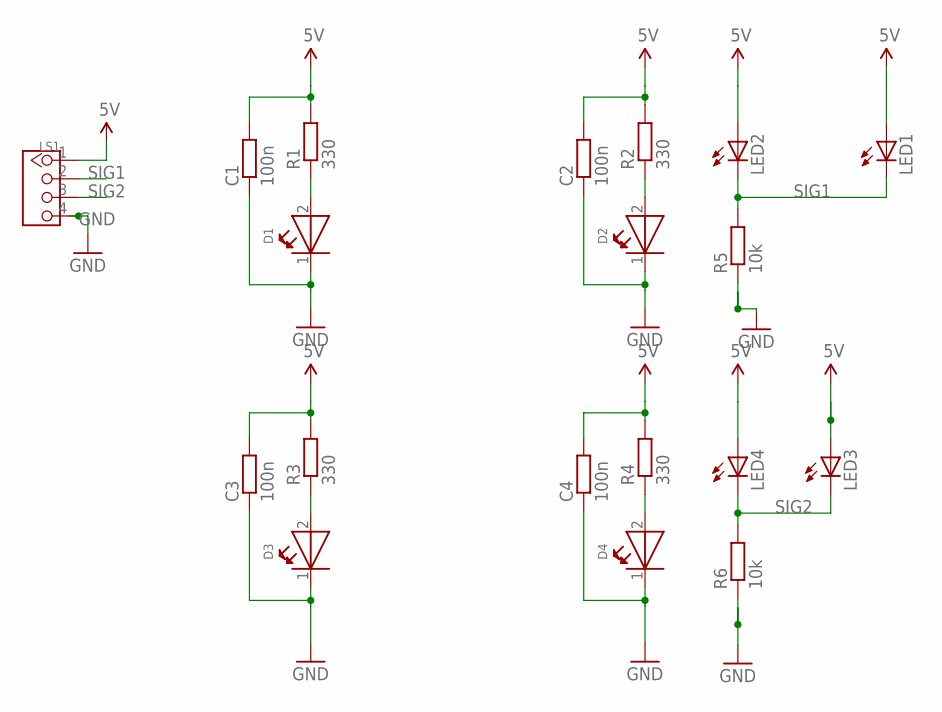
[picture p153: schematic Line sensors.sch]

Parts:
C1, C2, C3, C4: 100n; M0805
D1, D2, D3, D4: WL-SMTW-150141AS73100-A; 3528-2PIN
LED1, LED2, LED3, LED4: LED3MM
LS1: TWIG-4P-2.0-2.0; 4P-2.0
R1, R2, R3, R4: 330; M0805
R5, R6: 10k; M0805

Connections:
5V: C1.2, C2.2, C3.2, C4.2, LED1.A, LED2.A, LED3.A, LED4.A, LS1.1, R1.2, R2.2, R3.2, R4.2
GND: C1.1, C2.1, C3.1, C4.1, D1.1 (K), D2.1 (K), D3.1 (K), D4.1 (K), LS1.4, R5.1, R6.1
unnamed: D1.2 (A), R1.1
unnamed: D2.2 (A), R2.1
unnamed: D3.2 (A), R3.1
unnamed: D4.2 (A), R4.1
SIG1: LED1.K (C), LED2.K (C), LS1.2, R5.2
SIG2: LED3.K (C), LED4.K (C), LS1.3, R6.2

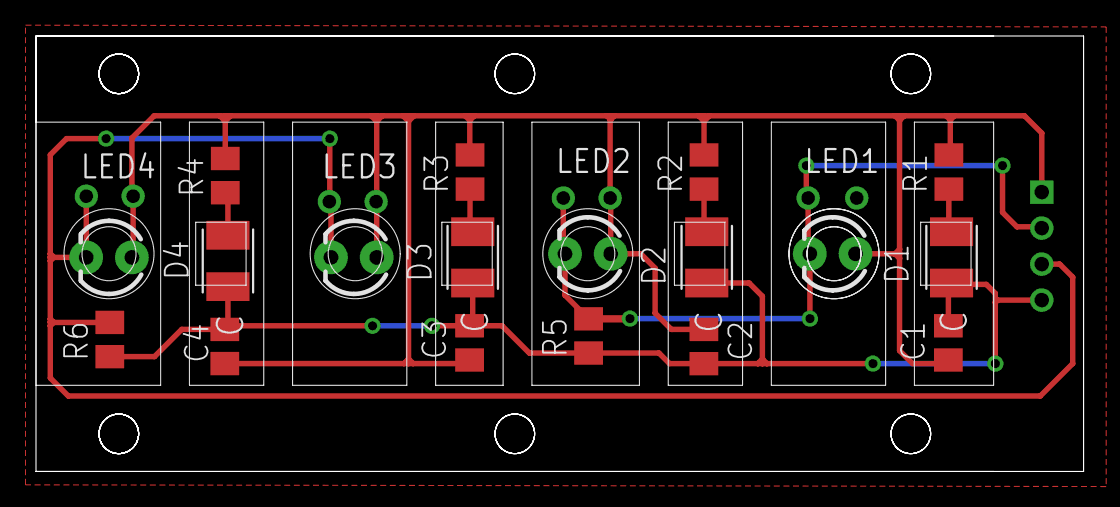
[picture p154: board Line sensors.brd from above]

Board: 2 copper layers, 58.2 x 24.2 mm, 19 parts (1 on the bottom side), 8 nets.
