latino-deluxe/SPQR-Team-2019/Eagle/Sidney 2019 boards/Motor board.brd

## EAGLE design Eagle/Sidney 2019 boards/Motor board.brd (2019-06-11)

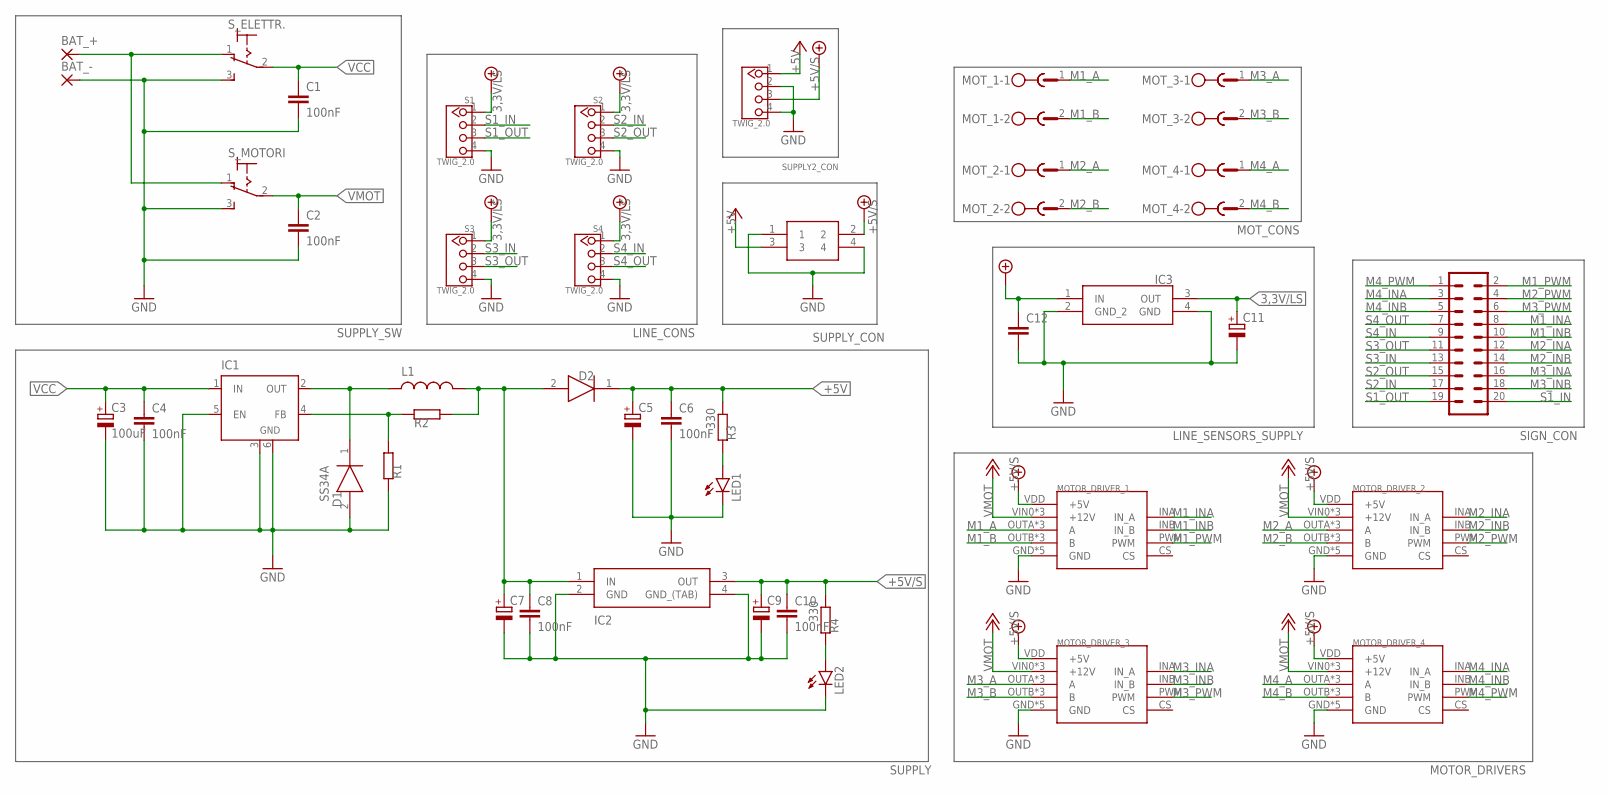
[picture p155: schematic Motor board.sch]

Parts:
BAT_+: 3,81/1,4
BAT_-: 3,81/1,4
C1, C2, C4, C6, C8, C10, C12: 100nF; C1206
C3: 100uF; CT7343
C5, C7, C9, C11: CPOL-EUE; PANASONIC_E
D1: SS34A; DIOM5026X262N
D2: SE20FG-M3_H; SODFL3718X108N
IC1: LM2596S; TO263-5
IC2: LM2940CS-5.0_NOPB; TO254P1435X464-4N
IC3: LM3940IS-3.3; TO254P1435X457-4N
L1: 47uH; MSS1260
LED1, LED2: LEDSML1206; SML1206
MOTOR_DRIVER_1, MOTOR_DRIVER_2, MOTOR_DRIVER_3, MOTOR_DRIVER_4: VNH5019
MOT_1, MOT_2, MOT_3, MOT_4: MST2V; MSTBV2
R1, R3, R4: 330; R1206
R2: 1,2k; R1206
S1, S2, S3, S4: TWIG_2.0; 2.0_1X4
SIGN_CON: 20V
SUPPLY2_CON: TWIG_2.0; 2.0_1X4
SUPPLY_CON: 39-28-1043
S_ELETTR.: 320-916
S_MOTORI: 320-916

Connections:
3,3V/LS: C11.+, IC3.3 (OUT), S1.1, S2.1, S3.1, S4.1
5.7V-DIRAMAZIONE2: C7.+, C8.1, D2.2 (A), IC2.1 (IN), L1.P$1, R2.1
+5V: C5.+, C6.1, D2.1 (K), R3.1, SUPPLY2_CON.1, SUPPLY_CON.3
+5V/S: C9.+, C10.1, C12.1, IC2.3 (OUT), IC3.1 (IN), MOTOR_DRIVER_1.VDD (+5V), MOTOR_DRIVER_2.VDD (+5V), MOTOR_DRIVER_3.VDD (+5V), MOTOR_DRIVER_4.VDD (+5V), R4.1, SUPPLY2_CON.3, SUPPLY_CON.2
GND: BAT_-.1, C1.2, C2.2, C3.-, C4.2, C5.-, C6.2, C7.-, C8.2, C9.-, C10.2, C11.-, C12.2, D1.2 (A), IC1.3 (GND), IC1.5 (EN), IC1.6 (GND), IC2.2 (GND), IC2.4 (GND_(TAB)), IC3.2 (GND_2), IC3.4 (GND), LED1.C, LED2.C, MOTOR_DRIVER_1.GND, MOTOR_DRIVER_1.GND0 (GND), MOTOR_DRIVER_1.GND1 (GND), MOTOR_DRIVER_1.GND2 (GND), MOTOR_DRIVER_1.GND3 (GND), MOTOR_DRIVER_2.GND, MOTOR_DRIVER_2.GND0 (GND), MOTOR_DRIVER_2.GND1 (GND), MOTOR_DRIVER_2.GND2 (GND), MOTOR_DRIVER_2.GND3 (GND), MOTOR_DRIVER_3.GND, MOTOR_DRIVER_3.GND0 (GND), MOTOR_DRIVER_3.GND1 (GND), MOTOR_DRIVER_3.GND2 (GND), MOTOR_DRIVER_3.GND3 (GND), MOTOR_DRIVER_4.GND, MOTOR_DRIVER_4.GND0 (GND), MOTOR_DRIVER_4.GND1 (GND), MOTOR_DRIVER_4.GND2 (GND), MOTOR_DRIVER_4.GND3 (GND), R1.1, S1.4, S2.4, S3.4, S4.4, SUPPLY2_CON.2, SUPPLY2_CON.4, SUPPLY_CON.1, SUPPLY_CON.4, S_ELETTR..3 (S), S_MOTORI.3 (S)
M1_A: MOTOR_DRIVER_1.OUTA (A), MOTOR_DRIVER_1.OUTA2 (A), MOTOR_DRIVER_1.OUTA3 (A), MOT_1.1
M1_B: MOTOR_DRIVER_1.OUTB (B), MOTOR_DRIVER_1.OUTB1 (B), MOTOR_DRIVER_1.OUTB3 (B), MOT_1.2
M1_INA: MOTOR_DRIVER_1.INA (IN_A), SIGN_CON.8
M1_INB: MOTOR_DRIVER_1.INB (IN_B), SIGN_CON.10
M1_PWM: MOTOR_DRIVER_1.PWM, SIGN_CON.2
M2_A: MOTOR_DRIVER_2.OUTA (A), MOTOR_DRIVER_2.OUTA2 (A), MOTOR_DRIVER_2.OUTA3 (A), MOT_2.1
M2_B: MOTOR_DRIVER_2.OUTB (B), MOTOR_DRIVER_2.OUTB1 (B), MOTOR_DRIVER_2.OUTB3 (B), MOT_2.2
M2_INA: MOTOR_DRIVER_2.INA (IN_A), SIGN_CON.12
M2_INB: MOTOR_DRIVER_2.INB (IN_B), SIGN_CON.14
M2_PWM: MOTOR_DRIVER_2.PWM, SIGN_CON.4
M3_A: MOTOR_DRIVER_3.OUTA (A), MOTOR_DRIVER_3.OUTA2 (A), MOTOR_DRIVER_3.OUTA3 (A), MOT_3.1
M3_B: MOTOR_DRIVER_3.OUTB (B), MOTOR_DRIVER_3.OUTB1 (B), MOTOR_DRIVER_3.OUTB3 (B), MOT_3.2
M3_INA: MOTOR_DRIVER_3.INA (IN_A), SIGN_CON.16
M3_INB: MOTOR_DRIVER_3.INB (IN_B), SIGN_CON.18
M3_PWM: MOTOR_DRIVER_3.PWM, SIGN_CON.6
M4_A: MOTOR_DRIVER_4.OUTA (A), MOTOR_DRIVER_4.OUTA2 (A), MOTOR_DRIVER_4.OUTA3 (A), MOT_4.1
M4_B: MOTOR_DRIVER_4.OUTB (B), MOTOR_DRIVER_4.OUTB1 (B), MOTOR_DRIVER_4.OUTB3 (B), MOT_4.2
M4_INA: MOTOR_DRIVER_4.INA (IN_A), SIGN_CON.3
M4_INB: MOTOR_DRIVER_4.INB (IN_B), SIGN_CON.5
M4_PWM: MOTOR_DRIVER_4.PWM, SIGN_CON.1
unnamed: BAT_+.1, S_ELETTR..1 (O), S_MOTORI.1 (O)
unnamed: LED2.A, R4.2
unnamed: LED1.A, R3.2
unnamed: D1.1 (K), IC1.2 (OUT), L1.P$2
unnamed: IC1.4 (FB), R1.2, R2.2
S1_IN: S1.2, SIGN_CON.20
S1_OUT: S1.3, SIGN_CON.19
S2_IN: S2.2, SIGN_CON.17
S2_OUT: S2.3, SIGN_CON.15
S3_IN: S3.2, SIGN_CON.13
S3_OUT: S3.3, SIGN_CON.11
S4_IN: S4.2, SIGN_CON.9
S4_OUT: S4.3, SIGN_CON.7
VCC: C1.1, C3.+, C4.1, IC1.1 (IN), S_ELETTR..2
VMOT: C2.1, MOTOR_DRIVER_1.VIN0 (+12V), MOTOR_DRIVER_1.VIN1 (+12V), MOTOR_DRIVER_1.VIN2 (+12V), MOTOR_DRIVER_2.VIN0 (+12V), MOTOR_DRIVER_2.VIN1 (+12V), MOTOR_DRIVER_2.VIN2 (+12V), MOTOR_DRIVER_3.VIN0 (+12V), MOTOR_DRIVER_3.VIN1 (+12V), MOTOR_DRIVER_3.VIN2 (+12V), MOTOR_DRIVER_4.VIN0 (+12V), MOTOR_DRIVER_4.VIN1 (+12V), MOTOR_DRIVER_4.VIN2 (+12V), S_MOTORI.2

Notes on the sheet:
SUPPLY_SW
SUPPLY
LINE_CONS
MOT_CONS
MOTOR_DRIVERS
LINE_SENSORS_SUPPLY

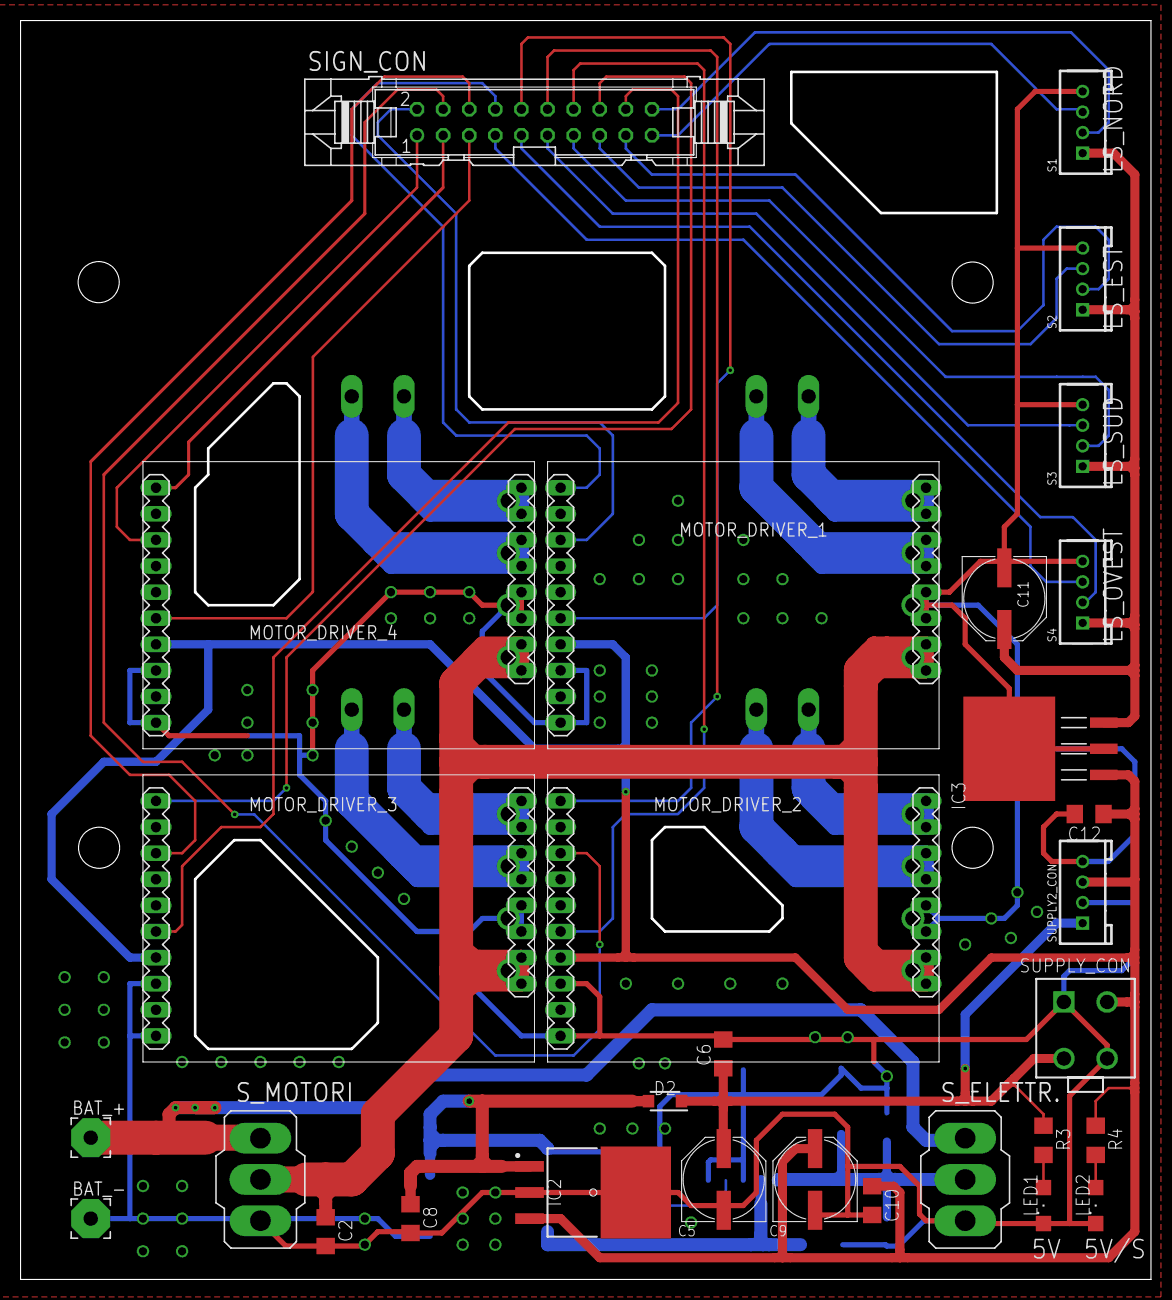
[picture p156: board Motor board.brd from above]

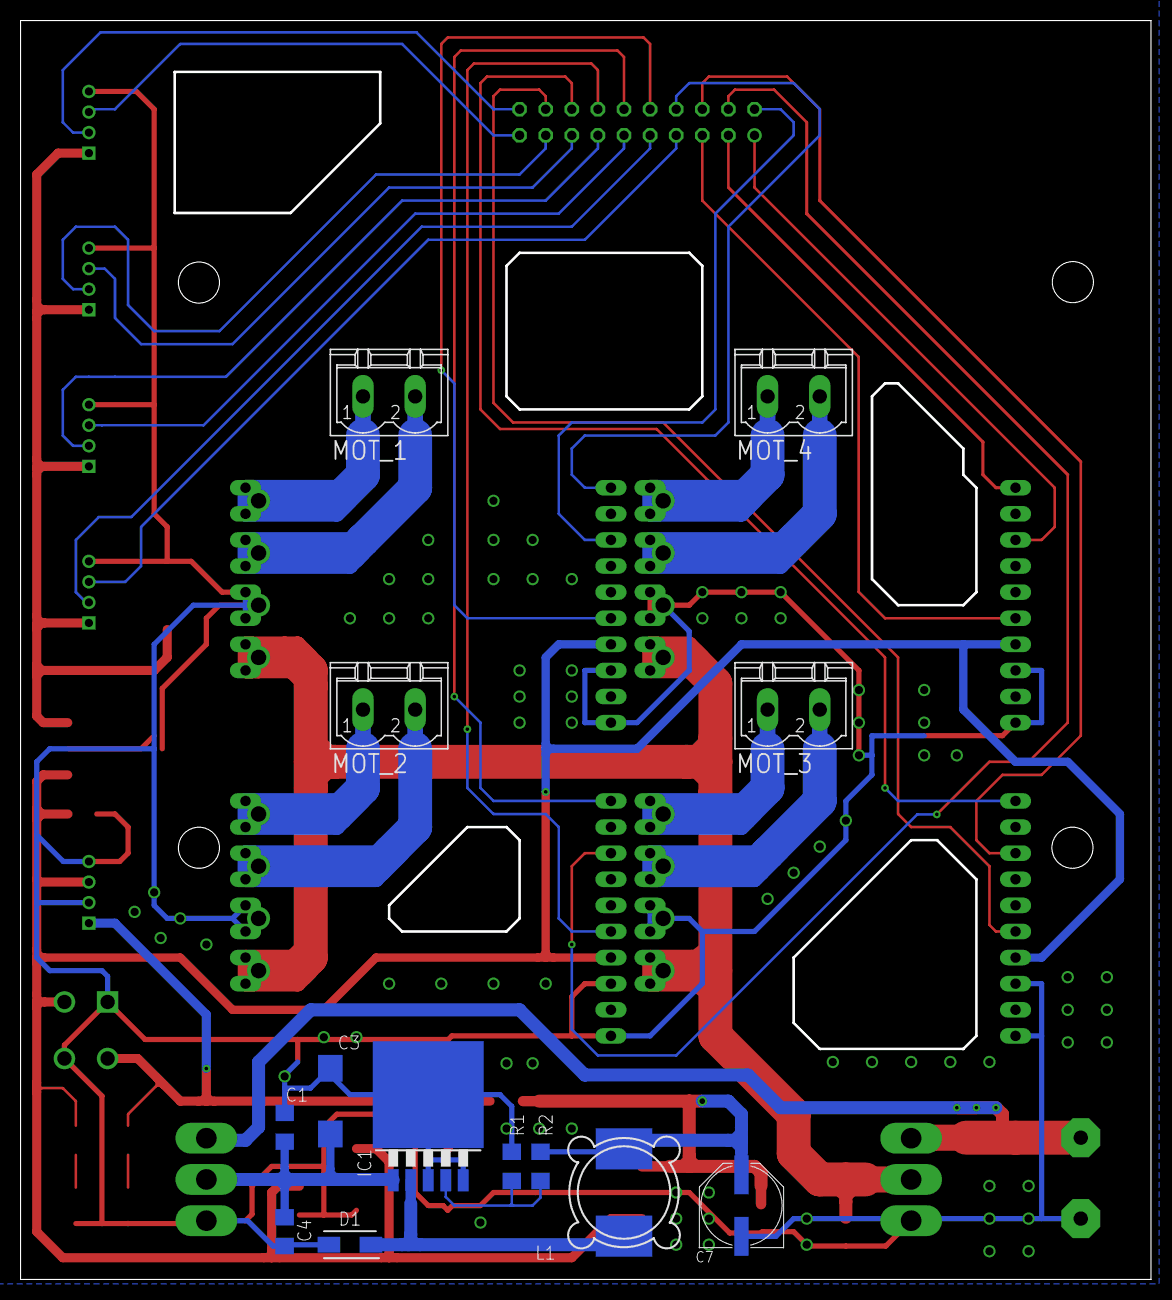
[picture p157: board Motor board.brd from below]

Board: 2 copper layers, 110.0 x 122.5 mm, 43 parts (13 on the bottom side), 40 nets.
