latino-deluxe/SPQR-Team-2019/Eagle/Old boards/Teensy board v2.brd

## EAGLE design Eagle/Old boards/Teensy board v2.brd (2019-05-21, an earlier design)

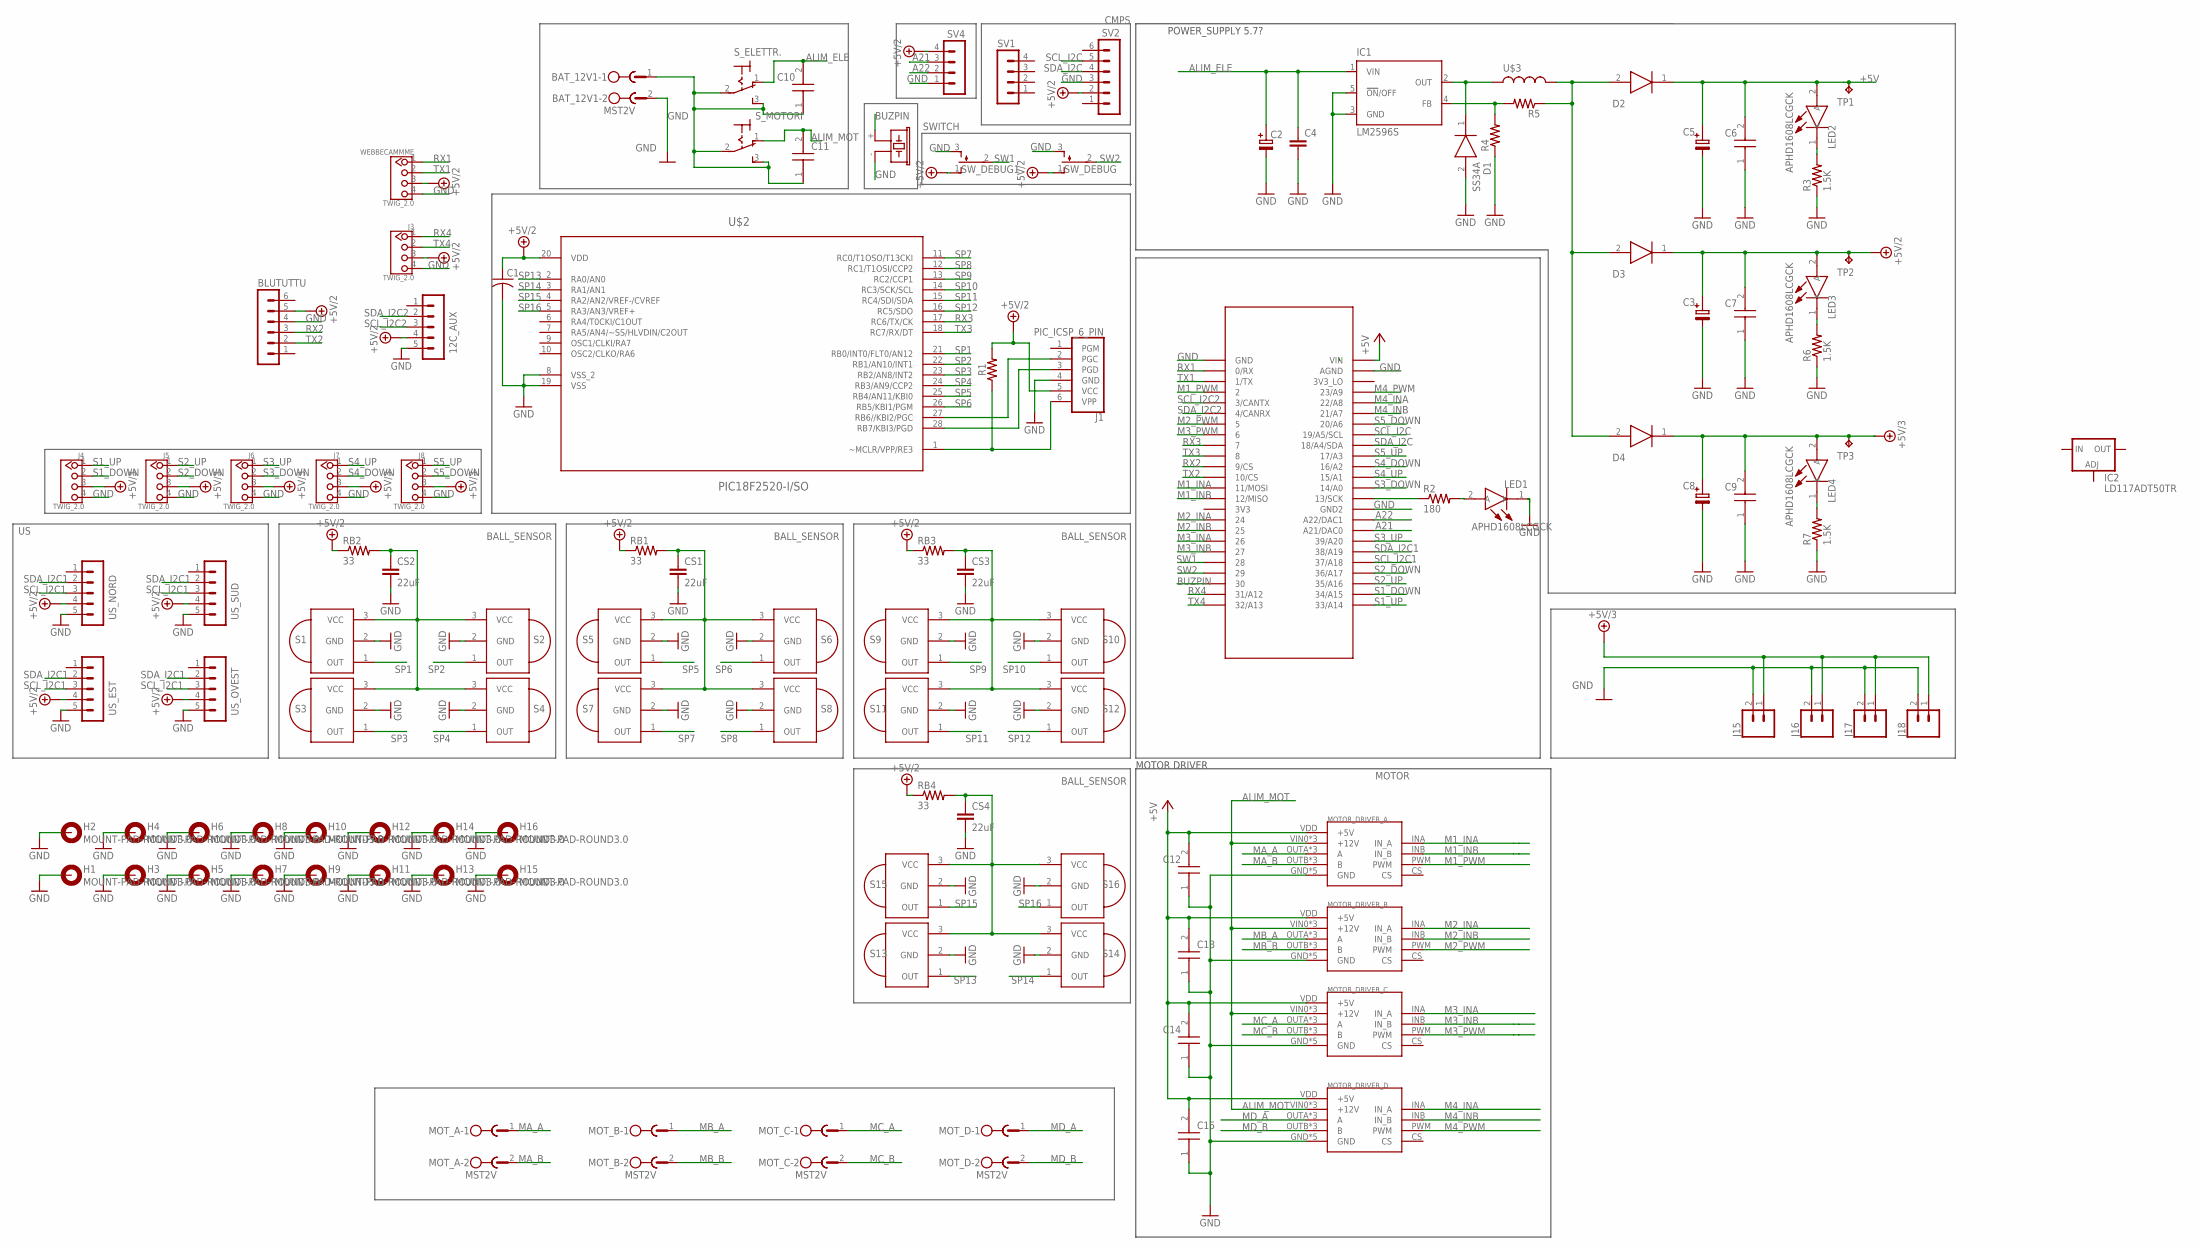
[picture p161: schematic Teensy board v2.sch]

Parts:
12C_AUX: MA05-1
BAT_12V1: MST2V; MSTBV2
BLUTUTTU: MA06-1
C1: C-USC1206; C1206
C2, C3, C5, C8: C-PR-SMD-SV-E/F; SV-E/F
C4: CC1206; C1206
C6, C7, C9, C10, C11, C12, C13, C14, C15: 12065D106KAT2A; CAPC3216X229N
CS1, CS2, CS3, CS4: 22uF; C1206
D1: SS34A; DIOM5026X262N
D2, D3, D4: SE20FG-M3_H; SODFL3718X108N
H1, H2, H3, H4, H5, H6, H7, H8, H9, H10, H11, H12, H13, H14, H15, H16: MOUNT-PAD-ROUND3.0; 3,0-PAD
IC1: LM2596S; TO263-5
IC2: LD117ADT50TR; DPACK
J1: PIC_ICSP_6_PIN; MOLEX-1X6
J3, J4, J5, J6, J7, J8: TWIG_2.0; 2.0_1X4
J15, J16, J17, J18: CONN_02; 1X02
LED1, LED2, LED3, LED4: APHD1608LCGCK; LEDM168X80N
MOTOR_DRIVER_A: VNH5019
MOTOR_DRIVER_B: VNH5019
MOTOR_DRIVER_C: VNH5019
MOTOR_DRIVER_D: VNH5019
MOT_A: MST2V; MSTBV2
MOT_B: MST2V; MSTBV2
MOT_C: MST2V; MSTBV2
MOT_D: MST2V; MSTBV2
R1: 10k; M1206
R2: 180; M1206
R3, R6, R7: 1.5K; R1206
R4, R5: R-US_R1206; R1206
RB1, RB2, RB3, RB4: 33; M1206
S1, S2, S3, S4, S5, S6, S7, S8, S9, S10, S11, S12, S13, S14, S15, S16: PNA460XM
SG1: F/CM12P
SV1, SV4: MA04-1
SV2: MA06-1
SW_DEBUG, SW_DEBUG1: TL38PO; TL3XPO
S_ELETTR.: 320-916
S_MOTORI: 320-916
TP1, TP2, TP3: TPTP13SQ; TP13SQ
U$1: TEENSY_3.5/3.6
U$2: PIC18F2520-I/SO; SOIC127P1030X265-28N
U$3: MSS1260
US_EST: MA05-1
US_NORD: MA05-1
US_OVEST: MA05-1
US_SUD: MA05-1
WEBBECAMMME: TWIG_2.0; 2.0_1X4

Connections:
5.7V-DIRAMAZIONE2: D2.2 (A), D3.2 (A), D4.2 (A), R5.1, U$3.P$1
+5V: C5.+, C6.2, D2.1 (K), LED2.2 (A), TP1.TP, U$1.VIN
+5V/2: 12C_AUX.4, BLUTUTTU.5, C1.1, C3.+, C7.2, D3.1 (K), J1.5 (VCC), J3.3, LED3.2 (A), R1.2, RB1.1, RB2.1, RB3.1, RB4.1, SV2.2, SV4.4, SW_DEBUG.1 (O), SW_DEBUG1.1 (O), TP2.TP, U$2.20 (VDD), US_EST.4, US_NORD.4, US_OVEST.4, US_SUD.4, WEBBECAMMME.3
+5V/3: C8.+, C9.2, D4.1 (K), J4.3, J5.3, J6.3, J7.3, J8.3, J15.1, J16.1, J17.1, J18.1, LED4.2 (A), TP3.TP
A21: SV4.3, U$1.21/DAC0 (A21/DAC0)
A22: SV4.2, U$1.A22/DAC1
ALIM_ELE: C2.+, C4.1, C10.2, IC1.1 (VIN), S_ELETTR..1 (O)
ALIM_MOT: C11.2, MOTOR_DRIVER_A.VIN0 (+12V), MOTOR_DRIVER_A.VIN1 (+12V), MOTOR_DRIVER_A.VIN2 (+12V), MOTOR_DRIVER_B.VIN0 (+12V), MOTOR_DRIVER_B.VIN1 (+12V), MOTOR_DRIVER_B.VIN2 (+12V), MOTOR_DRIVER_C.VIN0 (+12V), MOTOR_DRIVER_C.VIN1 (+12V), MOTOR_DRIVER_C.VIN2 (+12V), MOTOR_DRIVER_D.VIN0 (+12V), MOTOR_DRIVER_D.VIN1 (+12V), MOTOR_DRIVER_D.VIN2 (+12V), S_MOTORI.1 (O)
BUZPIN: SG1.+ (1), U$1.30
GND: 12C_AUX.5, BAT_12V1.2, BLUTUTTU.4, C1.2, C2.-, C3.-, C4.2, C5.-, C6.1, C7.1, C8.-, C9.1, C12.1, C13.1, C14.1, C15.1, CS1.2, CS2.2, CS3.2, CS4.2, D1.2 (A), H1.B3,0, H2.B3,0, H3.B3,0, H4.B3,0, H5.B3,0, H6.B3,0, H7.B3,0, H8.B3,0, H9.B3,0, H10.B3,0, H11.B3,0, H12.B3,0, H13.B3,0, H14.B3,0, H15.B3,0, H16.B3,0, IC1.3 (GND), IC1.5 (!ON!/OFF), J1.4 (GND), J3.4, J4.4, J5.4, J6.4, J7.4, J8.4, J15.2, J16.2, J17.2, J18.2, LED1.1 (K), MOTOR_DRIVER_A.GND, MOTOR_DRIVER_A.GND0 (GND), MOTOR_DRIVER_A.GND1 (GND), MOTOR_DRIVER_A.GND2 (GND), MOTOR_DRIVER_A.GND3 (GND), MOTOR_DRIVER_B.GND, MOTOR_DRIVER_B.GND0 (GND), MOTOR_DRIVER_B.GND1 (GND), MOTOR_DRIVER_B.GND2 (GND), MOTOR_DRIVER_B.GND3 (GND), MOTOR_DRIVER_C.GND, MOTOR_DRIVER_C.GND0 (GND), MOTOR_DRIVER_C.GND1 (GND), MOTOR_DRIVER_C.GND2 (GND), MOTOR_DRIVER_C.GND3 (GND), MOTOR_DRIVER_D.GND, MOTOR_DRIVER_D.GND0 (GND), MOTOR_DRIVER_D.GND1 (GND), MOTOR_DRIVER_D.GND2 (GND), MOTOR_DRIVER_D.GND3 (GND), R3.1, R4.1, R6.1, R7.1, S1.2 (GND), S2.2 (GND), S3.2 (GND), S4.2 (GND), S5.2 (GND), S6.2 (GND), S7.2 (GND), S8.2 (GND), S9.2 (GND), S10.2 (GND), S11.2 (GND), S12.2 (GND), S13.2 (GND), S14.2 (GND), S15.2 (GND), S16.2 (GND), SG1.- (2), SV2.3, SV4.1, SW_DEBUG.3 (S), SW_DEBUG1.3 (S), U$1.AGND, U$1.GND, U$1.GND2, U$2.8 (VSS_2), U$2.19 (VSS), US_EST.5, US_NORD.5, US_OVEST.5, US_SUD.5, WEBBECAMMME.4
M1_INA: MOTOR_DRIVER_A.INA (IN_A), U$1.11/MOSI
M1_INB: MOTOR_DRIVER_A.INB (IN_B), U$1.12/MISO
M1_PWM: MOTOR_DRIVER_A.PWM, U$1.2
M2_INA: MOTOR_DRIVER_B.INA (IN_A), U$1.24
M2_INB: MOTOR_DRIVER_B.INB (IN_B), U$1.25
M2_PWM: MOTOR_DRIVER_B.PWM, U$1.5
M3_INA: MOTOR_DRIVER_C.INA (IN_A), U$1.26
M3_INB: MOTOR_DRIVER_C.INB (IN_B), U$1.27
M3_PWM: MOTOR_DRIVER_C.PWM, U$1.6
M4_INA: MOTOR_DRIVER_D.INA (IN_A), U$1.22/A8
M4_INB: MOTOR_DRIVER_D.INB (IN_B), U$1.21/A7
M4_PWM: MOTOR_DRIVER_D.PWM, U$1.23/A9
MA_A: MOTOR_DRIVER_A.OUTA (A), MOTOR_DRIVER_A.OUTA2 (A), MOTOR_DRIVER_A.OUTA3 (A), MOT_A.1
MA_B: MOTOR_DRIVER_A.OUTB (B), MOTOR_DRIVER_A.OUTB1 (B), MOTOR_DRIVER_A.OUTB3 (B), MOT_A.2
MB_A: MOTOR_DRIVER_B.OUTA (A), MOTOR_DRIVER_B.OUTA2 (A), MOTOR_DRIVER_B.OUTA3 (A), MOT_B.1
MB_B: MOTOR_DRIVER_B.OUTB (B), MOTOR_DRIVER_B.OUTB1 (B), MOTOR_DRIVER_B.OUTB3 (B), MOT_B.2
MC_A: MOTOR_DRIVER_C.OUTA (A), MOTOR_DRIVER_C.OUTA2 (A), MOTOR_DRIVER_C.OUTA3 (A), MOT_C.1
MC_B: MOTOR_DRIVER_C.OUTB (B), MOTOR_DRIVER_C.OUTB1 (B), MOTOR_DRIVER_C.OUTB3 (B), MOT_C.2
MD_A: MOTOR_DRIVER_D.OUTA (A), MOTOR_DRIVER_D.OUTA2 (A), MOTOR_DRIVER_D.OUTA3 (A), MOT_D.1
MD_B: MOTOR_DRIVER_D.OUTB (B), MOTOR_DRIVER_D.OUTB1 (B), MOTOR_DRIVER_D.OUTB3 (B), MOT_D.2
unnamed: J1.6 (VPP), R1.1, U$2.1 (~MCLR/VPP/RE3)
unnamed: J1.3 (PGD), U$2.28 (RB7/KBI3/PGD)
unnamed: J1.2 (PGC), U$2.27 (RB6//KBI2/PGC)
unnamed: R2.1, U$1.13/SCK
unnamed: LED1.2 (A), R2.2
unnamed: C12.2, C13.2, C14.2, C15.2, D1.1 (K), IC1.2 (OUT), MOTOR_DRIVER_A.VDD (+5V), MOTOR_DRIVER_B.VDD (+5V), MOTOR_DRIVER_C.VDD (+5V), MOTOR_DRIVER_D.VDD (+5V), U$3.P$2
unnamed: IC1.4 (FB), R4.2, R5.2
unnamed: LED2.1 (K), R3.2
unnamed: LED3.1 (K), R6.2
unnamed: LED4.1 (K), R7.2
unnamed: BAT_12V1.1, C10.1, C11.1, S_ELETTR..2, S_ELETTR..3 (S), S_MOTORI.2, S_MOTORI.3 (S)
POWER_BLOK_1: CS1.1, RB1.2, S5.3 (VCC), S6.3 (VCC), S7.3 (VCC), S8.3 (VCC)
POWER_BLOK_2: CS2.1, RB2.2, S1.3 (VCC), S2.3 (VCC), S3.3 (VCC), S4.3 (VCC)
POWER_BLOK_3: CS3.1, RB3.2, S9.3 (VCC), S10.3 (VCC), S11.3 (VCC), S12.3 (VCC)
POWER_BLOK_4: CS4.1, RB4.2, S13.3 (VCC), S14.3 (VCC), S15.3 (VCC), S16.3 (VCC)
RX1: U$1.0/RX, WEBBECAMMME.1
RX2: BLUTUTTU.3, U$1.9/CS
RX3: U$1.7, U$2.17 (RC6/TX/CK)
RX4: J3.1, U$1.31/A12
S1_DOWN: J4.2, U$1.34/A15
S1_UP: J4.1, U$1.33/A14
S2_DOWN: J5.2, U$1.36/A17
S2_UP: J5.1, U$1.35/A16
S3_DOWN: J6.2, U$1.14/A0
S3_UP: J6.1, U$1.39/A20
S4_DOWN: J7.2, U$1.16/A2
S4_UP: J7.1, U$1.15/A1
S5_DOWN: J8.2, U$1.20/A6
S5_UP: J8.1, U$1.17/A3
SCL_I2C: SV2.5, U$1.19/A5/SCL
SCL_I2C1: U$1.37/A18, US_EST.3, US_NORD.3, US_OVEST.3, US_SUD.3
SCL_I2C2: 12C_AUX.3, U$1.3/CANTX
SDA_I2C: SV2.4, U$1.18/A4/SDA
SDA_I2C1: U$1.38/A19, US_EST.2, US_NORD.2, US_OVEST.2, US_SUD.2
SDA_I2C2: 12C_AUX.2, U$1.4/CANRX
SP1: S1.1 (OUT), U$2.21 (RB0/INT0/FLT0/AN12)
SP2: S2.1 (OUT), U$2.22 (RB1/AN10/INT1)
SP3: S3.1 (OUT), U$2.23 (RB2/AN8/INT2)
SP4: S4.1 (OUT), U$2.24 (RB3/AN9/CCP2)
SP5: S5.1 (OUT), U$2.25 (RB4/AN11/KBI0)
SP6: S6.1 (OUT), U$2.26 (RB5/KBI1/PGM)
SP7: S7.1 (OUT), U$2.11 (RC0/T1OSO/T13CKI)
SP8: S8.1 (OUT), U$2.12 (RC1/T1OSI/CCP2)
SP9: S9.1 (OUT), U$2.13 (RC2/CCP1)
SP10: S10.1 (OUT), U$2.14 (RC3/SCK/SCL)
SP11: S11.1 (OUT), U$2.15 (RC4/SDI/SDA)
SP12: S12.1 (OUT), U$2.16 (RC5/SDO)
SP13: S13.1 (OUT), U$2.2 (RA0/AN0)
SP14: S14.1 (OUT), U$2.3 (RA1/AN1)
SP15: S15.1 (OUT), U$2.4 (RA2/AN2/VREF-/CVREF)
SP16: S16.1 (OUT), U$2.5 (RA3/AN3/VREF+)
SW1: SW_DEBUG1.2, U$1.28
SW2: SW_DEBUG.2, U$1.29
TX1: U$1.1/TX, WEBBECAMMME.2
TX2: BLUTUTTU.2, U$1.10/CS
TX3: U$1.8, U$2.18 (RC7/RX/DT)
TX4: J3.2, U$1.32/A13

Notes on the sheet:
CMPS
BALL_SENSOR
MOTOR
SWITCH
POWER_SUPPLY 5.7?
MOTOR DRIVER

Board: 2 copper layers, 113 parts (29 on the bottom side), 87 nets, no tracks yet.
