latino-deluxe/SPQR-Team-2019/Eagle/Old boards/Test 2019.brd

## EAGLE design Eagle/Old boards/Test 2019.brd (2019-05-21, an earlier design)

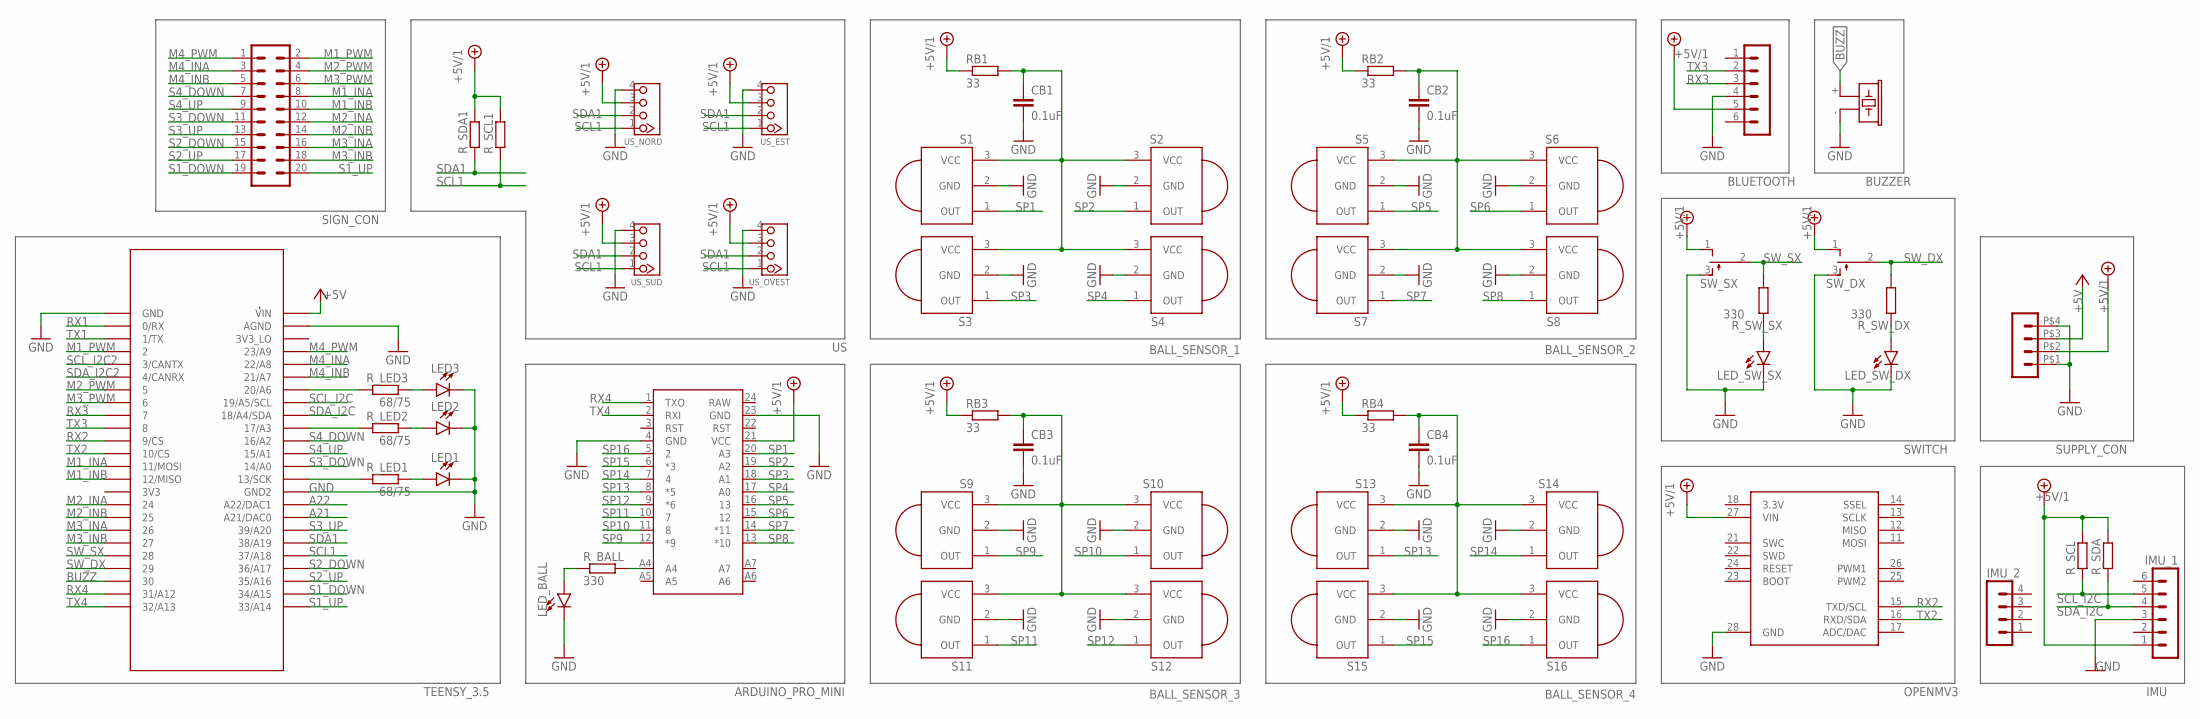
[picture p162: schematic Test 2019.sch]

Parts:
ARDUINO_PRO_MINI: ARDUINO_PRO_MINI
BLUETOOTH: MA06-1
BUZZER: F/CM12P
CB1, CB2, CB3, CB4: 0.1uF; C1206
IMU_1: MA06-1
IMU_2: MA04-1
LED1, LED2, LED3: LED3MM; LED_3MM
LED_BALL: LED3MM; LED_3MM
LED_SW_DX: LED3MM; LED_3MM
LED_SW_SX: LED3MM; LED_3MM
RB1, RB2, RB3, RB4: 33; R0805
R_BALL: 330; R1206
R_LED1, R_LED2, R_LED3: 68/75; R0805
R_SCL, R_SCL1: 3.3k; R0805
R_SDA, R_SDA1: 3.3k; R0805
R_SW_DX: 330; R0805
R_SW_SX: 330; R0805
S1, S2, S3, S4, S5, S6, S7, S8, S9, S10, S11, S12, S13, S14, S15, S16: PNA460XM
SIGN_CON: 20V
SUPPLY_CON: HEADER_POS4_43045-0412; 43045-0412
SW_DX: TL38PO; TL3XPO
SW_SX: TL38PO; TL3XPO
TEENSY_3.5: TEENSY_3.5/3.6
U$2: OPENMV3
US_EST: TWIG_2.0; 2.0_1X4
US_NORD: TWIG_2.0; 2.0_1X4
US_OVEST: TWIG_2.0; 2.0_1X4
US_SUD: TWIG_2.0; 2.0_1X4

Connections:
+5V: SUPPLY_CON.P$3 (3), TEENSY_3.5.VIN
+5V/1: ARDUINO_PRO_MINI.21 (VCC), BLUETOOTH.5, IMU_1.1, RB1.1, RB2.1, RB3.1, RB4.1, R_SCL.2, R_SCL1.2, R_SDA.2, R_SDA1.2, SUPPLY_CON.P$2 (2), SW_DX.1 (O), SW_SX.1 (O), U$2.27 (VIN), US_EST.3, US_NORD.3, US_OVEST.3, US_SUD.3
A21: TEENSY_3.5.21/DAC0 (A21/DAC0)
A22: TEENSY_3.5.A22/DAC1
BUZZ: BUZZER.+ (1), TEENSY_3.5.30
GND: ARDUINO_PRO_MINI.4 (GND), ARDUINO_PRO_MINI.23 (GND), BLUETOOTH.4, BUZZER.- (2), CB1.2, CB2.2, CB3.2, CB4.2, IMU_1.3, LED1.K (C), LED2.K (C), LED3.K (C), LED_BALL.K (C), LED_SW_DX.K (C), LED_SW_SX.K (C), S1.2 (GND), S2.2 (GND), S3.2 (GND), S4.2 (GND), S5.2 (GND), S6.2 (GND), S7.2 (GND), S8.2 (GND), S9.2 (GND), S10.2 (GND), S11.2 (GND), S12.2 (GND), S13.2 (GND), S14.2 (GND), S15.2 (GND), S16.2 (GND), SUPPLY_CON.P$1 (1), SUPPLY_CON.P$4 (4), SW_DX.3 (S), SW_SX.3 (S), TEENSY_3.5.AGND, TEENSY_3.5.GND, TEENSY_3.5.GND2, U$2.28 (GND), US_EST.4, US_NORD.4, US_OVEST.4, US_SUD.4
M1_INA: SIGN_CON.8, TEENSY_3.5.11/MOSI
M1_INB: SIGN_CON.10, TEENSY_3.5.12/MISO
M1_PWM: SIGN_CON.2, TEENSY_3.5.2
M2_INA: SIGN_CON.12, TEENSY_3.5.24
M2_INB: SIGN_CON.14, TEENSY_3.5.25
M2_PWM: SIGN_CON.4, TEENSY_3.5.5
M3_INA: SIGN_CON.16, TEENSY_3.5.26
M3_INB: SIGN_CON.18, TEENSY_3.5.27
M3_PWM: SIGN_CON.6, TEENSY_3.5.6
M4_INA: SIGN_CON.3, TEENSY_3.5.22/A8
M4_INB: SIGN_CON.5, TEENSY_3.5.21/A7
M4_PWM: SIGN_CON.1, TEENSY_3.5.23/A9
unnamed: R_LED1.1, TEENSY_3.5.13/SCK
unnamed: LED1.A, R_LED1.2
unnamed: LED_BALL.A, R_BALL.1
unnamed: ARDUINO_PRO_MINI.A4, R_BALL.2
unnamed: LED_SW_SX.A, R_SW_SX.1
unnamed: LED2.A, R_LED2.2
unnamed: LED3.A, R_LED3.2
unnamed: R_LED3.1, TEENSY_3.5.20/A6
unnamed: R_LED2.1, TEENSY_3.5.17/A3
unnamed: LED_SW_DX.A, R_SW_DX.1
POWER_BLOK_1: CB2.1, RB2.2, S5.3 (VCC), S6.3 (VCC), S7.3 (VCC), S8.3 (VCC)
POWER_BLOK_2: CB1.1, RB1.2, S1.3 (VCC), S2.3 (VCC), S3.3 (VCC), S4.3 (VCC)
POWER_BLOK_3: CB3.1, RB3.2, S9.3 (VCC), S10.3 (VCC), S11.3 (VCC), S12.3 (VCC)
POWER_BLOK_4: CB4.1, RB4.2, S13.3 (VCC), S14.3 (VCC), S15.3 (VCC), S16.3 (VCC)
RAW: ARDUINO_PRO_MINI.24 (RAW)
RX1: TEENSY_3.5.0/RX
RX2: TEENSY_3.5.9/CS, U$2.15 (TXD/SCL)
RX3: BLUETOOTH.3, TEENSY_3.5.7
RX4: ARDUINO_PRO_MINI.1 (TXO), TEENSY_3.5.31/A12
S1_DOWN: SIGN_CON.19, TEENSY_3.5.34/A15
S1_UP: SIGN_CON.20, TEENSY_3.5.33/A14
S2_DOWN: SIGN_CON.15, TEENSY_3.5.36/A17
S2_UP: SIGN_CON.17, TEENSY_3.5.35/A16
S3_DOWN: SIGN_CON.11, TEENSY_3.5.14/A0
S3_UP: SIGN_CON.13, TEENSY_3.5.39/A20
S4_DOWN: SIGN_CON.7, TEENSY_3.5.16/A2
S4_UP: SIGN_CON.9, TEENSY_3.5.15/A1
SCL1: R_SCL1.1, TEENSY_3.5.37/A18, US_EST.1, US_NORD.1, US_OVEST.1, US_SUD.1
SCL_I2C: IMU_1.5, R_SCL.1, TEENSY_3.5.19/A5/SCL
SCL_I2C2: TEENSY_3.5.3/CANTX
SDA1: R_SDA1.1, TEENSY_3.5.38/A19, US_EST.2, US_NORD.2, US_OVEST.2, US_SUD.2
SDA_I2C: IMU_1.4, R_SDA.1, TEENSY_3.5.18/A4/SDA
SDA_I2C2: TEENSY_3.5.4/CANRX
SP1: ARDUINO_PRO_MINI.20 (A3), S1.1 (OUT)
SP2: ARDUINO_PRO_MINI.19 (A2), S2.1 (OUT)
SP3: ARDUINO_PRO_MINI.18 (A1), S3.1 (OUT)
SP4: ARDUINO_PRO_MINI.17 (A0), S4.1 (OUT)
SP5: ARDUINO_PRO_MINI.16 (13), S5.1 (OUT)
SP6: ARDUINO_PRO_MINI.15 (12), S6.1 (OUT)
SP7: ARDUINO_PRO_MINI.14 (*11), S7.1 (OUT)
SP8: ARDUINO_PRO_MINI.13 (*10), S8.1 (OUT)
SP9: ARDUINO_PRO_MINI.12 (*9), S9.1 (OUT)
SP10: ARDUINO_PRO_MINI.11 (8), S10.1 (OUT)
SP11: ARDUINO_PRO_MINI.10 (7), S11.1 (OUT)
SP12: ARDUINO_PRO_MINI.9 (*6), S12.1 (OUT)
SP13: ARDUINO_PRO_MINI.8 (*5), S13.1 (OUT)
SP14: ARDUINO_PRO_MINI.7 (4), S14.1 (OUT)
SP15: ARDUINO_PRO_MINI.6 (*3), S15.1 (OUT)
SP16: ARDUINO_PRO_MINI.5 (2), S16.1 (OUT)
SW_DX: R_SW_DX.2, SW_DX.2, TEENSY_3.5.29
SW_SX: R_SW_SX.2, SW_SX.2, TEENSY_3.5.28
TX1: TEENSY_3.5.1/TX
TX2: TEENSY_3.5.10/CS, U$2.16 (RXD/SDA)
TX3: BLUETOOTH.2, TEENSY_3.5.8
TX4: ARDUINO_PRO_MINI.2 (RXI), TEENSY_3.5.32/A13

Notes on the sheet:
BALL_SENSOR_1
TEENSY_3.5
BUZZER
BALL_SENSOR_2
BALL_SENSOR_3
BALL_SENSOR_4
IMU
SWITCH

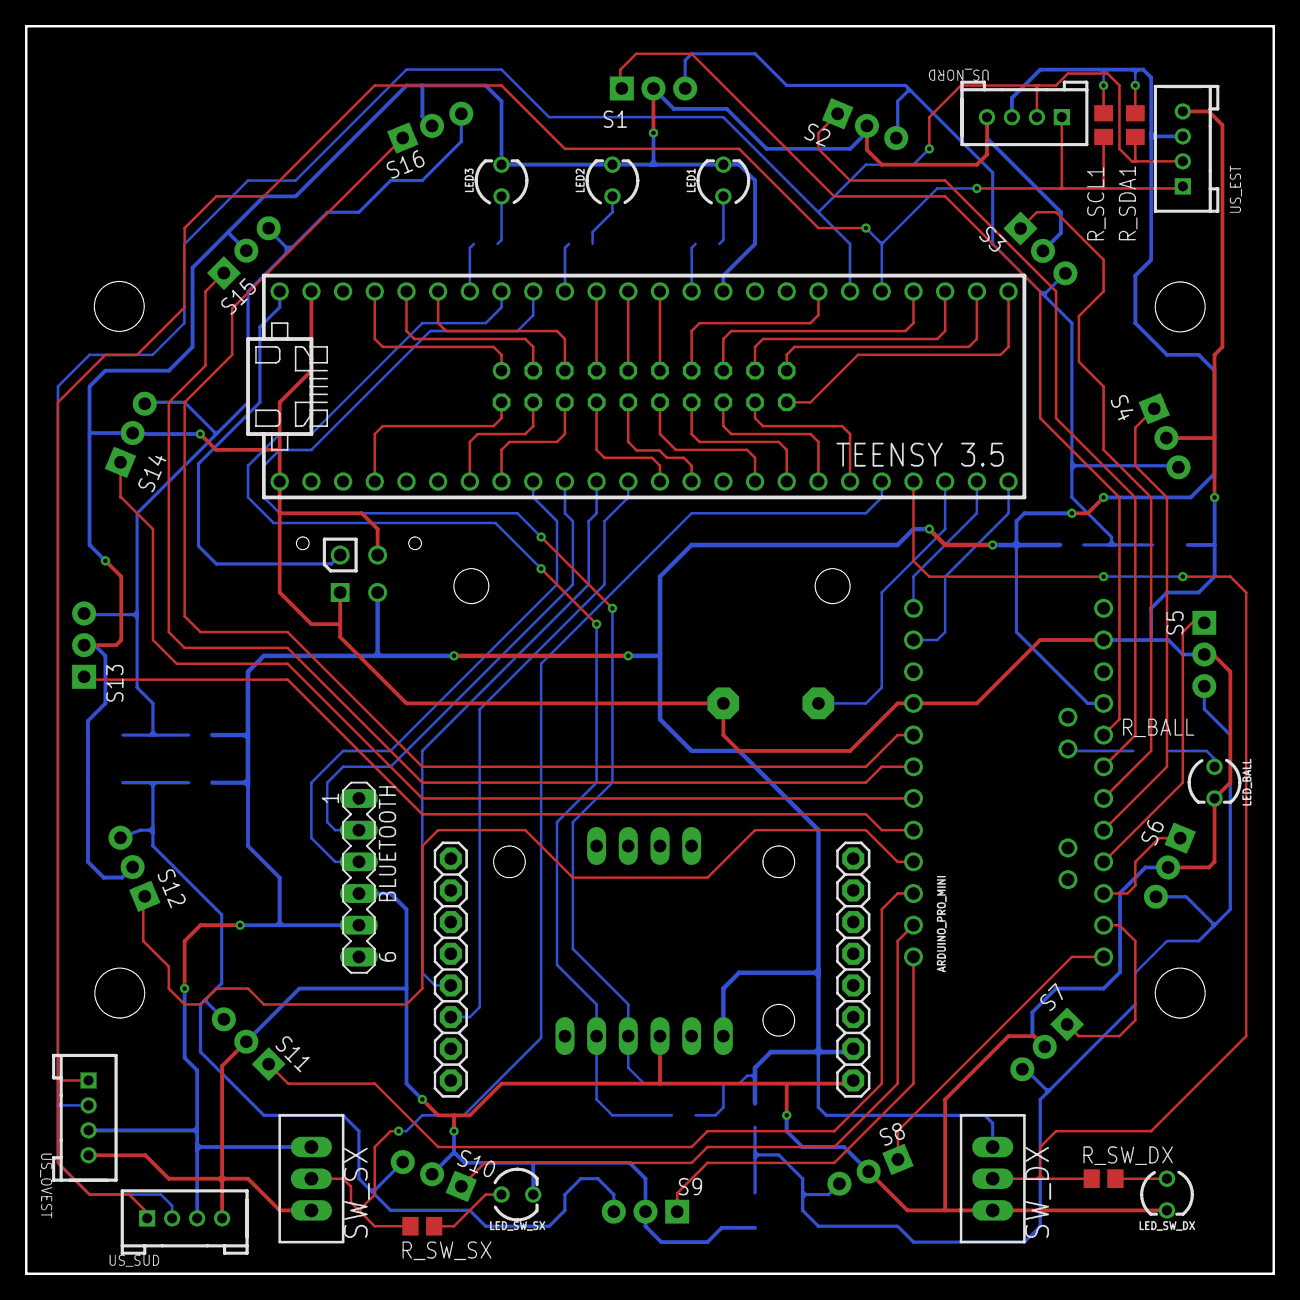
[picture p163: board Test 2019.brd from above]

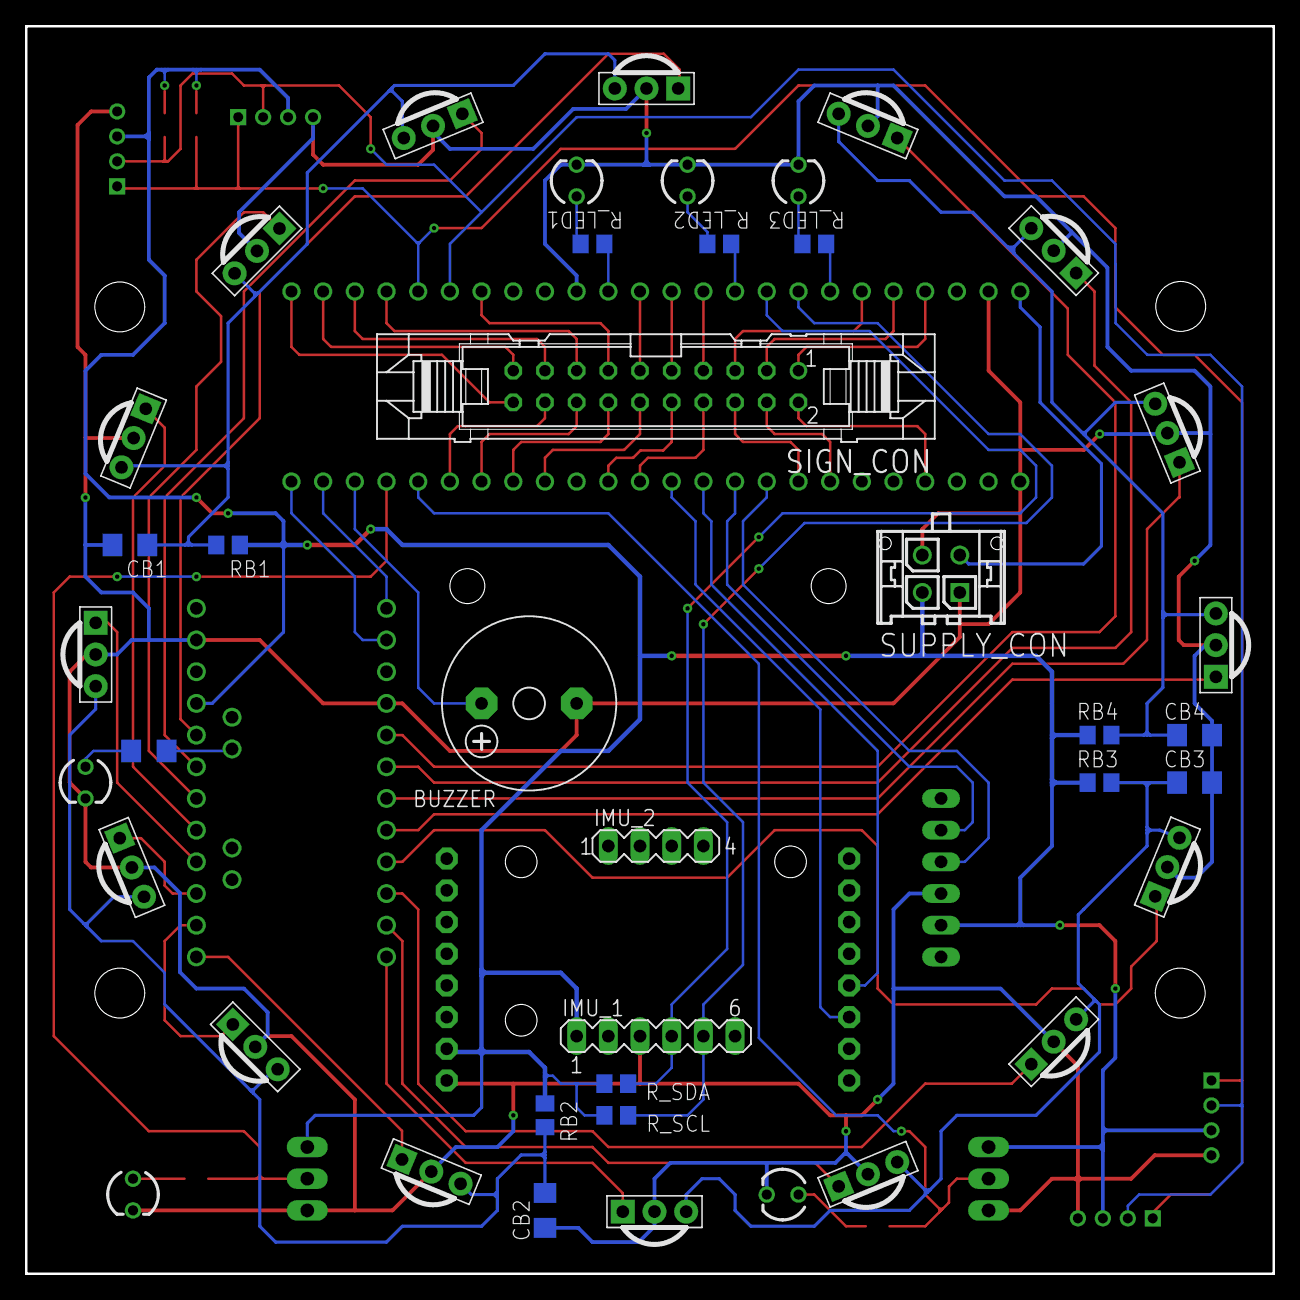
[picture p164: board Test 2019.brd from below]

Board: 2 copper layers, 100.0 x 100.0 mm, 55 parts (35 on the bottom side), 66 nets.
