latino-deluxe/SPQR-Team-2019/Eagle/Sidney 2019 boards/Line sensors (gerber layout).brd

## EAGLE design Eagle/Sidney 2019 boards/Line sensors (gerber layout).brd (2019-05-24)

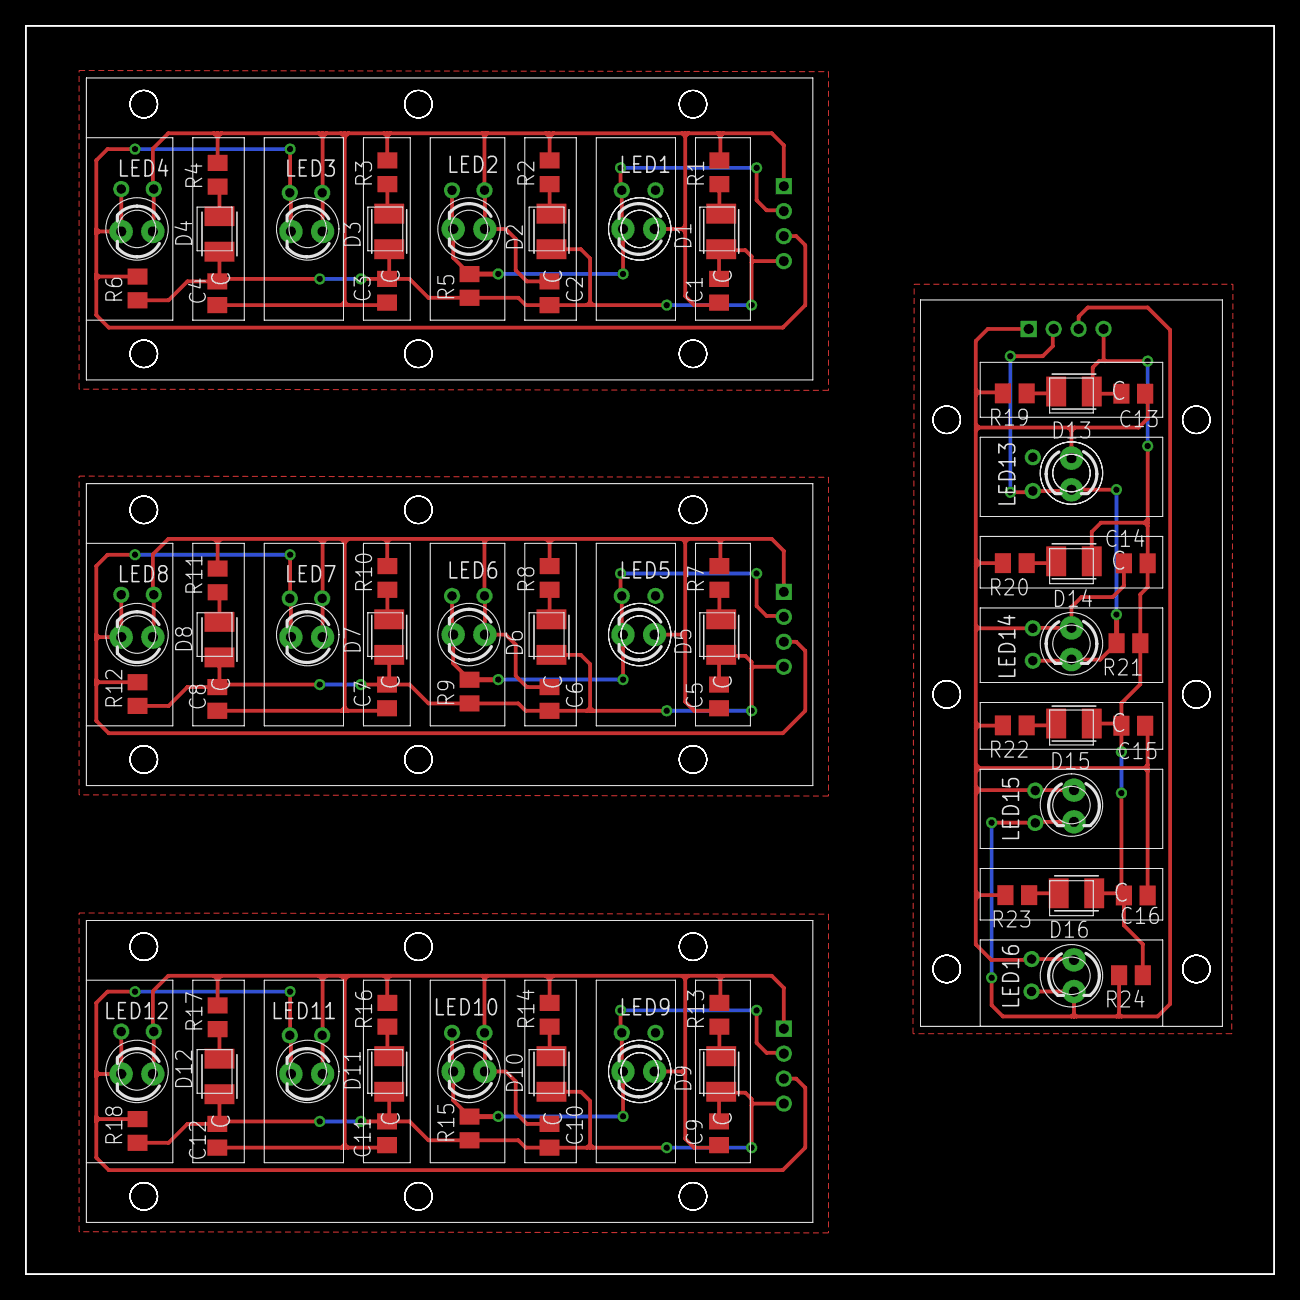
[picture p165: board Line sensors (gerber layout).brd from above]

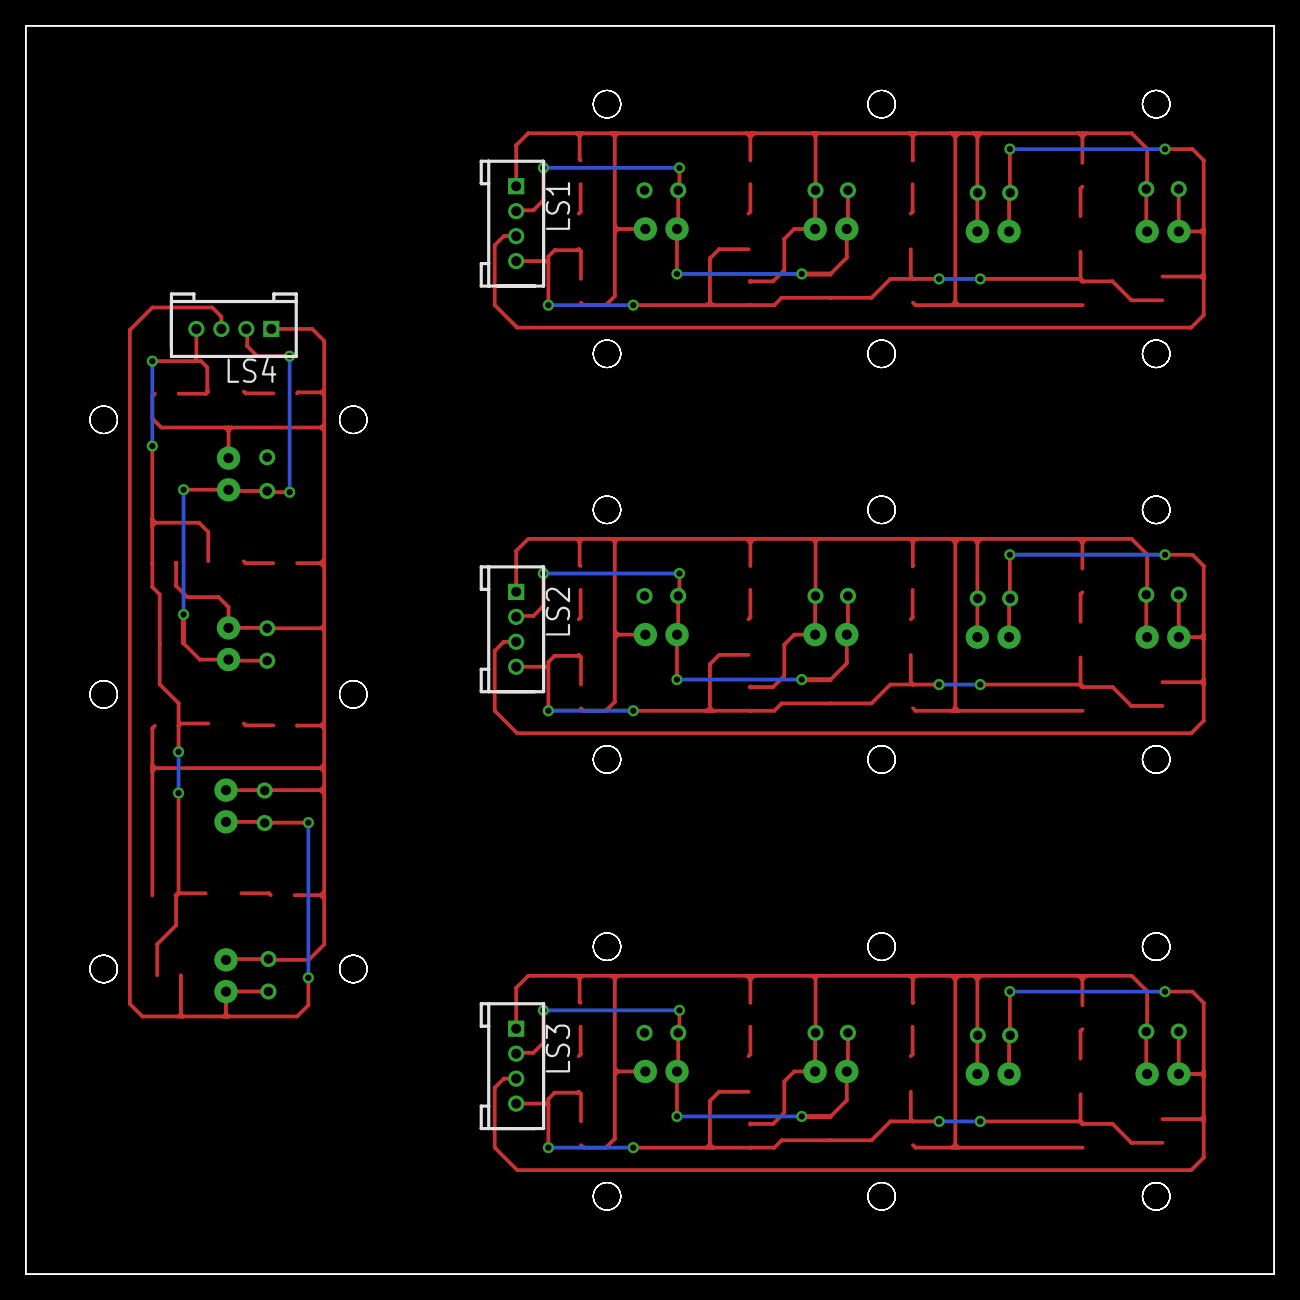
[picture p166: board Line sensors (gerber layout).brd from below]

Board: 2 copper layers, 100.0 x 100.0 mm, 76 parts (4 on the bottom side), 32 nets.

Parts:
C1, C2, C3, C4, C5, C6, C7, C8, C9, C10, C11, C12, C13, C14, C15, C16: 100n; M0805
D1, D2, D3, D4, D5, D6, D7, D8, D9, D10, D11, D12, D13, D14, D15, D16: 3528-2PIN
LED1, LED2, LED3, LED4, LED5, LED6, LED7, LED8, LED9, LED10, LED11, LED12, LED13, LED14, LED15, LED16: LED3MM
LS1, LS2, LS3, LS4: 4P-2.0
R1, R2, R3, R4, R7, R8, R10, R11, R13, R14, R16, R17, R19, R20, R22, R23: 330; M0805
R5, R6, R9, R12, R15, R18, R21, R24: 10k; M0805

Connections:
5V: C1.2, C2.2, C3.2, C4.2, LED1.A, LED2.A, LED3.A, LED4.A, LS1.1, R1.2, R2.2, R3.2, R4.2
5V1: C5.2, C6.2, C7.2, C8.2, LED5.A, LED6.A, LED7.A, LED8.A, LS2.1, R7.2, R8.2, R10.2, R11.2
5V2: C9.2, C10.2, C11.2, C12.2, LED9.A, LED10.A, LED11.A, LED12.A, LS3.1, R13.2, R14.2, R16.2, R17.2
5V3: C13.2, C14.2, C15.2, C16.2, LED13.A, LED14.A, LED15.A, LED16.A, LS4.1, R19.2, R20.2, R22.2, R23.2
GND: C1.1, C2.1, C3.1, C4.1, D1.1, D2.1, D3.1, D4.1, LS1.4, R5.1, R6.1
GND1: C5.1, C6.1, C7.1, C8.1, D5.1, D6.1, D7.1, D8.1, LS2.4, R9.1, R12.1
GND2: C9.1, C10.1, C11.1, C12.1, D9.1, D10.1, D11.1, D12.1, LS3.4, R15.1, R18.1
GND3: C13.1, C14.1, C15.1, C16.1, D13.1, D14.1, D15.1, D16.1, LS4.4, R21.1, R24.1
unnamed: D5.2, R7.1
unnamed: D6.2, R8.1
unnamed: D1.2, R1.1
unnamed: D2.2, R2.1
unnamed: D7.2, R10.1
unnamed: D8.2, R11.1
unnamed: D9.2, R13.1
unnamed: D10.2, R14.1
unnamed: D11.2, R16.1
unnamed: D12.2, R17.1
unnamed: D3.2, R3.1
unnamed: D13.2, R19.1
unnamed: D14.2, R20.1
unnamed: D4.2, R4.1
unnamed: D15.2, R22.1
unnamed: D16.2, R23.1
SIG1: LED1.K, LED2.K, LS1.2, R5.2
SIG2: LED3.K, LED4.K, LS1.3, R6.2
SIG3: LED5.K, LED6.K, LS2.2, R9.2
SIG4: LED7.K, LED8.K, LS2.3, R12.2
SIG5: LED9.K, LED10.K, LS3.2, R15.2
SIG6: LED11.K, LED12.K, LS3.3, R18.2
SIG7: LED13.K, LED14.K, LS4.2, R21.2
SIG8: LED15.K, LED16.K, LS4.3, R24.2
