latino-deluxe/SPQR-Team-2019/(commit log)

2018-12-13 proviamo il fetch
2018-12-13 test per il fetch da account collaboratore
2018-12-17 goalie e pid da sistemare mercoledì, se decommentati non compila.
2018-12-19 goalie e pid ora compilano, sistemati gli include. leggi il changelog
2018-12-19 Aggiunto position.h per iniziare a lavorare coi motori
2018-12-19 Alta impedenza e test motori ---> motore 2 non va in senso orario
2019-01-01 Adding utility code (SPI, AVR12, etc)
2019-01-07 Changed our spi name to myspi,name conflicts with SPI.h library on Win
2019-01-09 SPI con interpolazione nello slave. Reintegrazione ultrasuoni
2019-01-09 Ritorna centro in interrupt (è npo' na ciofeca)
2019-01-09 Integrate variabili Where Am I ed è tornata la funzione UpdateSensorsAll
2019-01-09 Test SPI nuovo in loop. da provare nuovo US I2C
2019-05-08 aggiunti file al branch
    [teensy robotica.sch, uC board Mini.brd, uC board Mini.sch]
2019-05-08 File fusion
    [ROBOT 2019 completo v1.f3d]
2019-05-09 slight improvements on the top PCB
    [uC board Mini.brd]
2019-05-13 added motor board schematic
    [Motor board.sch]
2019-05-13 added supply switches to motor board
2019-05-13 supply improvements in motor board
    [Motor board.sch]
2019-05-13 general improvements to the boards
    [Motor board.brd, Motor board.sch, uC board Mini.brd, uC board Mini.sch]
2019-05-13 finished motor drivers (schematic)
    [Motor board.sch, uC board Mini.sch]
2019-05-13 completed motor board schematic
    [Motor board.sch]
2019-05-13 added motor board DXF file
    [Motor board.dxf, Motor board.sch, teensy robotica.sch]
2019-05-13 motor board began
2019-05-14 began supply circuit
    [Motor board.brd, Motor board.sch]
2019-05-14 added line sensors schematic and board
    [Line sensors.brd, Line sensors.sch]
2019-05-15 added team members list
    [uC board.brd, uC board.sch]
2019-05-15 began motor board components list
2019-05-17 worked on supply
    [Motor board.dxf, Motor board.sch]
2019-05-17 completed supply and component list for motor board
    [Motor board.brd, Motor board.sch, uC board.brd]
2019-05-17 fixed some missing traces
2019-05-21 added old boards for parts
    [Teensy board v2.brd, Teensy board v2.sch, Teensy board.brd, Teensy board.sch, Test 2019.brd, Test 2019.sch]
2019-05-21 Finished uC board (fixed supply to give infrared and US sensors stable 5V)
    [uC board.sch]
2019-05-21 Began components list for uC board
2019-05-21 Finished components lists for both boards and fixed line sensors' connectors pinout
    [Motor board.brd, Motor board.sch, uC board.brd, uC board.sch]
2019-05-21 Finished motor board, deleted useless files, added parts in components lists for both boards and other stuff
    [Motor board.brd, Motor board.sch]
2019-05-22 Fixed line sensors issue
2019-05-22 Added grove connectors for auxiliary supply
    [Motor board.brd, Motor board.sch, uC board.brd, uC board.sch]
2019-05-22 Small improvements on the motor board
    [Motor board.dxf]
2019-05-22 Almost completed components lists
    [Line sensors.brd, Line sensors.sch, uC board.brd, uC board.dxf]
2019-05-22 Finished RS components lists
    [Motor board.dxf, uC board.dxf]
2019-05-22 Fixed error on uC board
2019-05-22 Fixed polygon near battery causing a short circuit
    [Motor board.brd]
2019-05-23 Started working on line sensors's 3.3V supply
    [Motor board.brd]
2019-05-23 Working on vias, removed empty portions of the motor board, added 3,3V LDO regulator for line sensors
    [Line sensors gerber.brd, Motor board.brd, Motor board.sch]
2019-05-23 Removed old files and gerber generation tests, added Giulia main board (for SPQR and school's symbols)
    [Line sensors gerber.brd, Main board Giulia.brd, Main board Giulia.sch]
2019-05-23 Fixed motor driver pin hardly connected to ground
    [Motor board.brd]
2019-05-23 Created DXFs, PDFs and PNGs, small improvements to line sensors board
    [Line sensors.brd, Line sensors.dxf, Motor board.brd, Motor board.dxf, uC board.dxf]
2019-05-24 Made hole smaller to have bigger top ground plane on motor board
    [Motor board.brd, Motor board.dxf]
2019-05-24 Fixed thin ground trace near battery power
    [Motor board.brd]
2019-05-24 Created line sensors layout for gerber generation. Added logos to uC and motor PCBs. Generater and uploaded on PCBWAY every gerber
    [Line sensors (gerber layout).brd, Motor board.brd, uC board.brd]
2019-06-07 Added issues list, fixed uC board short to ground
    [uC board.brd]
2019-06-11 Added boards PDFs for documentation
    [Line sensors.brd, Motor board.brd, uC board.brd]
2019-06-23 added frontpage without team photo and tidied up the folders
    [Grove - Infrared Reflective Sensor.brd, Grove - Infrared Reflective Sensor.sch]
2019-06-25 fixed power supply and misc errors, added main flowchart, todo on zenhub
2019-06-27 aggiunto test us per il piccolo dario che non sa cambiare branch
2019-06-27 added triangle frames and continued the portfolio (don't need in but keep it)
2019-06-28 finally, bible. added the all left format (heckinbiblepagALLLEFT.pdf. choose what to print and have a nice journey
