latino-deluxe/SPQR-Team-2019/(notices)

Notices in the files:
parts and their libraries:
SparkFun-Boards: Licensing: Creative Commons ShareAlike 4.0 International - https://creativecommons.org/licenses/by-sa/4.0
Wurth_Elektronik_Optoelectronics_rev15b: Copyright: Würth Elektronik
SparkFun: Licensing: CC v3.0 Share-Alike You are welcome to use this library for commercial purposes.
